SentinelPolaris/ECE115project/Mechanical/Motor/Readme.md

Servo CAD Files acquired and modified from https://grabcad.com/library/150-1-micromotor-gearbox-n20-1
Credit: Sergey Torshin (https://grabcad.com/benjamin.galindo-1)
