SentinelPolaris/ECE115project/Mechanical/Solenoid/Readme.md

Servo CAD Files acquired and modified from https://grabcad.com/library/xrn-0530-12v-solenoid-1
Credit: Greg Esau (https://grabcad.com/library/xrn-0530-12v-solenoid-1)
