SentinelPolaris/ECE115project/Mechanical/Servo/Readme.md

Servo CAD Files acquired and modified from https://grabcad.com/library/tower-pro-sg90-micro-servo-2
Credit: Sergey Torshin (https://grabcad.com/sergey.torshin-1)
