SentinelPolaris/ECE115project/Software/Pinball/CMakeListsPrivate.txt

# !!! WARNING !!! AUTO-GENERATED FILE, PLEASE DO NOT MODIFY IT AND USE
# https://docs.platformio.org/page/projectconf/section_env_build.html#build-flags
#
# If you need to override existing CMake configuration or add extra,
# please create `CMakeListsUser.txt` in the root of project.
# The `CMakeListsUser.txt` will not be overwritten by PlatformIO.

set(CMAKE_CONFIGURATION_TYPES "teensy40" CACHE STRING "" FORCE)

set(PLATFORMIO_CMD "/usr/local/bin/pio")

SET(CMAKE_C_COMPILER "$ENV{HOME}/.platformio/packages/toolchain-gccarmnoneeabi/bin/arm-none-eabi-gcc")
SET(CMAKE_CXX_COMPILER "$ENV{HOME}/.platformio/packages/toolchain-gccarmnoneeabi/bin/arm-none-eabi-g++")
SET(CMAKE_CXX_FLAGS "-fno-exceptions -felide-constructors -fno-rtti -std=gnu++14 -Wno-error=narrowing -fpermissive -Wall -ffunction-sections -fdata-sections -mthumb -mcpu=cortex-m7 -nostdlib -fsingle-precision-constant -mfloat-abi=hard -mfpu=fpv5-d16 -O2")
SET(CMAKE_C_FLAGS "-Wall -ffunction-sections -fdata-sections -mthumb -mcpu=cortex-m7 -nostdlib -fsingle-precision-constant -mfloat-abi=hard -mfpu=fpv5-d16 -O2")

set(CMAKE_CXX_STANDARD 14)

if (CMAKE_BUILD_TYPE MATCHES "teensy40")
    add_definitions(-D'PLATFORMIO=40201')
    add_definitions(-D'__IMXRT1062__')
    add_definitions(-D'TEENSY40')
    add_definitions(-D'USB_SERIAL')
    add_definitions(-D'ARDUINO=10805')
    add_definitions(-D'TEENSYDUINO=149')
    add_definitions(-D'CORE_TEENSY')
    add_definitions(-D'F_CPU=600000000')
    add_definitions(-D'LAYOUT_US_ENGLISH')

    include_directories("${CMAKE_CURRENT_LIST_DIR}/src")
    include_directories("$ENV{HOME}/.platformio/packages/framework-arduinoteensy/libraries/Audio")
    include_directories("$ENV{HOME}/.platformio/packages/framework-arduinoteensy/libraries/Audio/utility")
    include_directories("$ENV{HOME}/.platformio/packages/framework-arduinoteensy/libraries/SD")
    include_directories("$ENV{HOME}/.platformio/packages/framework-arduinoteensy/libraries/SD/utility")
    include_directories("$ENV{HOME}/.platformio/packages/framework-arduinoteensy/libraries/SerialFlash")
    include_directories("$ENV{HOME}/.platformio/packages/framework-arduinoteensy/libraries/SPI")
    include_directories("${CMAKE_CURRENT_LIST_DIR}/include")
    include_directories("${CMAKE_CURRENT_LIST_DIR}/lib/FreeRTOS-Teensy4-runtime_stats/src")
    include_directories("${CMAKE_CURRENT_LIST_DIR}/.pio/libdeps/teensy40/Adafruit MCP23017 Arduino Library_ID334")
    include_directories("${CMAKE_CURRENT_LIST_DIR}/.pio/libdeps/teensy40/Adafruit PWM Servo Driver Library_ID30")
    include_directories("$ENV{HOME}/.platformio/packages/framework-arduinoteensy/libraries/Wire")
    include_directories("$ENV{HOME}/.platformio/packages/framework-arduinoteensy/libraries/Wire/utility")
    include_directories("$ENV{HOME}/.platformio/packages/framework-arduinoteensy/cores/teensy4")
    include_directories("$ENV{HOME}/.platformio/lib/Adafruit Motor Shield V2 Library_ID783")
    include_directories("$ENV{HOME}/.platformio/lib/Adafruit Motor Shield V2 Library_ID783/utility")
    include_directories("$ENV{HOME}/.platformio/lib/TimerOne_ID131")
    include_directories("$ENV{HOME}/.platformio/packages/framework-arduinoteensy/libraries/ADC")
    include_directories("$ENV{HOME}/.platformio/packages/framework-arduinoteensy/libraries/AccelStepper/src")
    include_directories("$ENV{HOME}/.platformio/packages/framework-arduinoteensy/libraries/Adafruit_CC3000")
    include_directories("$ENV{HOME}/.platformio/packages/framework-arduinoteensy/libraries/Adafruit_CC3000/utility")
    include_directories("$ENV{HOME}/.platformio/packages/framework-arduinoteensy/libraries/Adafruit_GFX")
    include_directories("$ENV{HOME}/.platformio/packages/framework-arduinoteensy/libraries/Adafruit_NeoPixel")
    include_directories("$ENV{HOME}/.platformio/packages/framework-arduinoteensy/libraries/Adafruit_RA8875")
    include_directories("$ENV{HOME}/.platformio/packages/framework-arduinoteensy/libraries/Adafruit_STMPE610")
    include_directories("$ENV{HOME}/.platformio/packages/framework-arduinoteensy/libraries/Adafruit_VS1053")
    include_directories("$ENV{HOME}/.platformio/packages/framework-arduinoteensy/libraries/Adafruit_nRF8001")
    include_directories("$ENV{HOME}/.platformio/packages/framework-arduinoteensy/libraries/Adafruit_nRF8001/utility")
    include_directories("$ENV{HOME}/.platformio/packages/framework-arduinoteensy/libraries/AltSoftSerial")
    include_directories("$ENV{HOME}/.platformio/packages/framework-arduinoteensy/libraries/Artnet")
    include_directories("$ENV{HOME}/.platformio/packages/framework-arduinoteensy/libraries/Bounce")
    include_directories("$ENV{HOME}/.platformio/packages/framework-arduinoteensy/libraries/Bounce2")
    include_directories("$ENV{HOME}/.platformio/packages/framework-arduinoteensy/libraries/CapacitiveSensor")
    include_directories("$ENV{HOME}/.platformio/packages/framework-arduinoteensy/libraries/CryptoAccel/src")
    include_directories("$ENV{HOME}/.platformio/packages/framework-arduinoteensy/libraries/DS1307RTC")
    include_directories("$ENV{HOME}/.platformio/packages/framework-arduinoteensy/libraries/DmxSimple")
    include_directories("$ENV{HOME}/.platformio/packages/framework-arduinoteensy/libraries/DogLcd")
    include_directories("$ENV{HOME}/.platformio/packages/framework-arduinoteensy/libraries/EEPROM")
    include_directories("$ENV{HOME}/.platformio/packages/framework-arduinoteensy/libraries/EasyTransfer")
    include_directories("$ENV{HOME}/.platformio/packages/framework-arduinoteensy/libraries/EasyTransferI2C")
    include_directories("$ENV{HOME}/.platformio/packages/framework-arduinoteensy/libraries/Encoder")
    include_directories("$ENV{HOME}/.platformio/packages/framework-arduinoteensy/libraries/Encoder/utility")
    include_directories("$ENV{HOME}/.platformio/packages/framework-arduinoteensy/libraries/Entropy")
    include_directories("$ENV{HOME}/.platformio/packages/framework-arduinoteensy/libraries/Ethernet/src")
    include_directories("$ENV{HOME}/.platformio/packages/framework-arduinoteensy/libraries/FastCRC")
    include_directories("$ENV{HOME}/.platformio/packages/framework-arduinoteensy/libraries/FastLED")
    include_directories("$ENV{HOME}/.platformio/packages/framework-arduinoteensy/libraries/FlexCAN")
    include_directories("$ENV{HOME}/.platformio/packages/framework-arduinoteensy/libraries/FlexCAN_T4")
    include_directories("$ENV{HOME}/.platformio/packages/framework-arduinoteensy/libraries/FlexiTimer2")
    include_directories("$ENV{HOME}/.platformio/packages/framework-arduinoteensy/libraries/FreqCount")
    include_directories("$ENV{HOME}/.platformio/packages/framework-arduinoteensy/libraries/FreqMeasure")
    include_directories("$ENV{HOME}/.platformio/packages/framework-arduinoteensy/libraries/FreqMeasureMulti")
    include_directories("$ENV{HOME}/.platformio/packages/framework-arduinoteensy/libraries/FrequencyTimer2")
    include_directories("$ENV{HOME}/.platformio/packages/framework-arduinoteensy/libraries/ILI9341_t3")
    include_directories("$ENV{HOME}/.platformio/packages/framework-arduinoteensy/libraries/ILI9488_t3")
    include_directories("$ENV{HOME}/.platformio/packages/framework-arduinoteensy/libraries/IRremote")
    include_directories("$ENV{HOME}/.platformio/packages/framework-arduinoteensy/libraries/Keypad/src")
    include_directories("$ENV{HOME}/.platformio/packages/framework-arduinoteensy/libraries/LedControl/src")
    include_directories("$ENV{HOME}/.platformio/packages/framework-arduinoteensy/libraries/LedDisplay")
    include_directories("$ENV{HOME}/.platformio/packages/framework-arduinoteensy/libraries/LiquidCrystal/src")
    include_directories("$ENV{HOME}/.platformio/packages/framework-arduinoteensy/libraries/LiquidCrystalFast")
    include_directories("$ENV{HOME}/.platformio/packages/framework-arduinoteensy/libraries/LowPower")
    include_directories("$ENV{HOME}/.platformio/packages/framework-arduinoteensy/libraries/MFRC522/src")
    include_directories("$ENV{HOME}/.platformio/packages/framework-arduinoteensy/libraries/MIDI/src")
    include_directories("$ENV{HOME}/.platformio/packages/framework-arduinoteensy/libraries/Metro")
    include_directories("$ENV{HOME}/.platformio/packages/framework-arduinoteensy/libraries/MsTimer2")
    include_directories("$ENV{HOME}/.platformio/packages/framework-arduinoteensy/libraries/NXPMotionSense")
    include_directories("$ENV{HOME}/.platformio/packages/framework-arduinoteensy/libraries/NXPMotionSense/utility")
    include_directories("$ENV{HOME}/.platformio/packages/framework-arduinoteensy/libraries/OSC")
    include_directories("$ENV{HOME}/.platformio/packages/framework-arduinoteensy/libraries/OctoWS2811")
    include_directories("$ENV{HOME}/.platformio/packages/framework-arduinoteensy/libraries/OneWire")
    include_directories("$ENV{HOME}/.platformio/packages/framework-arduinoteensy/libraries/PS2Keyboard")
    include_directories("$ENV{HOME}/.platformio/packages/framework-arduinoteensy/libraries/PS2Keyboard/utility")
    include_directories("$ENV{HOME}/.platformio/packages/framework-arduinoteensy/libraries/PWMServo")
    include_directories("$ENV{HOME}/.platformio/packages/framework-arduinoteensy/libraries/Ping")
    include_directories("$ENV{HOME}/.platformio/packages/framework-arduinoteensy/libraries/PulsePosition")
    include_directories("$ENV{HOME}/.platformio/packages/framework-arduinoteensy/libraries/QuadEncoder")
    include_directories("$ENV{HOME}/.platformio/packages/framework-arduinoteensy/libraries/RA8875")
    include_directories("$ENV{HOME}/.platformio/packages/framework-arduinoteensy/libraries/RadioHead")
    include_directories("$ENV{HOME}/.platformio/packages/framework-arduinoteensy/libraries/ResponsiveAnalogRead/src")
    include_directories("$ENV{HOME}/.platformio/packages/framework-arduinoteensy/libraries/SPIFlash")
    include_directories("$ENV{HOME}/.platformio/packages/framework-arduinoteensy/libraries/ST7565")
    include_directories("$ENV{HOME}/.platformio/packages/framework-arduinoteensy/libraries/ST7735_t3")
    include_directories("$ENV{HOME}/.platformio/packages/framework-arduinoteensy/libraries/Servo")
    include_directories("$ENV{HOME}/.platformio/packages/framework-arduinoteensy/libraries/ShiftPWM")
    include_directories("$ENV{HOME}/.platformio/packages/framework-arduinoteensy/libraries/Snooze/src")
    include_directories("$ENV{HOME}/.platformio/packages/framework-arduinoteensy/libraries/SoftPWM")
    include_directories("$ENV{HOME}/.platformio/packages/framework-arduinoteensy/libraries/SoftwareSerial")
    include_directories("$ENV{HOME}/.platformio/packages/framework-arduinoteensy/libraries/TFT_ILI9163C")
    include_directories("$ENV{HOME}/.platformio/packages/framework-arduinoteensy/libraries/Talkie")
    include_directories("$ENV{HOME}/.platformio/packages/framework-arduinoteensy/libraries/TeensyThreads")
    include_directories("$ENV{HOME}/.platformio/packages/framework-arduinoteensy/libraries/Time")
    include_directories("$ENV{HOME}/.platformio/packages/framework-arduinoteensy/libraries/TimeAlarms")
    include_directories("$ENV{HOME}/.platformio/packages/framework-arduinoteensy/libraries/TimerOne")
    include_directories("$ENV{HOME}/.platformio/packages/framework-arduinoteensy/libraries/TimerThree")
    include_directories("$ENV{HOME}/.platformio/packages/framework-arduinoteensy/libraries/TinyGPS")
    include_directories("$ENV{HOME}/.platformio/packages/framework-arduinoteensy/libraries/Tlc5940")
    include_directories("$ENV{HOME}/.platformio/packages/framework-arduinoteensy/libraries/TouchScreen")
    include_directories("$ENV{HOME}/.platformio/packages/framework-arduinoteensy/libraries/USBHost_t36")
    include_directories("$ENV{HOME}/.platformio/packages/framework-arduinoteensy/libraries/USBHost_t36/utility")
    include_directories("$ENV{HOME}/.platformio/packages/framework-arduinoteensy/libraries/UTFT")
    include_directories("$ENV{HOME}/.platformio/packages/framework-arduinoteensy/libraries/VirtualWire")
    include_directories("$ENV{HOME}/.platformio/packages/framework-arduinoteensy/libraries/WS2812Serial")
    include_directories("$ENV{HOME}/.platformio/packages/framework-arduinoteensy/libraries/XBee")
    include_directories("$ENV{HOME}/.platformio/packages/framework-arduinoteensy/libraries/XPT2046_Touchscreen")
    include_directories("$ENV{HOME}/.platformio/packages/framework-arduinoteensy/libraries/i2c_t3")
    include_directories("$ENV{HOME}/.platformio/packages/framework-arduinoteensy/libraries/ks0108")
    include_directories("$ENV{HOME}/.platformio/packages/framework-arduinoteensy/libraries/openGLCD")
    include_directories("$ENV{HOME}/.platformio/packages/framework-arduinoteensy/libraries/ssd1351")
    include_directories("$ENV{HOME}/.platformio/packages/framework-arduinoteensy/libraries/x10")
    include_directories("$ENV{HOME}/.platformio/packages/toolchain-gccarmnoneeabi/arm-none-eabi/include")
    include_directories("$ENV{HOME}/.platformio/packages/toolchain-gccarmnoneeabi/arm-none-eabi/include/c++/5.4.1")
    include_directories("$ENV{HOME}/.platformio/packages/toolchain-gccarmnoneeabi/arm-none-eabi/include/c++/5.4.1/arm-none-eabi")
    include_directories("$ENV{HOME}/.platformio/packages/toolchain-gccarmnoneeabi/lib/gcc/arm-none-eabi/5.4.1/include")
    include_directories("$ENV{HOME}/.platformio/packages/toolchain-gccarmnoneeabi/lib/gcc/arm-none-eabi/5.4.1/include-fixed")
    include_directories("$ENV{HOME}/.platformio/packages/tool-unity")
endif()

FILE(GLOB_RECURSE SRC_LIST "${CMAKE_CURRENT_LIST_DIR}/src/*.*" "${CMAKE_CURRENT_LIST_DIR}/lib/*.*" "${CMAKE_CURRENT_LIST_DIR}/.pio/libdeps/teensy40/*.*")
