SentinelPolaris/ECE115project/Software/Pinball/CMakeListsUser.txt

message("CMakeListsUser!")
include_directories(${CMAKE_CURRENT_LIST_DIR}/lib/FreeRTOS-Teensy4-runtime_stats/src)
