SentinelPolaris/ECE115project/Mechanical/ServoRamp.SLDASM

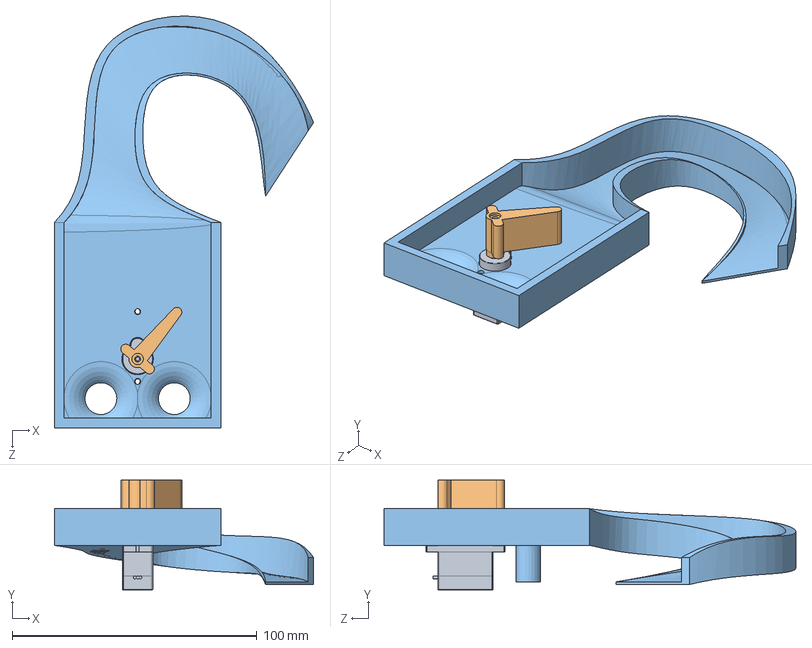
[picture p1: CAD file, 2020-03-10]
Mechanical/ServoRamp.SLDASM
105.9 x 44.9 x 168.4 mm
microservoSG90
microservoArm
RampTop
