SentinelPolaris/ECE115project/Mechanical/Final.SLDASM

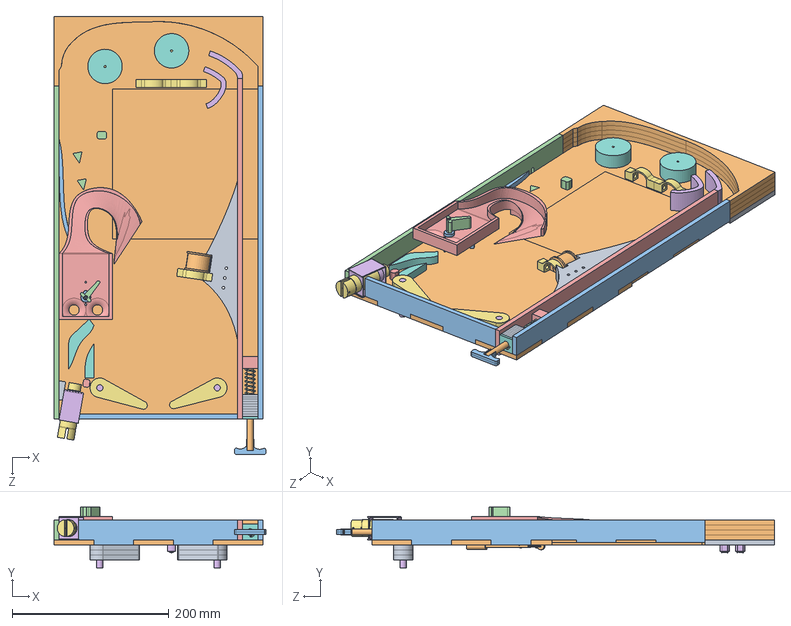
[picture p2: CAD file, 2020-03-10]
Mechanical/Final.SLDASM
270.4 x 77.3 x 559.5 mm
FrameTopWallBottom
FrameTopWallTop x 4
FrameSideWallRight
FrameSideWallLeft
FrameTunnelWall
EMGuide
IRGate x 3
base plate
hole plate x 9
PlungerRod
pullhandle x 2
spring
tip_v2
flipper_rod x 2
flipper_arm x 4
bearing x 2
flipper_back x 6
FrameBottomPlate
microservoSG90
microservoArm
RampTop
TAU-1040T
TAU-1040T Plunger
RampGuide
SolenoidGuide
MagneticLauncher
SliderGuide
IRGateHalf
IRGateHalfSolenoid
Motor x 2
Brazo x 2
N20Wheel x 2
EMlauncherGuide
PanelAcrylic
FrameBottomWall
SliderAcrylic x 2
