SentinelPolaris/ECE115project/Mechanical/N20.SLDASM

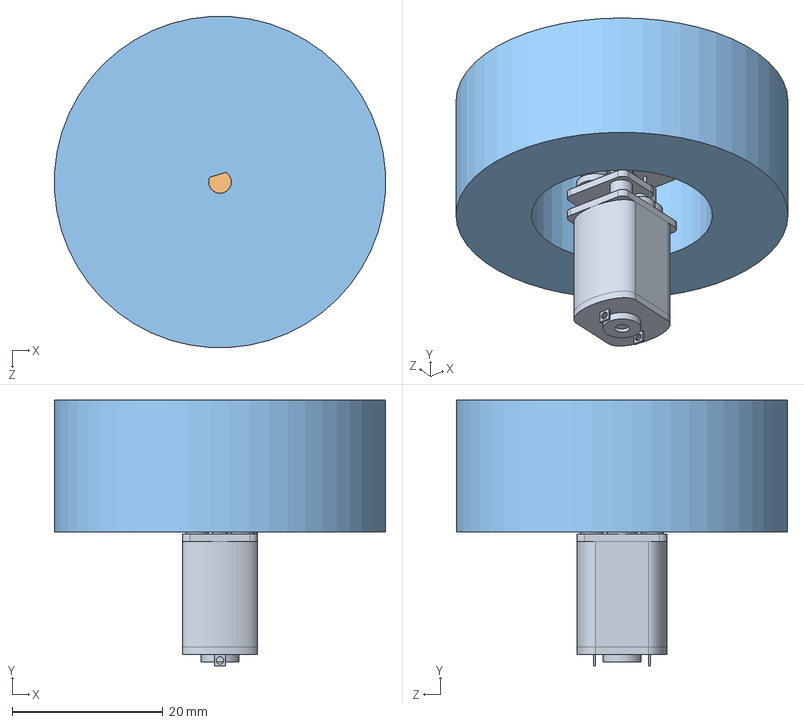
[picture p3: CAD file, 2020-02-17]
Mechanical/N20.SLDASM
43.9 x 35.3 x 43.9 mm
Motor
Brazo
N20Wheel
