SentinelPolaris/ECE115project/Mechanical/FlipperRight.SLDASM

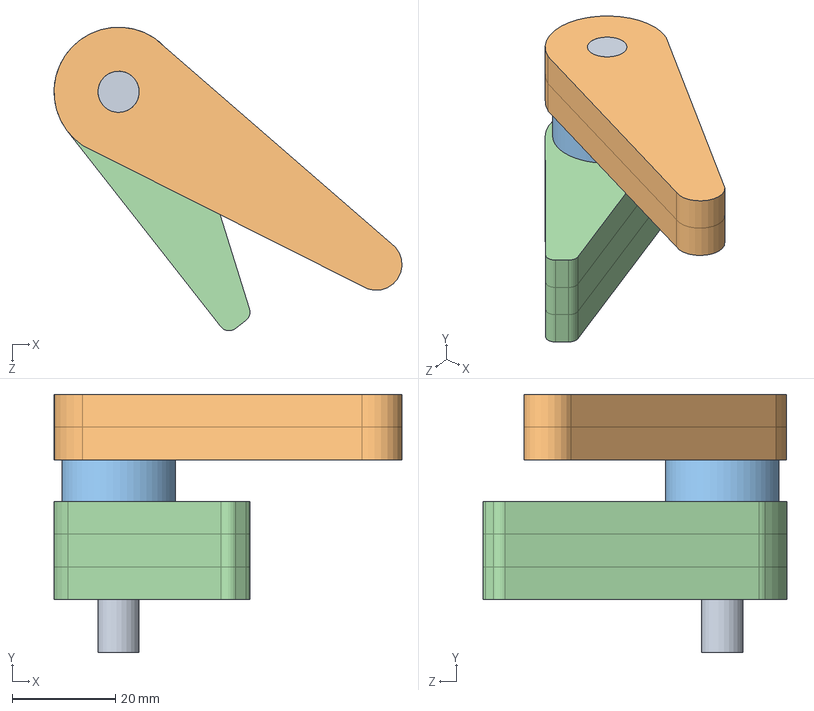
[picture p4: CAD file, 2020-02-14]
Mechanical/FlipperRight.SLDASM
67.3 x 50.0 x 58.7 mm
flipper_rod
flipper_arm x 2
bearing
flipper_back x 3
