SentinelPolaris/ECE115project/Mechanical/Servo.SLDASM

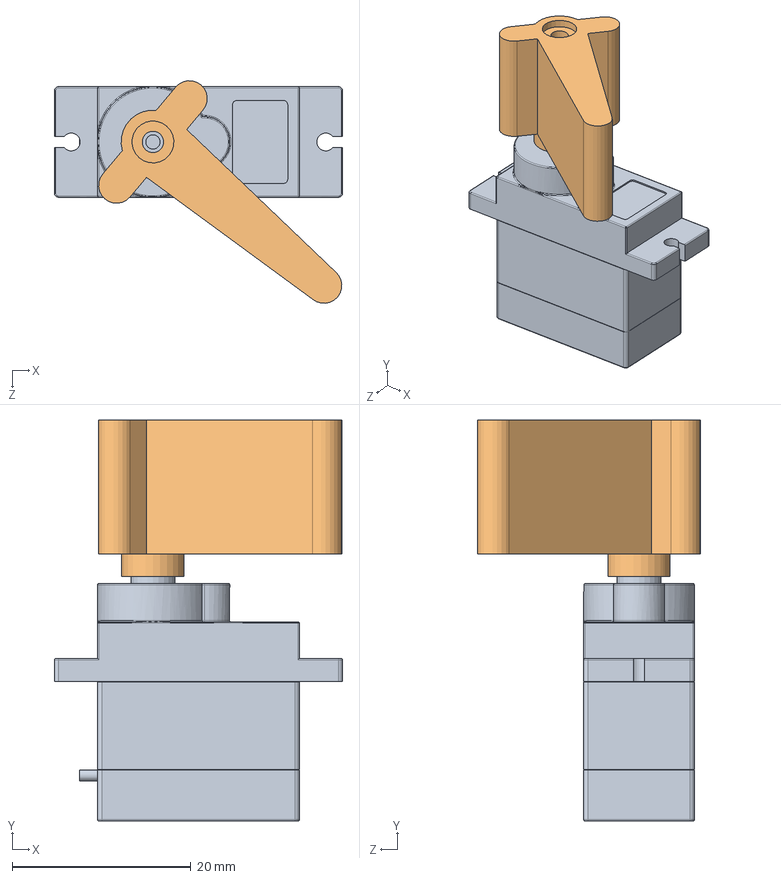
[picture p5: CAD file, 2020-02-14]
Mechanical/Servo.SLDASM
32.3 x 44.9 x 24.9 mm
microservoSG90
microservoArm
