SentinelPolaris/ECE115project/Mechanical/Filpper/FlipperTester.SLDASM

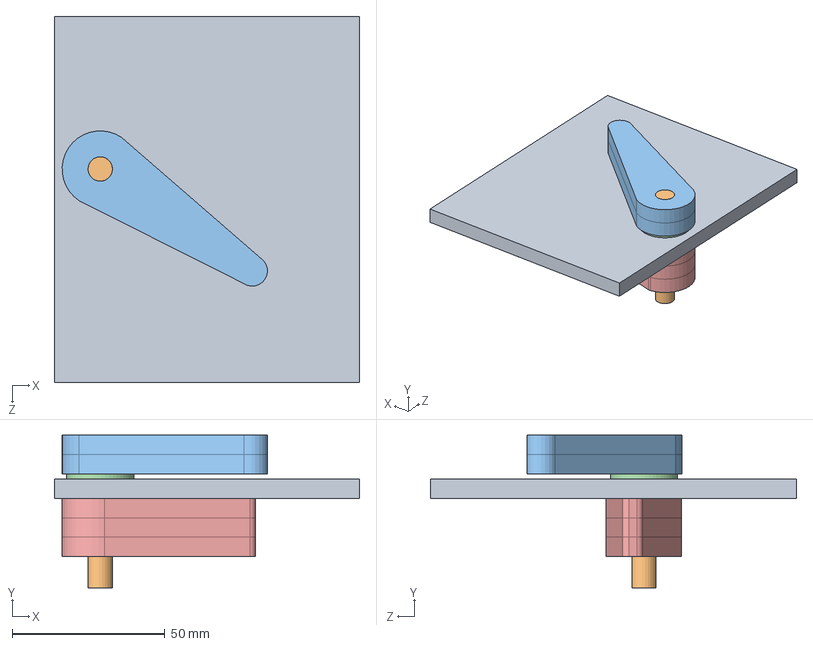
[picture p6: CAD file, 2020-01-29]
Mechanical/Filpper/FlipperTester.SLDASM
100.0 x 50.0 x 120.0 mm
flipper_test_base
flipper_rod
flipper_arm x 2
bearing
flipper_back x 3
