SentinelPolaris/ECE115project/Mechanical/Solenoid.SLDASM

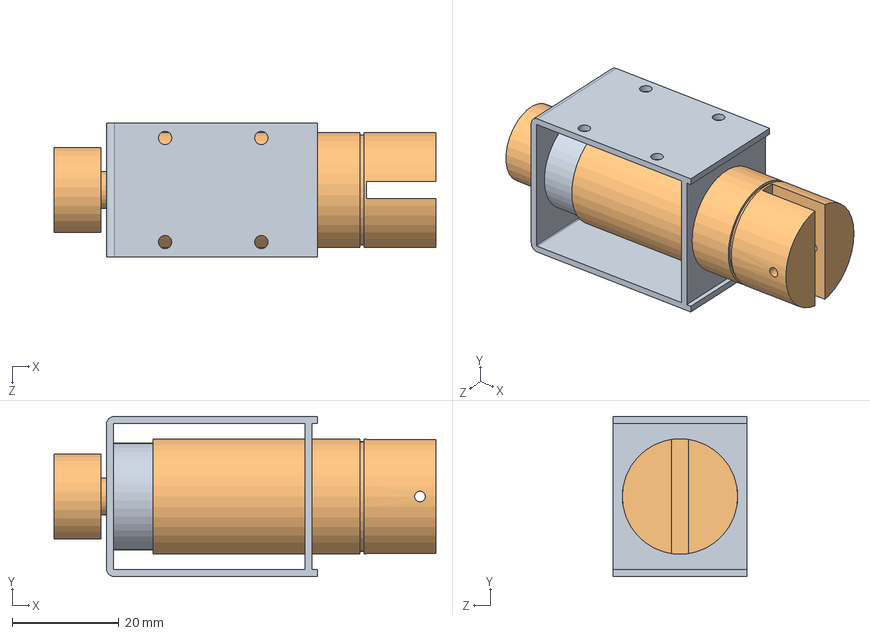
[picture p7: CAD file, 2020-02-14]
Mechanical/Solenoid.SLDASM
71.5 x 30.0 x 25.0 mm
TAU-1040T
TAU-1040T Plunger
