SentinelPolaris/ECE115project/Mechanical/FlipperLeft.SLDASM

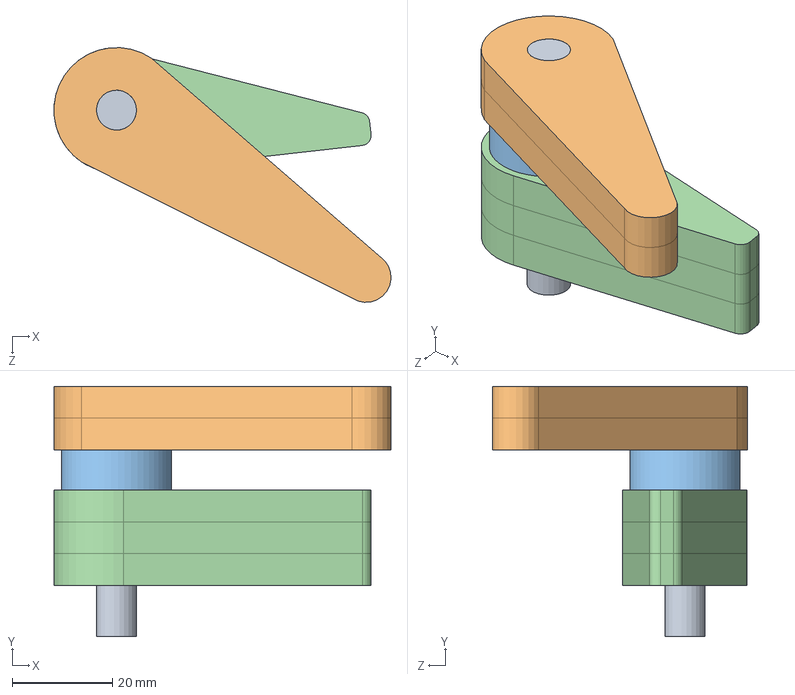
[picture p8: CAD file, 2020-02-14]
Mechanical/FlipperLeft.SLDASM
67.3 x 50.0 x 50.9 mm
flipper_rod
flipper_arm x 2
bearing
flipper_back x 3
