SentinelPolaris/ECE115project/Mechanical/Plunger.SLDASM

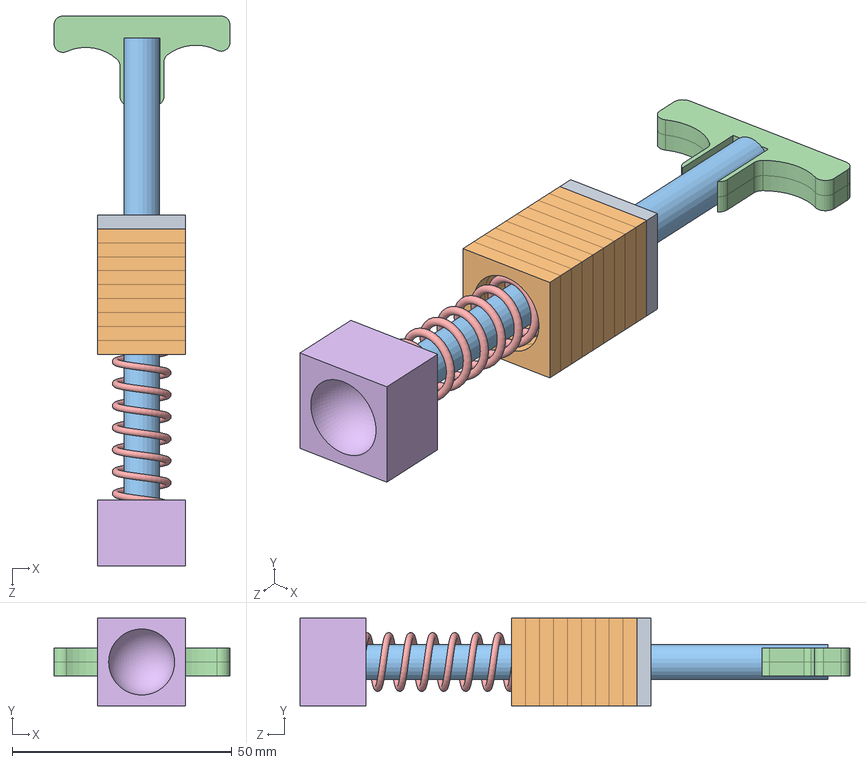
[picture p9: CAD file, 2020-02-14]
Mechanical/Plunger.SLDASM
40.0 x 20.0 x 125.0 mm
base plate
hole plate x 9
PlungerRod
pullhandle x 2
spring
tip_v2
