SentinelPolaris/ECE115project/Mechanical/Filpper/flipper laser/flipper_back.DXF

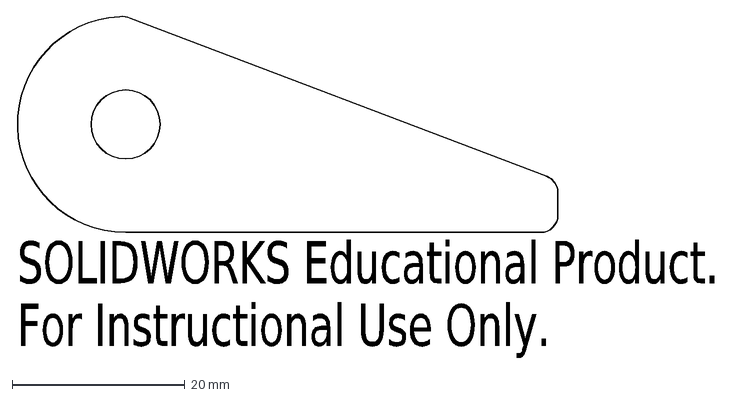
[picture p10: CAD file, 2020-01-29]
Mechanical/Filpper/flipper laser/flipper_back.DXF
SOLIDWORKS Educational Product.
For Instructional Use Only.
