SentinelPolaris/ECE115project/Mechanical/Filpper/FlipperHolder.SLDPRT

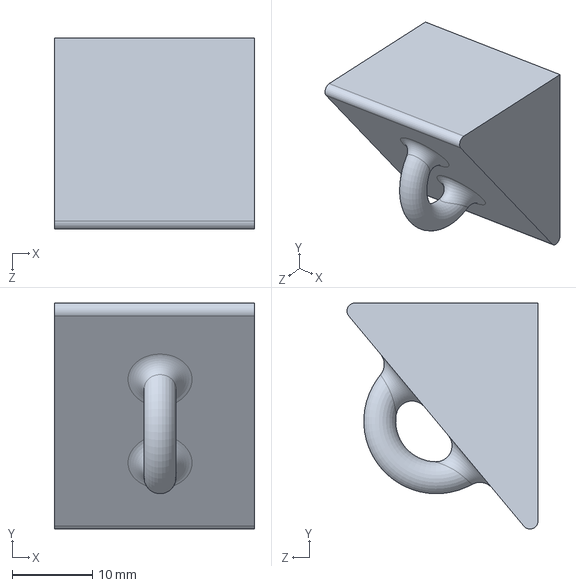
[picture p11: CAD file, 2020-03-10]
Mechanical/Filpper/FlipperHolder.SLDPRT
25.0 x 28.2 x 23.9 mm
