SentinelPolaris/ECE115project/Mechanical/Frame/circuitmount.SLDPRT

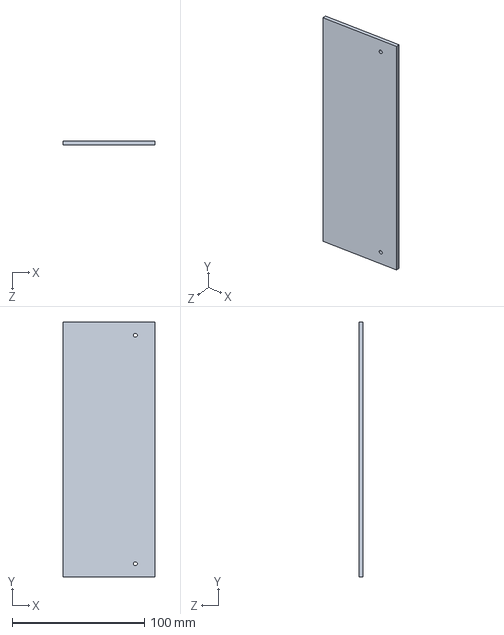
[picture p12: CAD file, 2020-03-10]
Mechanical/Frame/circuitmount.SLDPRT
70.0 x 193.0 x 3.17 mm
