SentinelPolaris/ECE115project/Mechanical/LaserCutting/FrameBottomWall.DXF

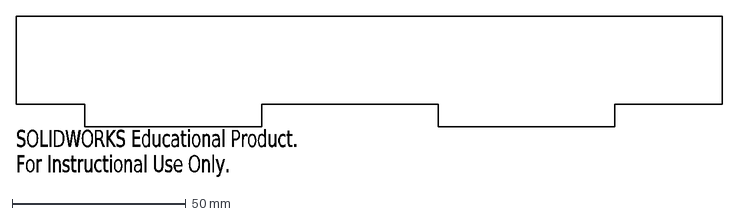
[picture p13: CAD file, 2020-03-10]
Mechanical/LaserCutting/FrameBottomWall.DXF
SOLIDWORKS Educational Product.
For Instructional Use Only.
