SentinelPolaris/ECE115project/Mechanical/MagneticLauncher/MagneticLauncher.SLDPRT

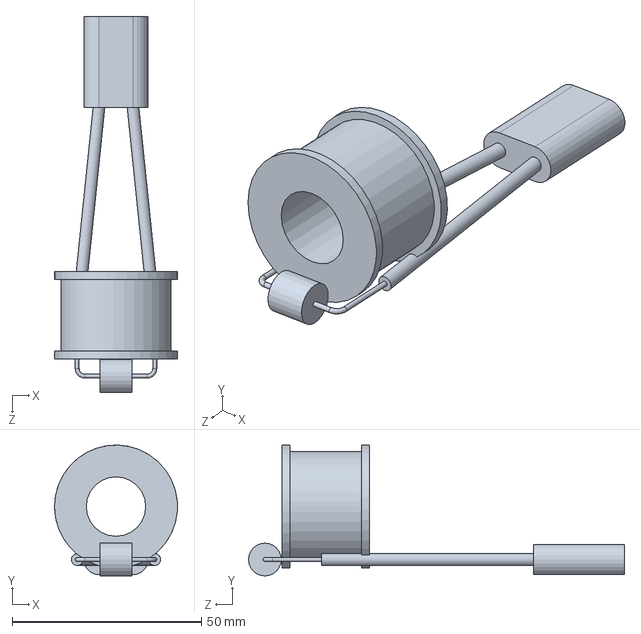
[picture p14: CAD file, 2020-02-14]
Mechanical/MagneticLauncher/MagneticLauncher.SLDPRT
32.5 x 34.6 x 99.3 mm
