SentinelPolaris/ECE115project/Mechanical/Motor/Motor.SLDPRT

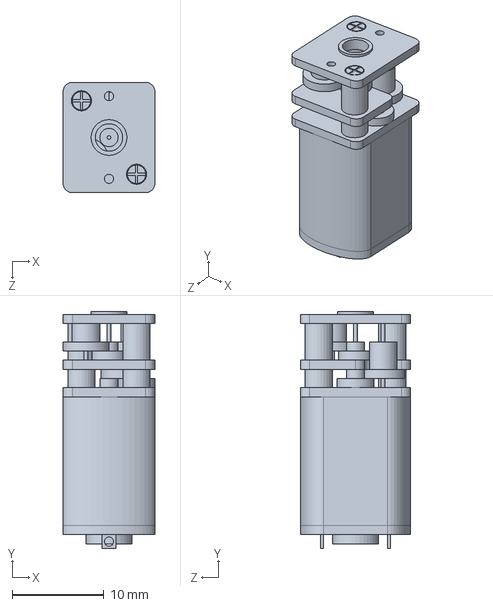
[picture p15: CAD file, 2020-02-16]
Mechanical/Motor/Motor.SLDPRT
10.0 x 25.8 x 12.0 mm
