SentinelPolaris/ECE115project/Mechanical/Plunger/laser/2xbaseplate.DXF

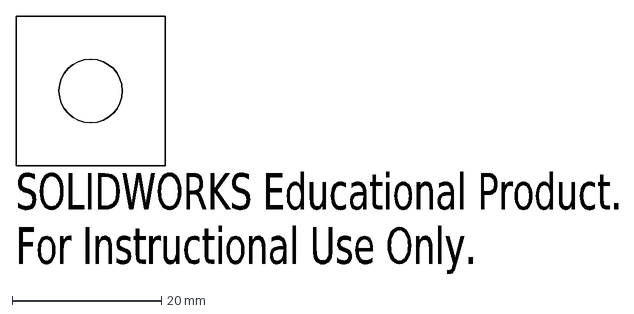
[picture p16: CAD file, 2020-01-15]
Mechanical/Plunger/laser/2xbaseplate.DXF
SOLIDWORKS Educational Product.
For Instructional Use Only.
