SentinelPolaris/ECE115project/Mechanical/Plunger/pullhandle.SLDPRT

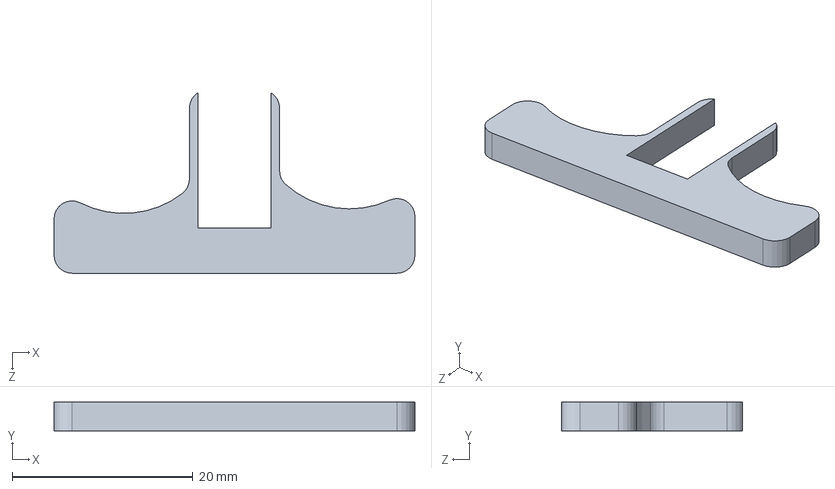
[picture p17: CAD file, 2020-02-14]
Mechanical/Plunger/pullhandle.SLDPRT
40.0 x 3.17 x 20.0 mm
