SentinelPolaris/ECE115project/Mechanical/Ramp/RampTop.SLDPRT

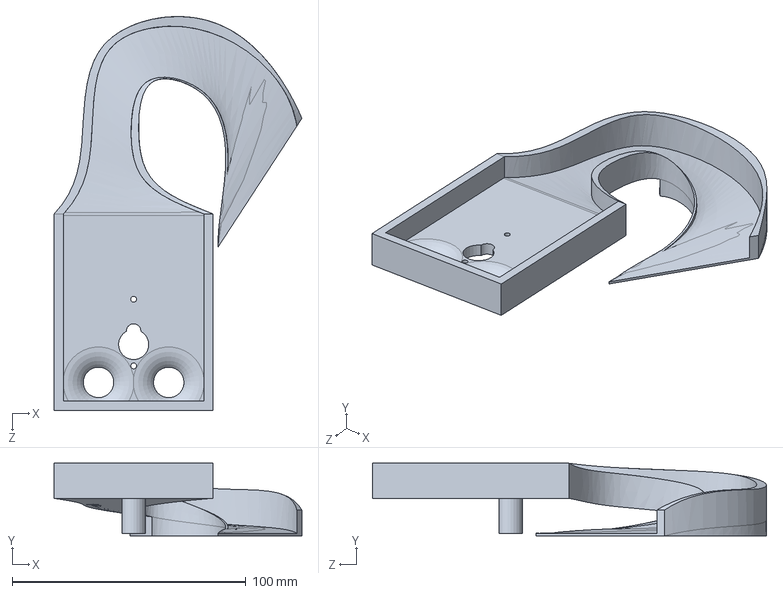
[picture p18: CAD file, 2020-03-10]
Mechanical/Ramp/RampTop.SLDPRT
105.9 x 31.0 x 168.4 mm
