SentinelPolaris/ECE115project/Mechanical/Servo/microservoSG90.SLDPRT

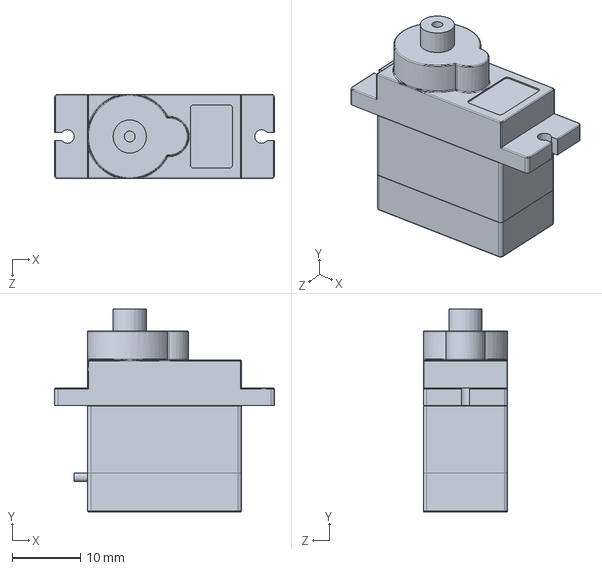
[picture p19: CAD file, 2020-02-14]
Mechanical/Servo/microservoSG90.SLDPRT
32.3 x 29.8 x 12.4 mm
