SentinelPolaris/ECE115project/Mechanical/Solenoid/SolenoidGuide.SLDPRT

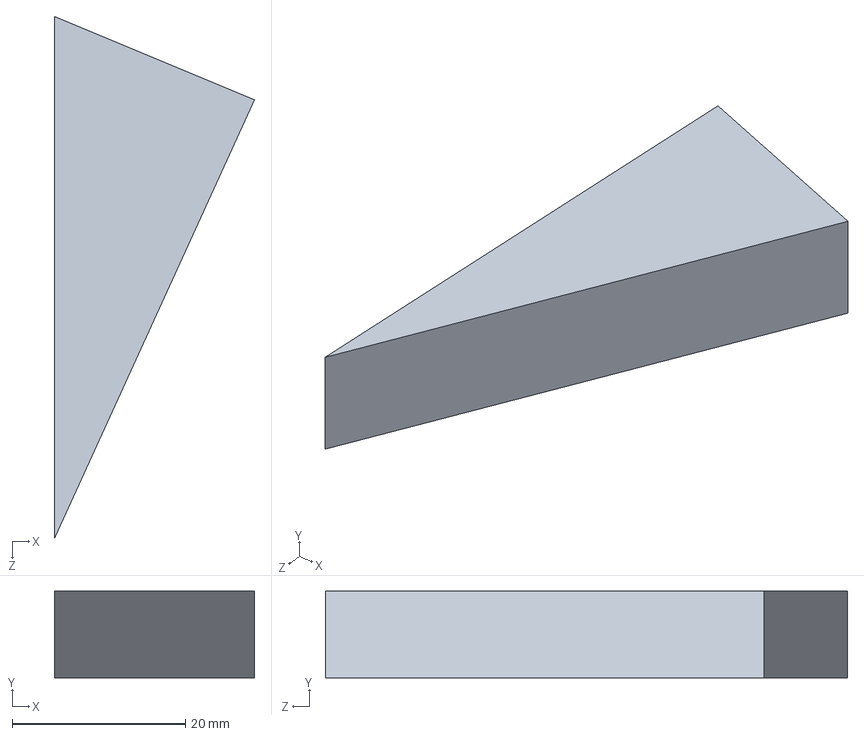
[picture p20: CAD file, 2020-02-14]
Mechanical/Solenoid/SolenoidGuide.SLDPRT
23.1 x 10.0 x 60.2 mm
