SentinelPolaris/ECE115project/Mechanical/Util/AngleSupport.SLDPRT

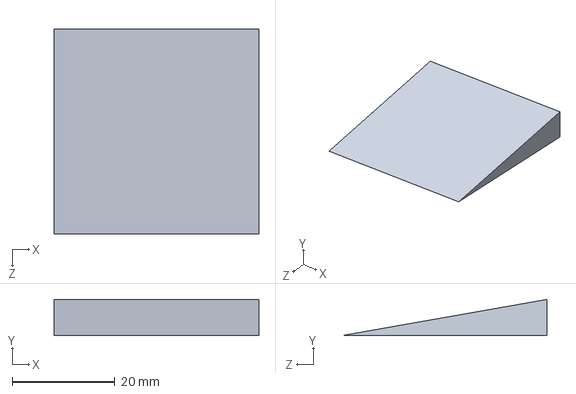
[picture p21: CAD file, 2020-03-10]
Mechanical/Util/AngleSupport.SLDPRT
40.0 x 7.05 x 40.0 mm
