SentinelPolaris/ECE115project/Mechanical/Filpper/bearing.SLDPRT

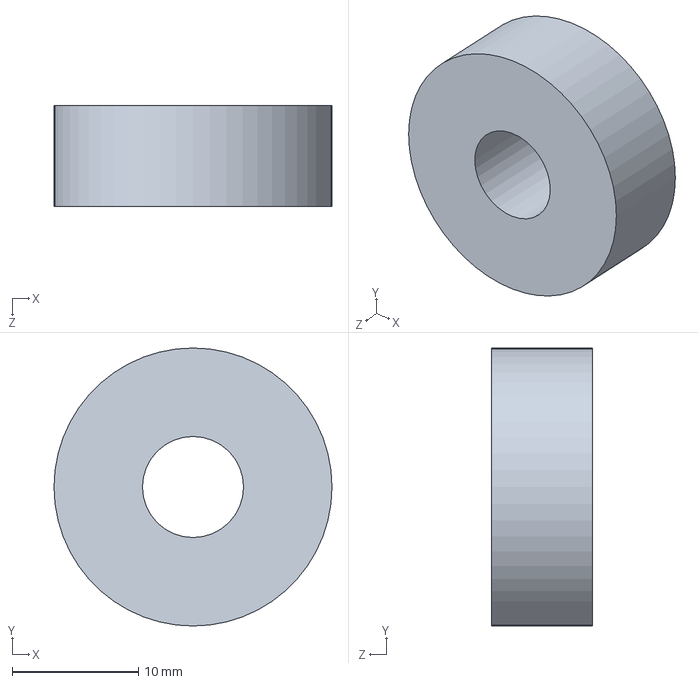
[picture p22: CAD file, 2020-02-14]
Mechanical/Filpper/bearing.SLDPRT
22.0 x 22.0 x 8.00 mm
