SentinelPolaris/ECE115project/Mechanical/Filpper/flipper laser/flipper_arm.DXF

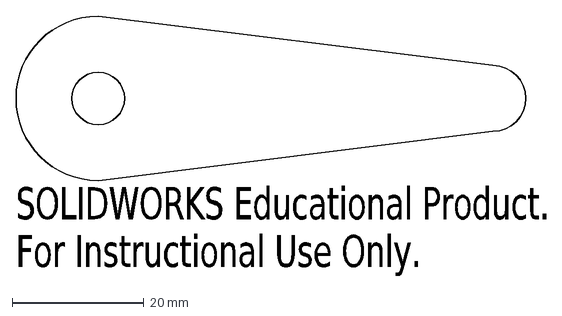
[picture p23: CAD file, 2020-01-29]
Mechanical/Filpper/flipper laser/flipper_arm.DXF
SOLIDWORKS Educational Product.
For Instructional Use Only.
