SentinelPolaris/ECE115project/Mechanical/Frame/FrameTopWallTop.SLDPRT

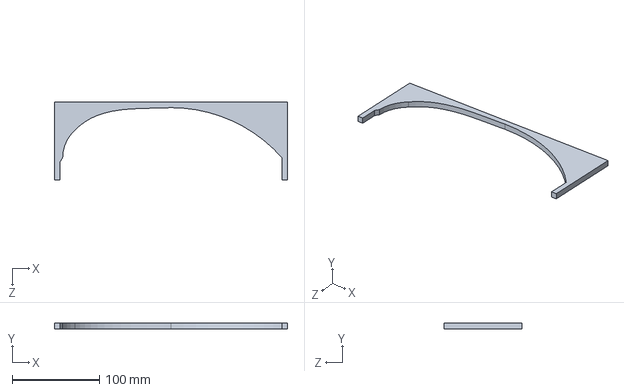
[picture p24: CAD file, 2020-03-10]
Mechanical/Frame/FrameTopWallTop.SLDPRT
266.7 x 6.35 x 89.1 mm
