SentinelPolaris/ECE115project/Mechanical/LaserCutting/FrameSideWallRight.DXF

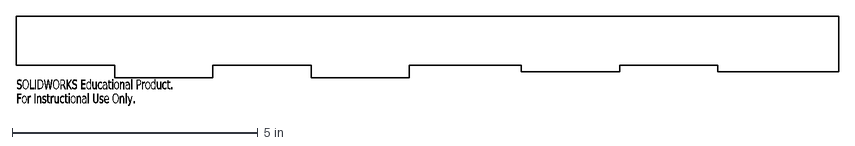
[picture p25: CAD file, 2020-03-10]
Mechanical/LaserCutting/FrameSideWallRight.DXF
SOLIDWORKS Educational Product.
For Instructional Use Only.
