SentinelPolaris/ECE115project/Mechanical/Motor/Brazo.SLDPRT

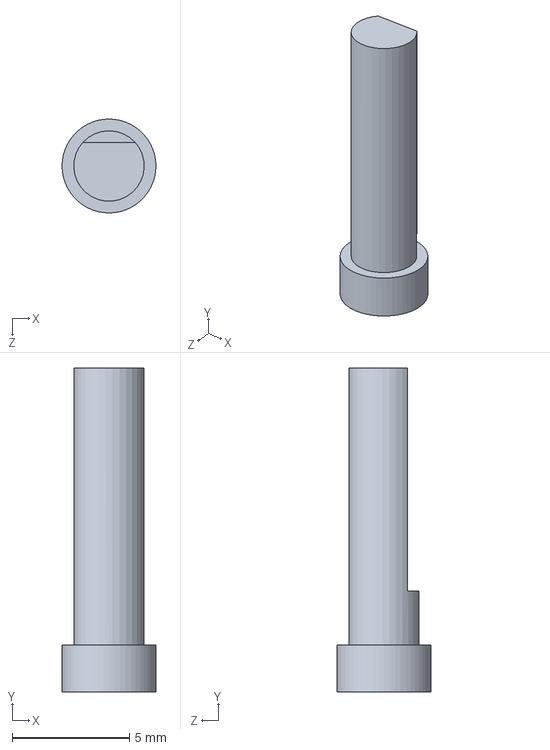
[picture p26: CAD file, 2020-02-16]
Mechanical/Motor/Brazo.SLDPRT
4.00 x 13.8 x 4.00 mm
