SentinelPolaris/ECE115project/Mechanical/Plunger/base plate.SLDPRT

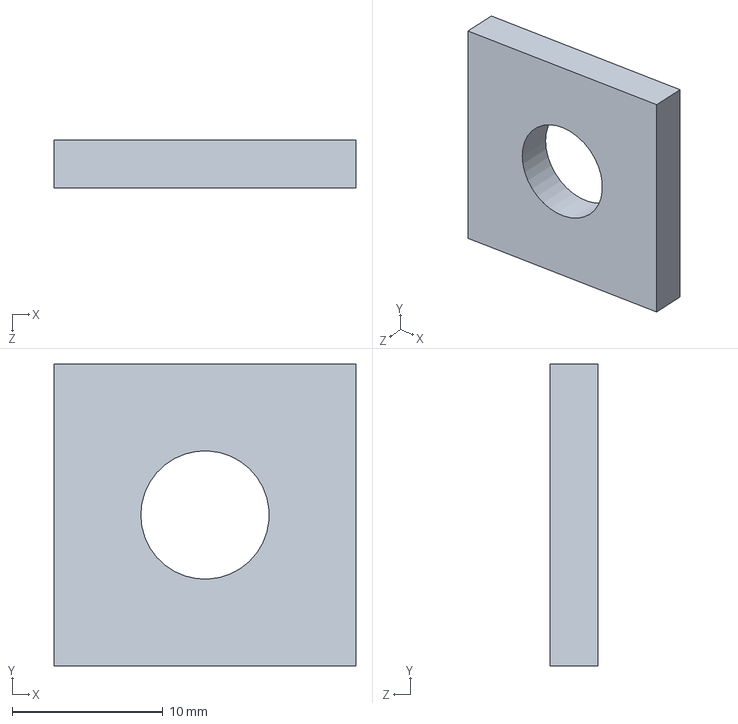
[picture p27: CAD file, 2020-02-14]
Mechanical/Plunger/base plate.SLDPRT
20.0 x 20.0 x 3.17 mm
