SentinelPolaris/ECE115project/Mechanical/Plunger/laser/1xtip.DXF

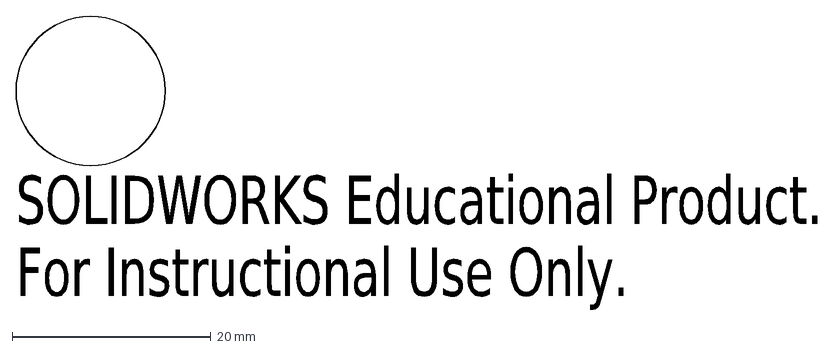
[picture p28: CAD file, 2020-01-15]
Mechanical/Plunger/laser/1xtip.DXF
SOLIDWORKS Educational Product.
For Instructional Use Only.
