SentinelPolaris/ECE115project/Mechanical/Ramp/RampGuide.SLDPRT

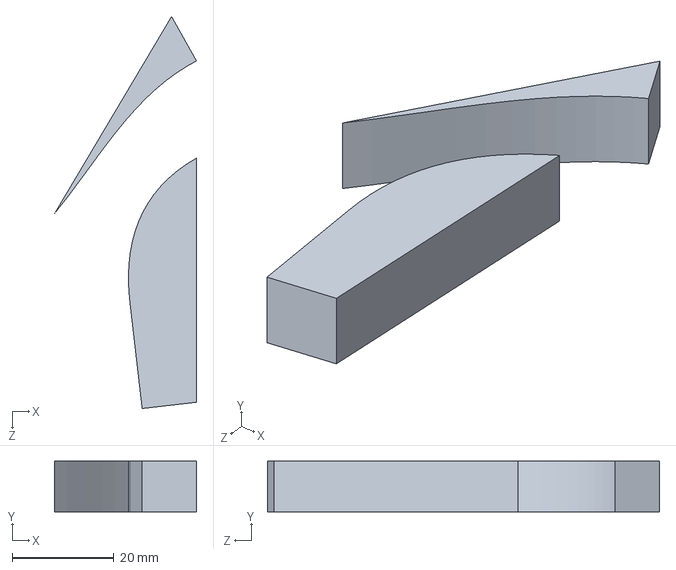
[picture p29: CAD file, 2020-02-14]
Mechanical/Ramp/RampGuide.SLDPRT
27.9 x 10.0 x 76.9 mm
