SentinelPolaris/ECE115project/Mechanical/Servo/microservoArm.SLDPRT

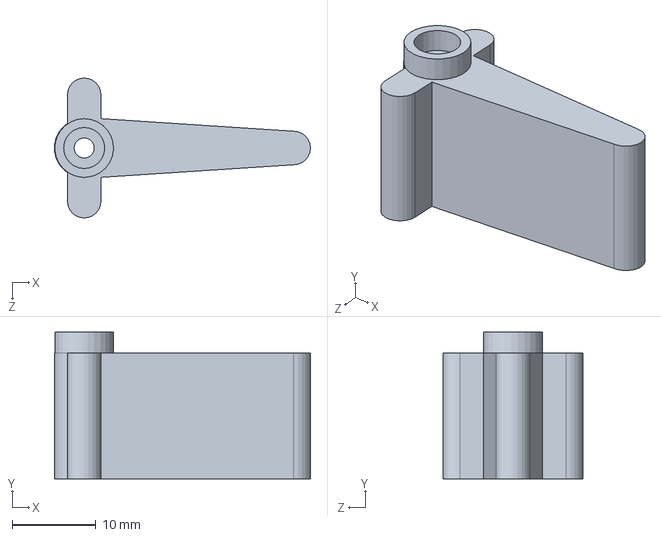
[picture p30: CAD file, 2020-02-14]
Mechanical/Servo/microservoArm.SLDPRT
30.5 x 17.5 x 16.7 mm
