SentinelPolaris/ECE115project/Mechanical/Solenoid/TAU-1040T.SLDPRT

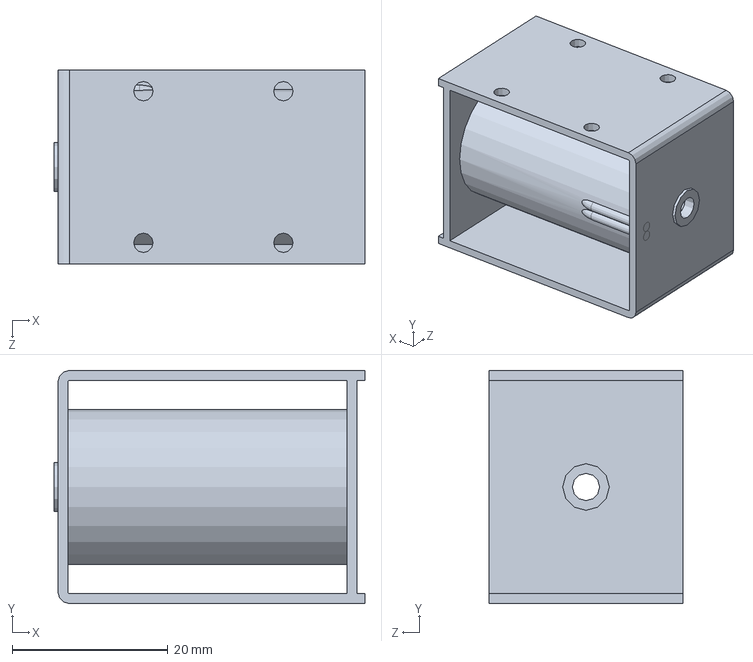
[picture p31: CAD file, 2020-02-14]
Mechanical/Solenoid/TAU-1040T.SLDPRT
40.0 x 30.0 x 25.0 mm
