SentinelPolaris/ECE115project/Mechanical/Util/IRGate.SLDPRT

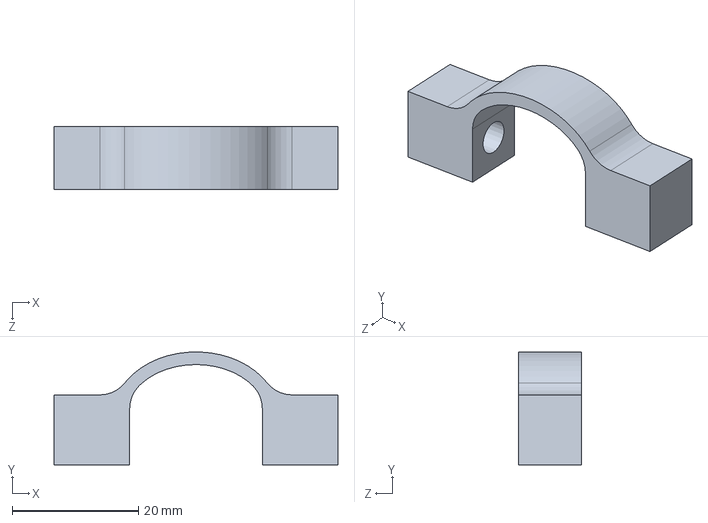
[picture p32: CAD file, 2020-02-14]
Mechanical/Util/IRGate.SLDPRT
45.0 x 17.9 x 10.0 mm
