SentinelPolaris/ECE115project/Mechanical/Filpper/flipper laser/base.DXF

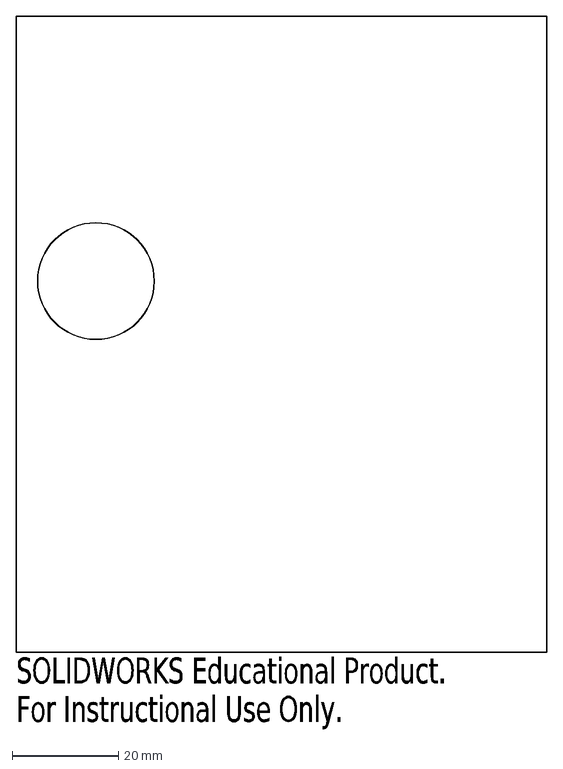
[picture p33: CAD file, 2020-01-29]
Mechanical/Filpper/flipper laser/base.DXF
SOLIDWORKS Educational Product.
For Instructional Use Only.
