SentinelPolaris/ECE115project/Mechanical/Filpper/flipper_arm.SLDPRT

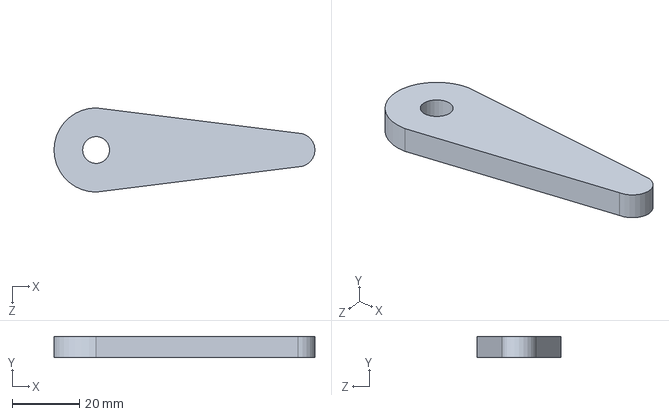
[picture p34: CAD file, 2020-02-14]
Mechanical/Filpper/flipper_arm.SLDPRT
77.5 x 6.35 x 25.0 mm
