SentinelPolaris/ECE115project/Mechanical/Frame/SliderGuide.SLDPRT

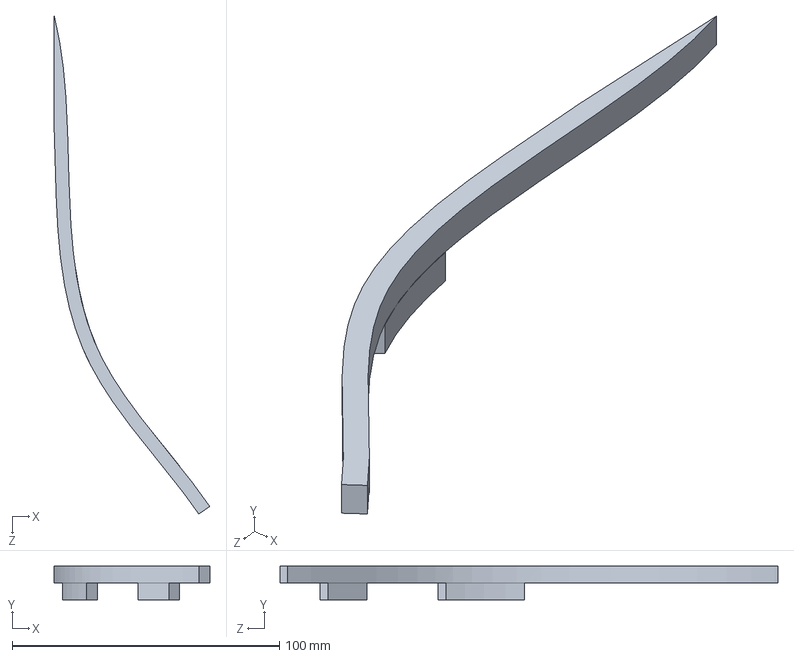
[picture p35: CAD file, 2020-03-10]
Mechanical/Frame/SliderGuide.SLDPRT
58.2 x 12.7 x 186.4 mm
