SentinelPolaris/ECE115project/Mechanical/LaserCutting/FrameSideWallLeft.DXF

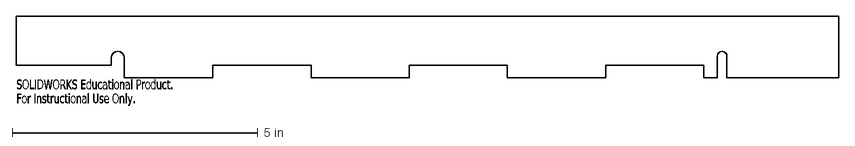
[picture p36: CAD file, 2020-03-10]
Mechanical/LaserCutting/FrameSideWallLeft.DXF
SOLIDWORKS Educational Product.
For Instructional Use Only.
