SentinelPolaris/ECE115project/Mechanical/Plunger/hole plate.SLDPRT

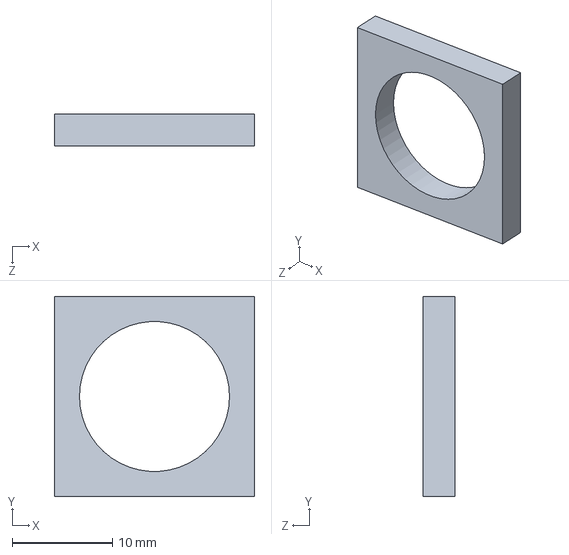
[picture p37: CAD file, 2020-02-14]
Mechanical/Plunger/hole plate.SLDPRT
20.0 x 20.0 x 3.17 mm
