SentinelPolaris/ECE115project/Mechanical/Plunger/laser/8xholePlate.DXF

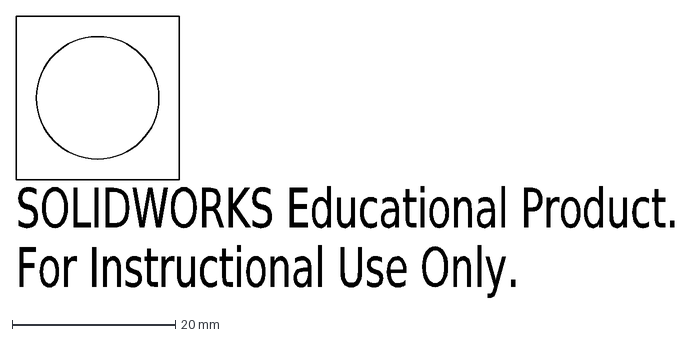
[picture p38: CAD file, 2020-01-15]
Mechanical/Plunger/laser/8xholePlate.DXF
SOLIDWORKS Educational Product.
For Instructional Use Only.
