SentinelPolaris/ECE115project/Mechanical/Solenoid/TAU-1040T Plunger.SLDPRT

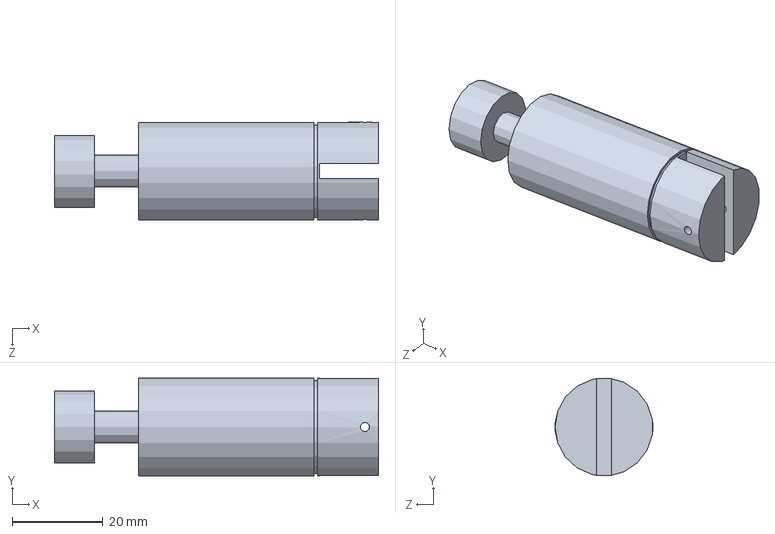
[picture p39: CAD file, 2020-02-14]
Mechanical/Solenoid/TAU-1040T Plunger.SLDPRT
71.5 x 21.5 x 21.6 mm
