SentinelPolaris/ECE115project/Mechanical/Util/EMGuide.SLDPRT

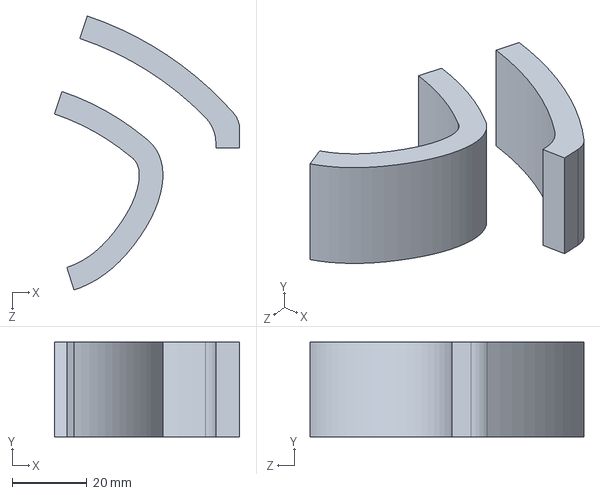
[picture p40: CAD file, 2020-02-14]
Mechanical/Util/EMGuide.SLDPRT
49.7 x 25.4 x 73.5 mm
