SentinelPolaris/ECE115project/Mechanical/Filpper/flipper_back.SLDPRT

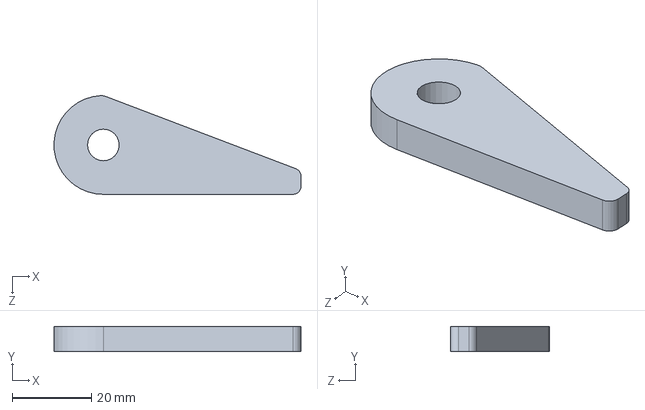
[picture p41: CAD file, 2020-02-14]
Mechanical/Filpper/flipper_back.SLDPRT
62.5 x 6.35 x 25.0 mm
