SentinelPolaris/ECE115project/Mechanical/Frame/circuitHolder.DXF

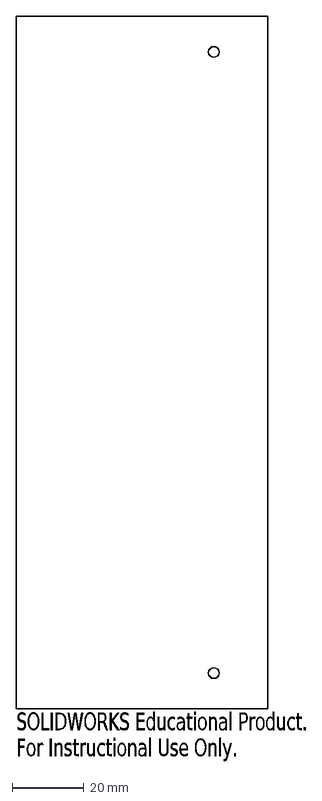
[picture p42: CAD file, 2020-03-10]
Mechanical/Frame/circuitHolder.DXF
SOLIDWORKS Educational Product.
For Instructional Use Only.
