SentinelPolaris/ECE115project/Mechanical/LaserCutting/PanelAcrylic.DXF

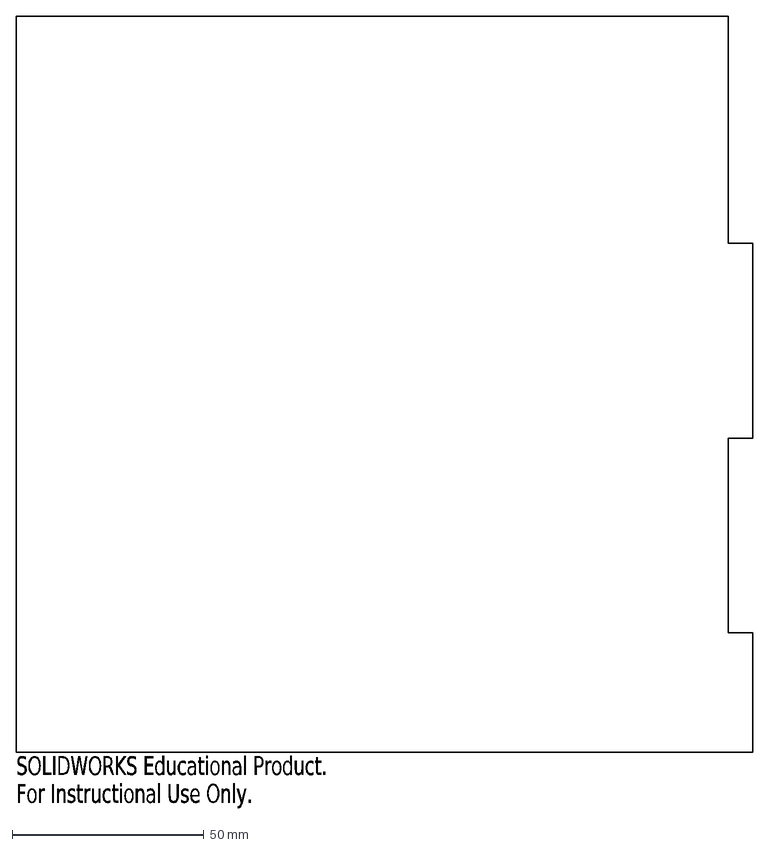
[picture p43: CAD file, 2020-03-10]
Mechanical/LaserCutting/PanelAcrylic.DXF
SOLIDWORKS Educational Product.
For Instructional Use Only.
