SentinelPolaris/ECE115project/Mechanical/Motor/N20Wheel.SLDPRT

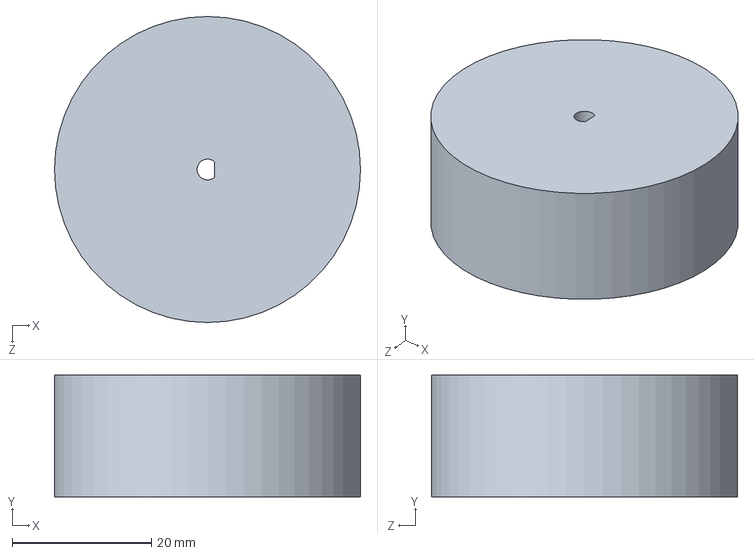
[picture p44: CAD file, 2020-02-16]
Mechanical/Motor/N20Wheel.SLDPRT
44.0 x 17.5 x 44.0 mm
