SentinelPolaris/ECE115project/Mechanical/Plunger/laser/2xpullhandle.DXF

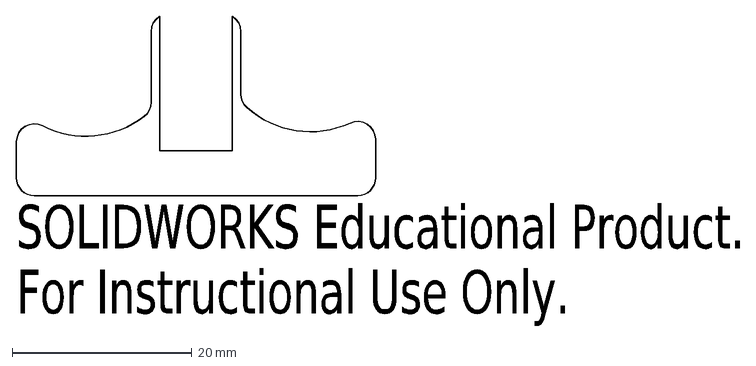
[picture p45: CAD file, 2020-01-15]
Mechanical/Plunger/laser/2xpullhandle.DXF
SOLIDWORKS Educational Product.
For Instructional Use Only.
