SentinelPolaris/ECE115project/Mechanical/Plunger/tip_v2.SLDPRT

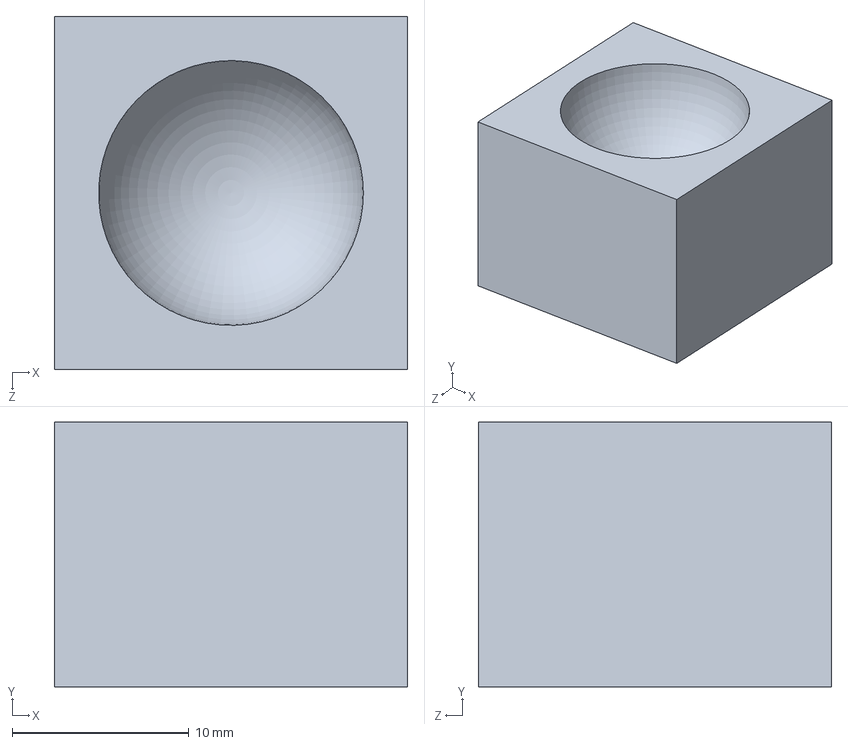
[picture p46: CAD file, 2020-02-14]
Mechanical/Plunger/tip_v2.SLDPRT
20.0 x 15.0 x 20.0 mm
