SentinelPolaris/ECE115project/Mechanical/Util/IRGateHalf.SLDPRT

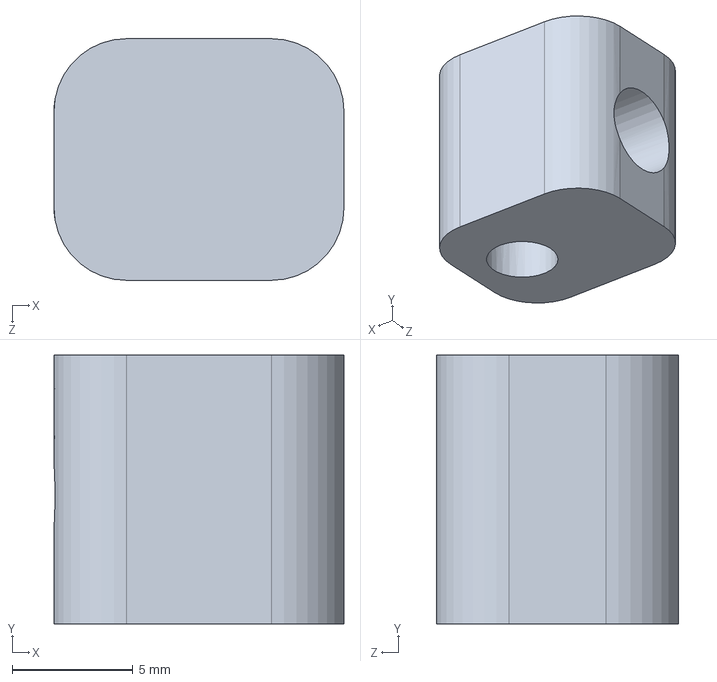
[picture p47: CAD file, 2020-02-14]
Mechanical/Util/IRGateHalf.SLDPRT
12.0 x 11.1 x 10.0 mm
