SentinelPolaris/ECE115project/Mechanical/Filpper/flipper_rod.SLDPRT

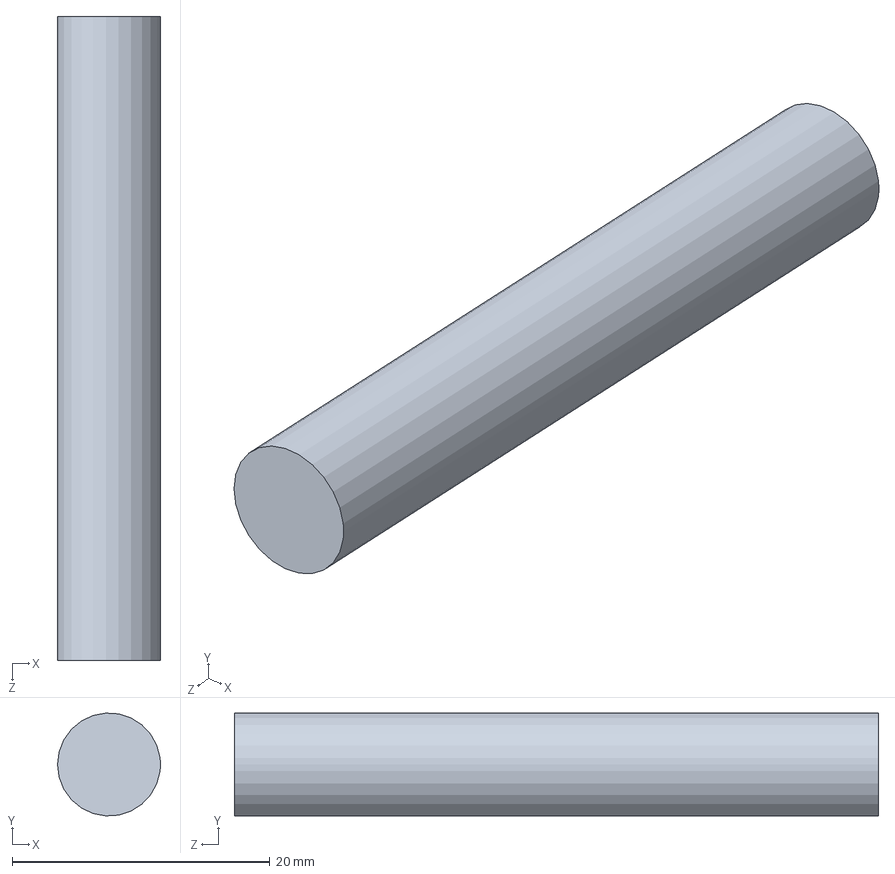
[picture p48: CAD file, 2020-02-14]
Mechanical/Filpper/flipper_rod.SLDPRT
8.00 x 7.98 x 50.0 mm
