SentinelPolaris/ECE115project/Mechanical/Frame/FrameSurroundding.SLDPRT

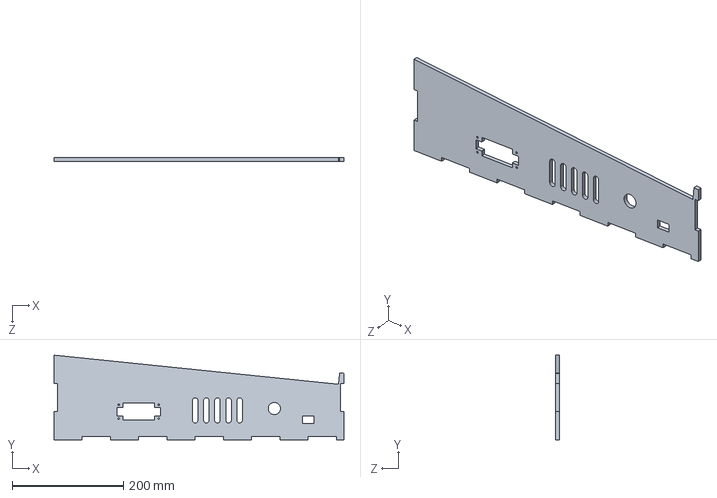
[picture p49: CAD file, 2020-03-10]
Mechanical/Frame/FrameSurroundding.SLDPRT
521.7 x 152.4 x 6.35 mm
