SentinelPolaris/ECE115project/Mechanical/LaserCutting/FrameTopWallTop.DXF

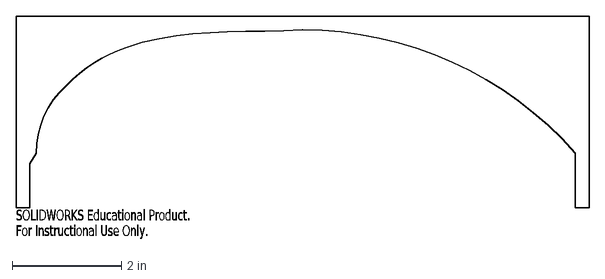
[picture p50: CAD file, 2020-03-10]
Mechanical/LaserCutting/FrameTopWallTop.DXF
SOLIDWORKS Educational Product.
For Instructional Use Only.
