SentinelPolaris/ECE115project/Mechanical/Motor/Brazo M.STEP

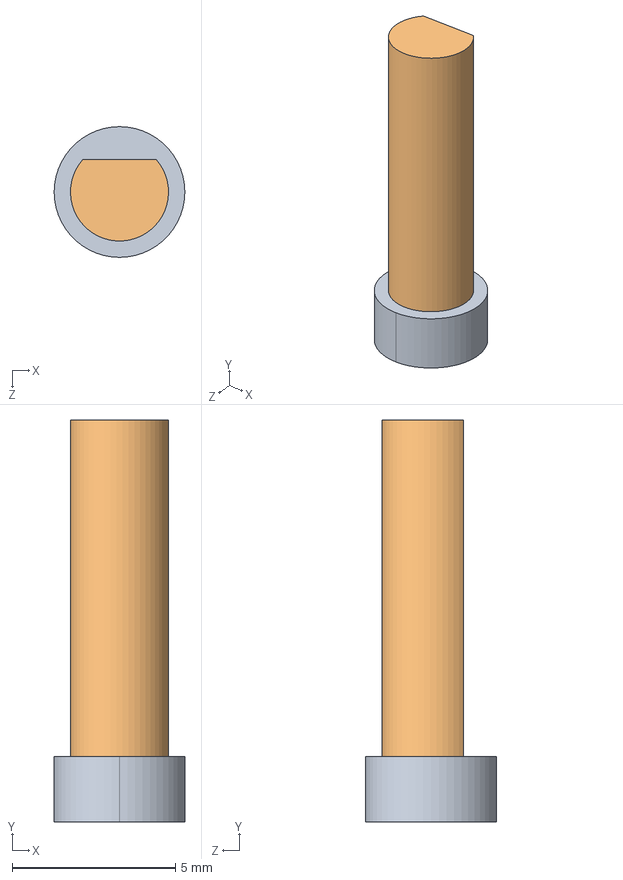
[picture p51: CAD file, 2020-02-16]
Mechanical/Motor/Brazo M.STEP
4.00 x 12.3 x 4.00 mm
