SentinelPolaris/ECE115project/Mechanical/Plunger/spring.SLDPRT

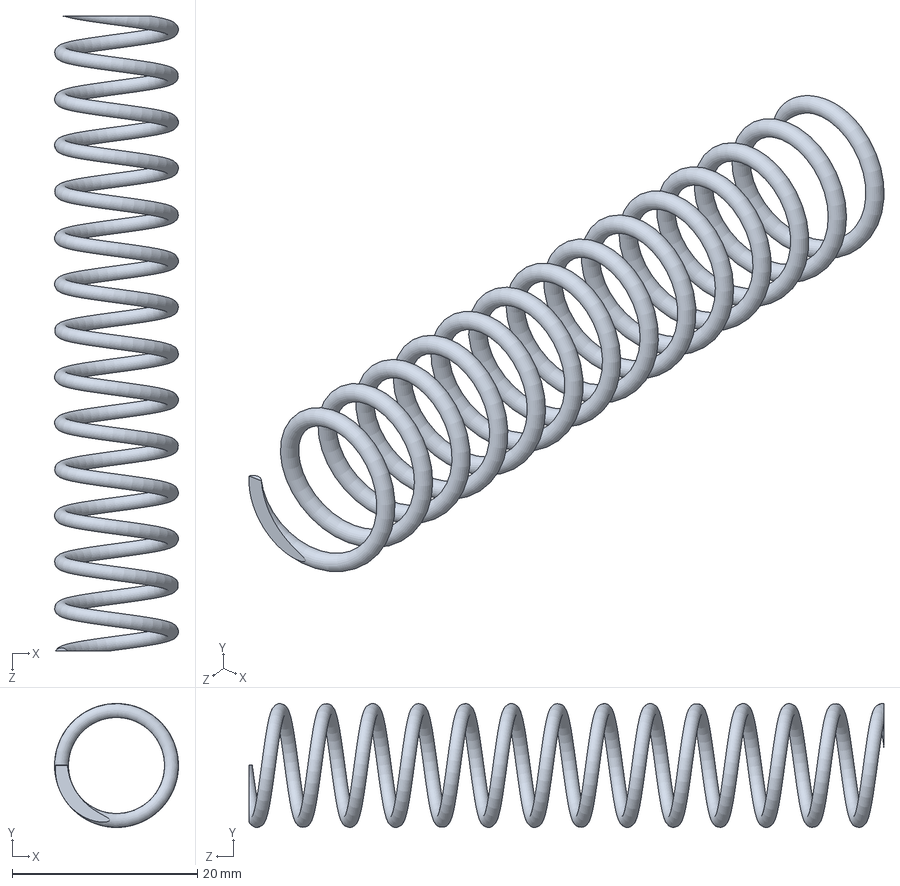
[picture p52: CAD file, 2020-02-14]
Mechanical/Plunger/spring.SLDPRT
13.4 x 13.4 x 68.6 mm
