SentinelPolaris/ECE115project/Mechanical/Util/IRGateHalfSolenoid.SLDPRT

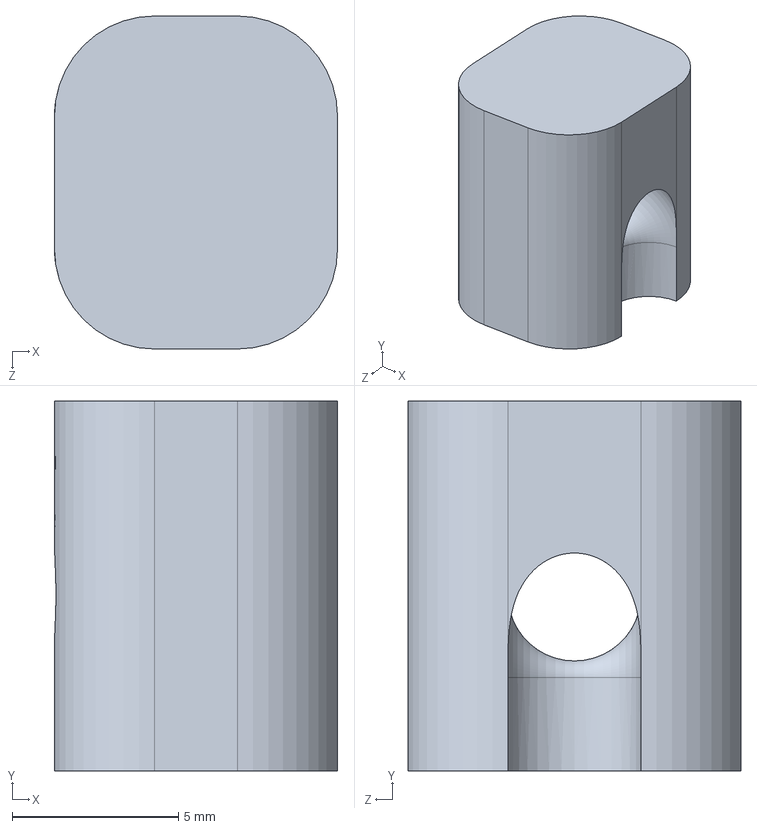
[picture p53: CAD file, 2020-02-14]
Mechanical/Util/IRGateHalfSolenoid.SLDPRT
8.50 x 11.1 x 10.0 mm
