SentinelPolaris/ECE115project/Mechanical/Frame/FrameSurrounddingback.SLDPRT

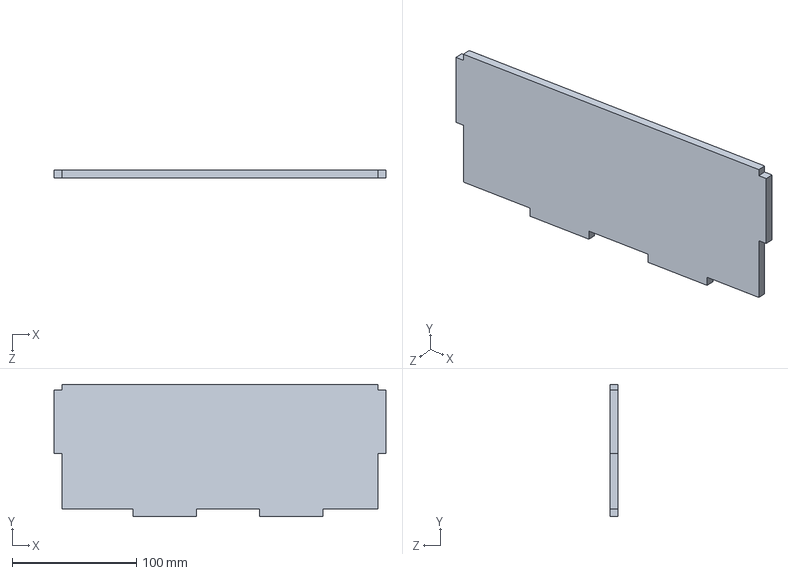
[picture p54: CAD file, 2020-03-10]
Mechanical/Frame/FrameSurrounddingback.SLDPRT
266.7 x 106.3 x 6.35 mm
