SentinelPolaris/ECE115project/Mechanical/LaserCutting/FrameBottomPlate.DXF

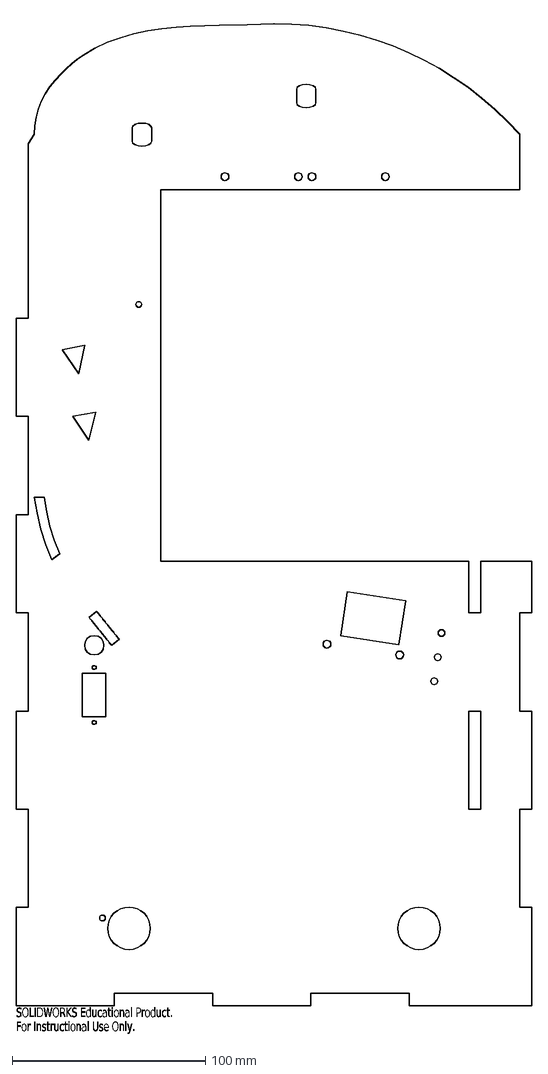
[picture p55: CAD file, 2020-03-10]
Mechanical/LaserCutting/FrameBottomPlate.DXF
SOLIDWORKS Educational Product.
For Instructional Use Only.
