SentinelPolaris/ECE115project/Mechanical/Plunger/PlungerRod.SLDPRT

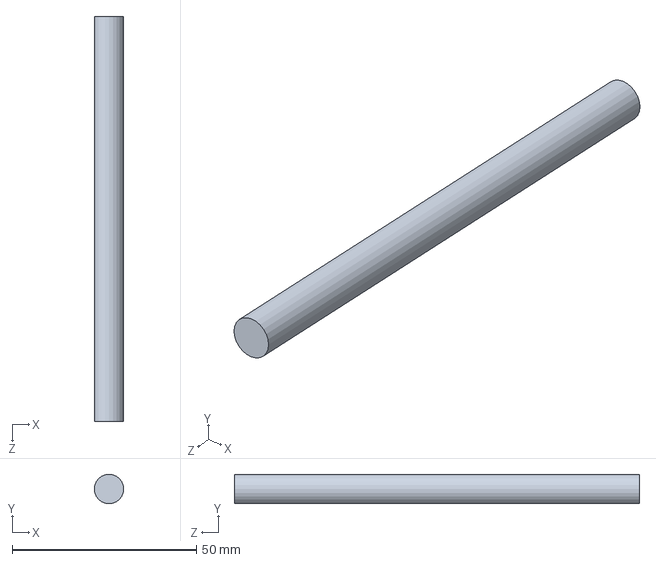
[picture p56: CAD file, 2020-02-14]
Mechanical/Plunger/PlungerRod.SLDPRT
8.00 x 8.00 x 110.0 mm
