SentinelPolaris/ECE115project/Mechanical/Filpper/flipper_test_base.SLDPRT

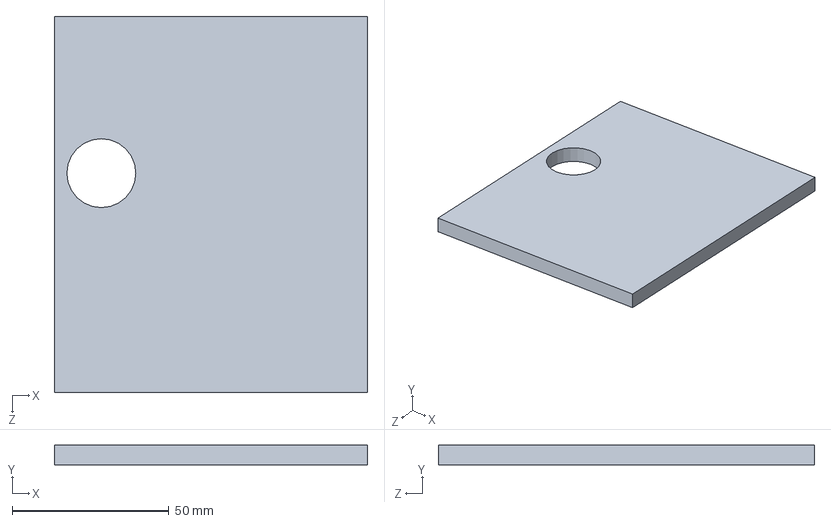
[picture p57: CAD file, 2020-01-22]
Mechanical/Filpper/flipper_test_base.SLDPRT
100.0 x 6.35 x 120.0 mm
