SentinelPolaris/ECE115project/Mechanical/Frame/FrameSurrounddindBottom.SLDPRT

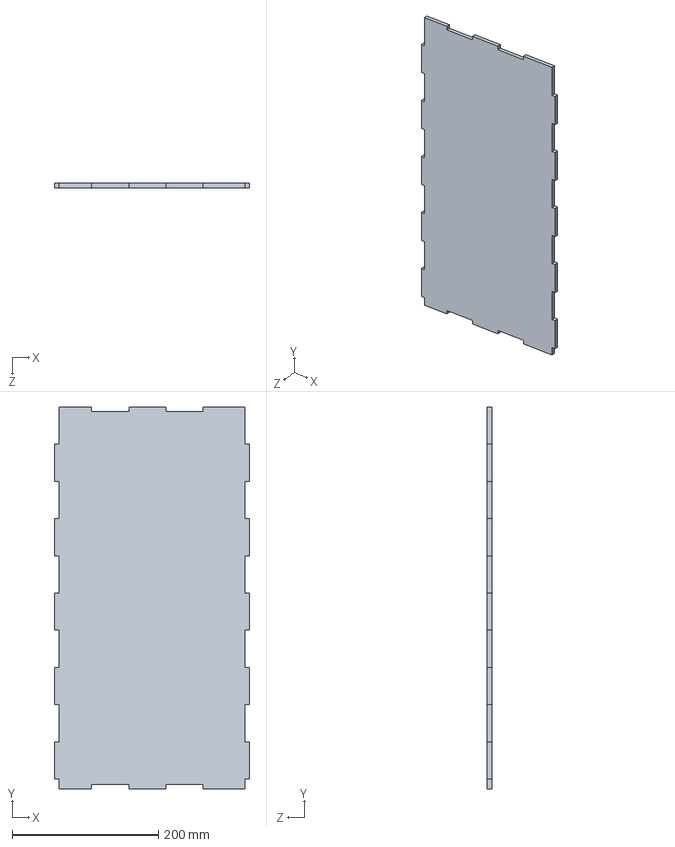
[picture p58: CAD file, 2020-03-10]
Mechanical/Frame/FrameSurrounddindBottom.SLDPRT
266.7 x 521.7 x 6.35 mm
