SentinelPolaris/ECE115project/Mechanical/LaserCutting/FrameTopWallBottom.DXF

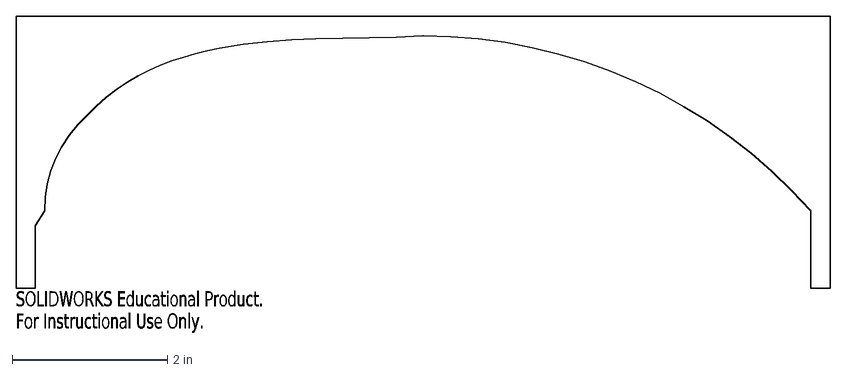
[picture p59: CAD file, 2020-03-10]
Mechanical/LaserCutting/FrameTopWallBottom.DXF
SOLIDWORKS Educational Product.
For Instructional Use Only.
