SentinelPolaris/ECE115project/Mechanical/LaserCutting/FrameTunnelWall.DXF

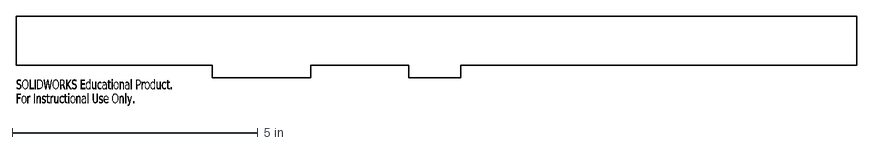
[picture p60: CAD file, 2020-03-10]
Mechanical/LaserCutting/FrameTunnelWall.DXF
SOLIDWORKS Educational Product.
For Instructional Use Only.
