SentinelPolaris/ECE115project/Mechanical/Frame/FrameSideWallRight.SLDPRT

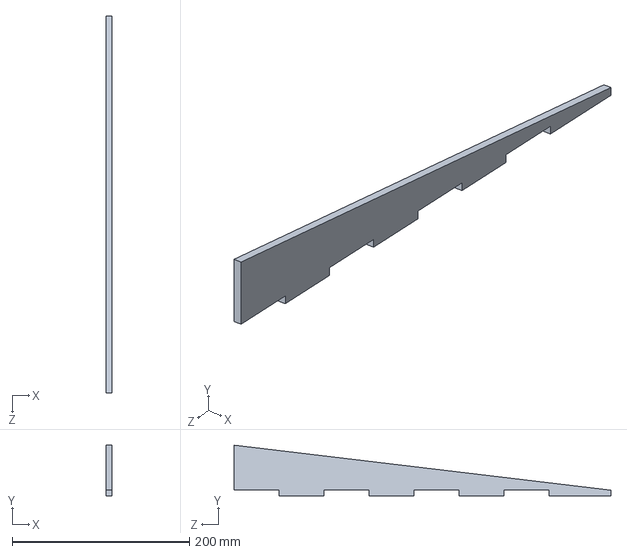
[picture p61: CAD file, 2020-03-10]
Mechanical/Frame/FrameSideWallRight.SLDPRT
6.35 x 57.1 x 425.3 mm
