SentinelPolaris/ECE115project/Mechanical/Frame/FrameSurrounddindfront.SLDPRT

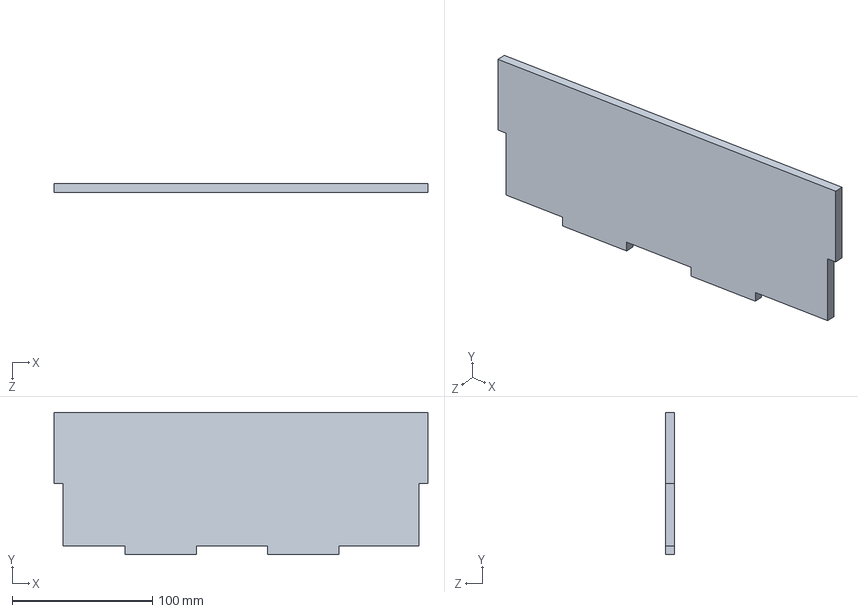
[picture p62: CAD file, 2020-03-10]
Mechanical/Frame/FrameSurrounddindfront.SLDPRT
266.7 x 101.6 x 6.35 mm
