SentinelPolaris/ECE115project/Mechanical/Frame/FrameTunnelWall.SLDPRT

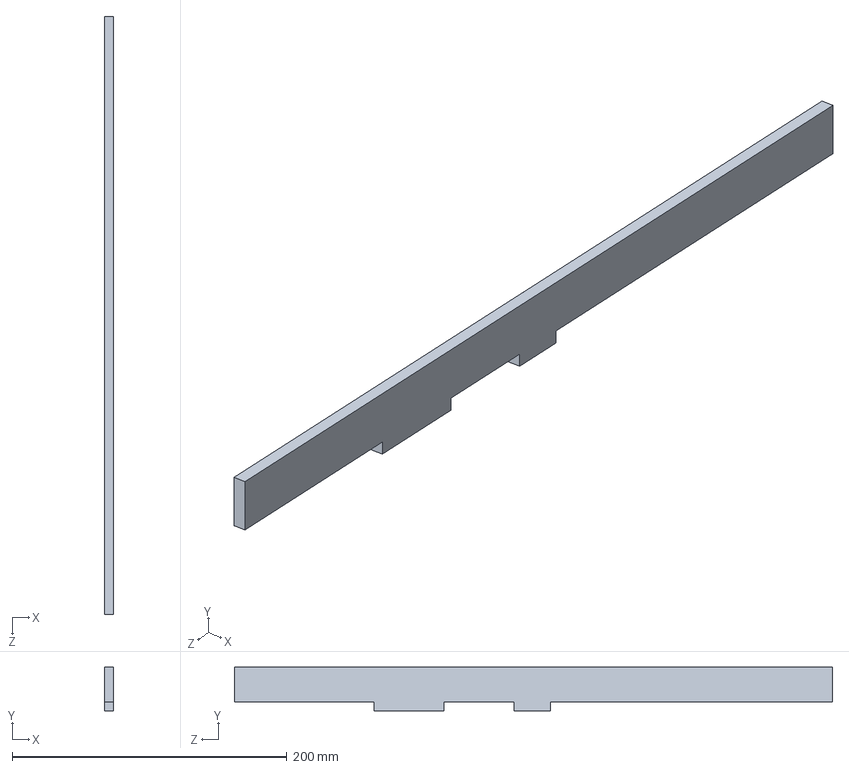
[picture p63: CAD file, 2020-03-10]
Mechanical/Frame/FrameTunnelWall.SLDPRT
6.35 x 31.8 x 435.0 mm
