SentinelPolaris/ECE115project/Mechanical/Frame/FrameBottomWall.SLDPRT

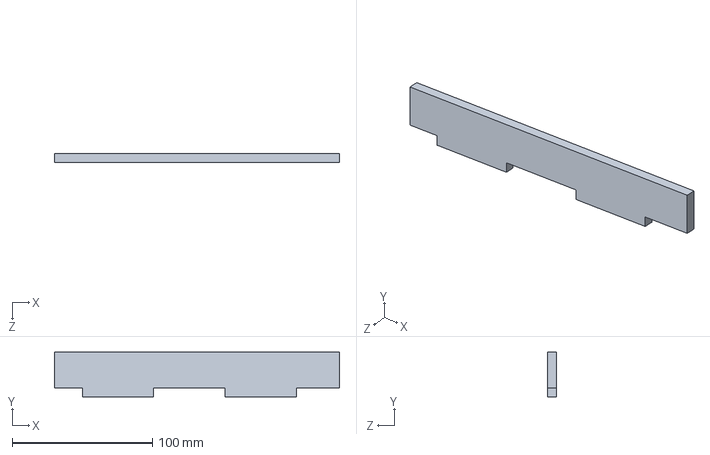
[picture p64: CAD file, 2020-02-18]
Mechanical/Frame/FrameBottomWall.SLDPRT
203.0 x 31.8 x 6.35 mm
