SentinelPolaris/ECE115project/Mechanical/Frame/EMlauncherGuide.SLDPRT

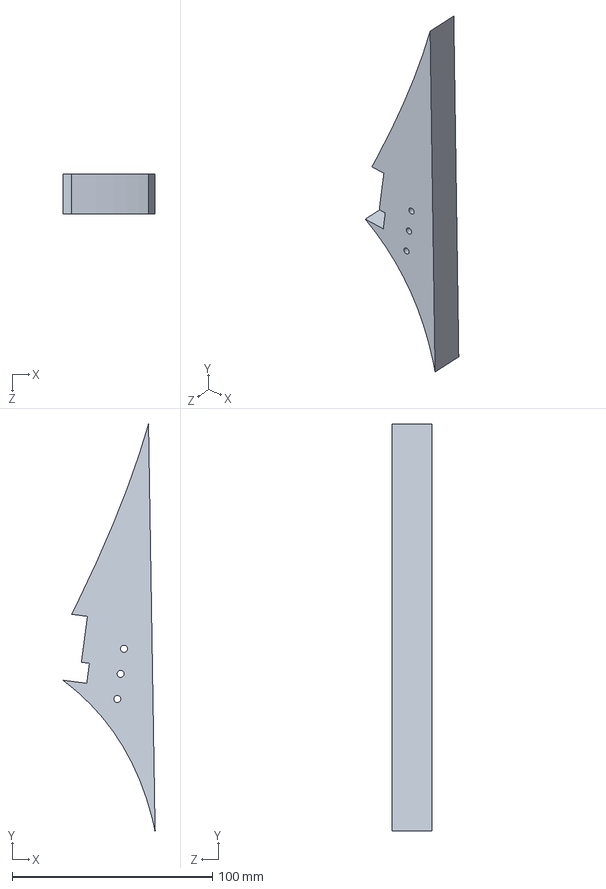
[picture p65: CAD file, 2020-02-18]
Mechanical/Frame/EMlauncherGuide.SLDPRT
46.0 x 203.2 x 20.0 mm
