SentinelPolaris/ECE115project/Mechanical/Frame/PanelAcrylic.SLDPRT

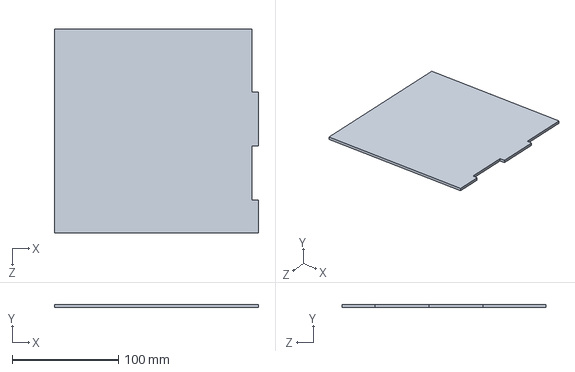
[picture p66: CAD file, 2020-02-18]
Mechanical/Frame/PanelAcrylic.SLDPRT
192.0 x 3.17 x 192.0 mm
