SentinelPolaris/ECE115project/Mechanical/Frame/SliderAcrylic.SLDPRT

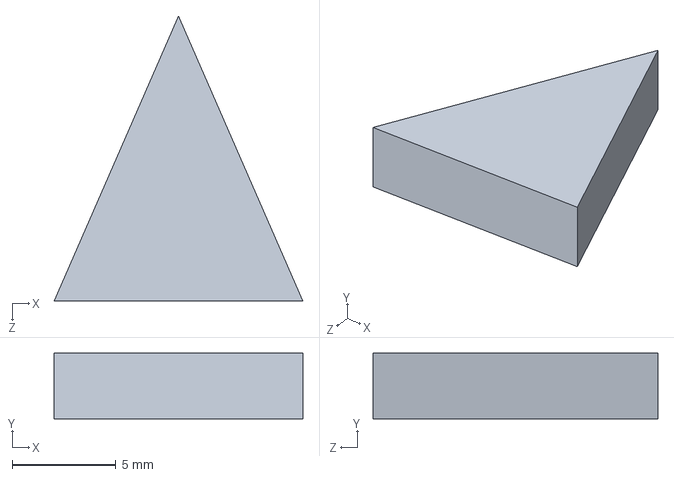
[picture p67: CAD file, 2020-02-18]
Mechanical/Frame/SliderAcrylic.SLDPRT
12.0 x 3.17 x 13.7 mm
