SentinelPolaris/ECE115project/Mechanical/Frame/FrameSideWallLeft.SLDPRT

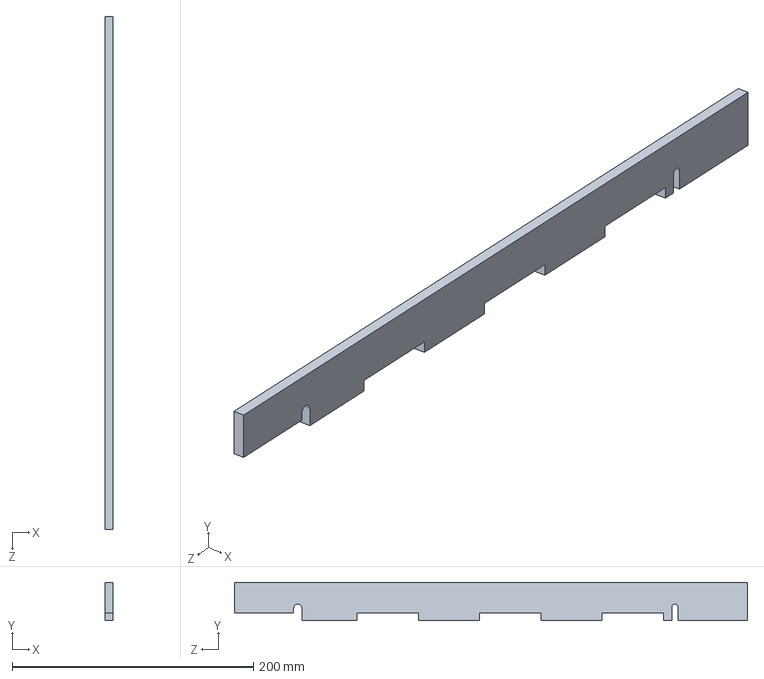
[picture p68: CAD file, 2020-02-18]
Mechanical/Frame/FrameSideWallLeft.SLDPRT
6.35 x 31.8 x 425.3 mm
