SentinelPolaris/ECE115project/Mechanical/Frame/FrameBottomPlate.SLDPRT

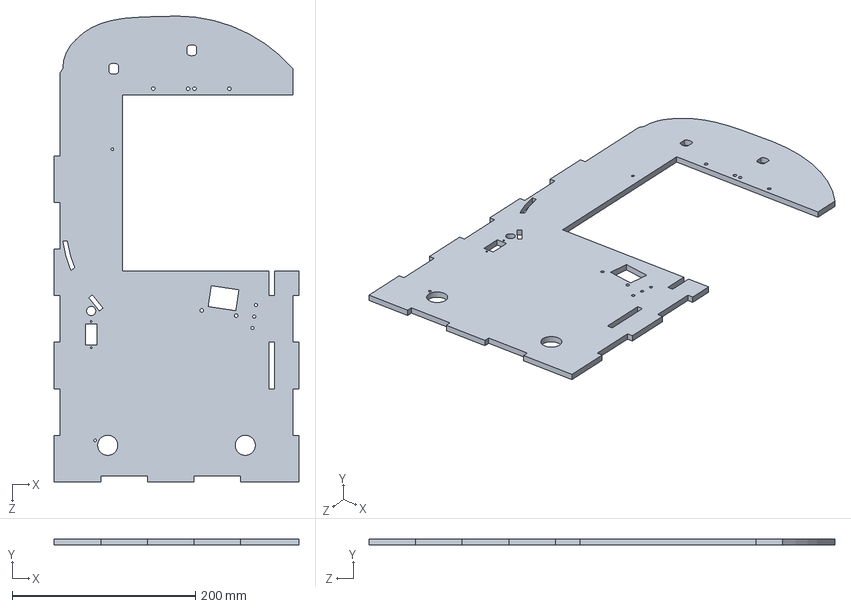
[picture p69: CAD file, 2020-02-18]
Mechanical/Frame/FrameBottomPlate.SLDPRT
266.7 x 6.35 x 508.0 mm
