SentinelPolaris/ECE115project/(list of files, cad)

Other CAD files:
Mechanical/Flipper.SLDASM
Mechanical/Motor/Motor M.STEP
Mechanical/Servo/microservoArmV2.STL
Mechanical/Frame/FrameTopWallBottom.SLDPRT
Mechanical/Frame/FrameSurrounddindBottom.DXF
Mechanical/Frame/FrameSurrounddindfront.DXF
Mechanical/Frame/FrameSurroundding.DXF
Mechanical/Plunger/tip.SLDPRT
Mechanical/Servo/microservoArm.STL
