SentinelPolaris/ECE115project/Mechanical/LaserCutting/bottom plate and ball catcher.pdf

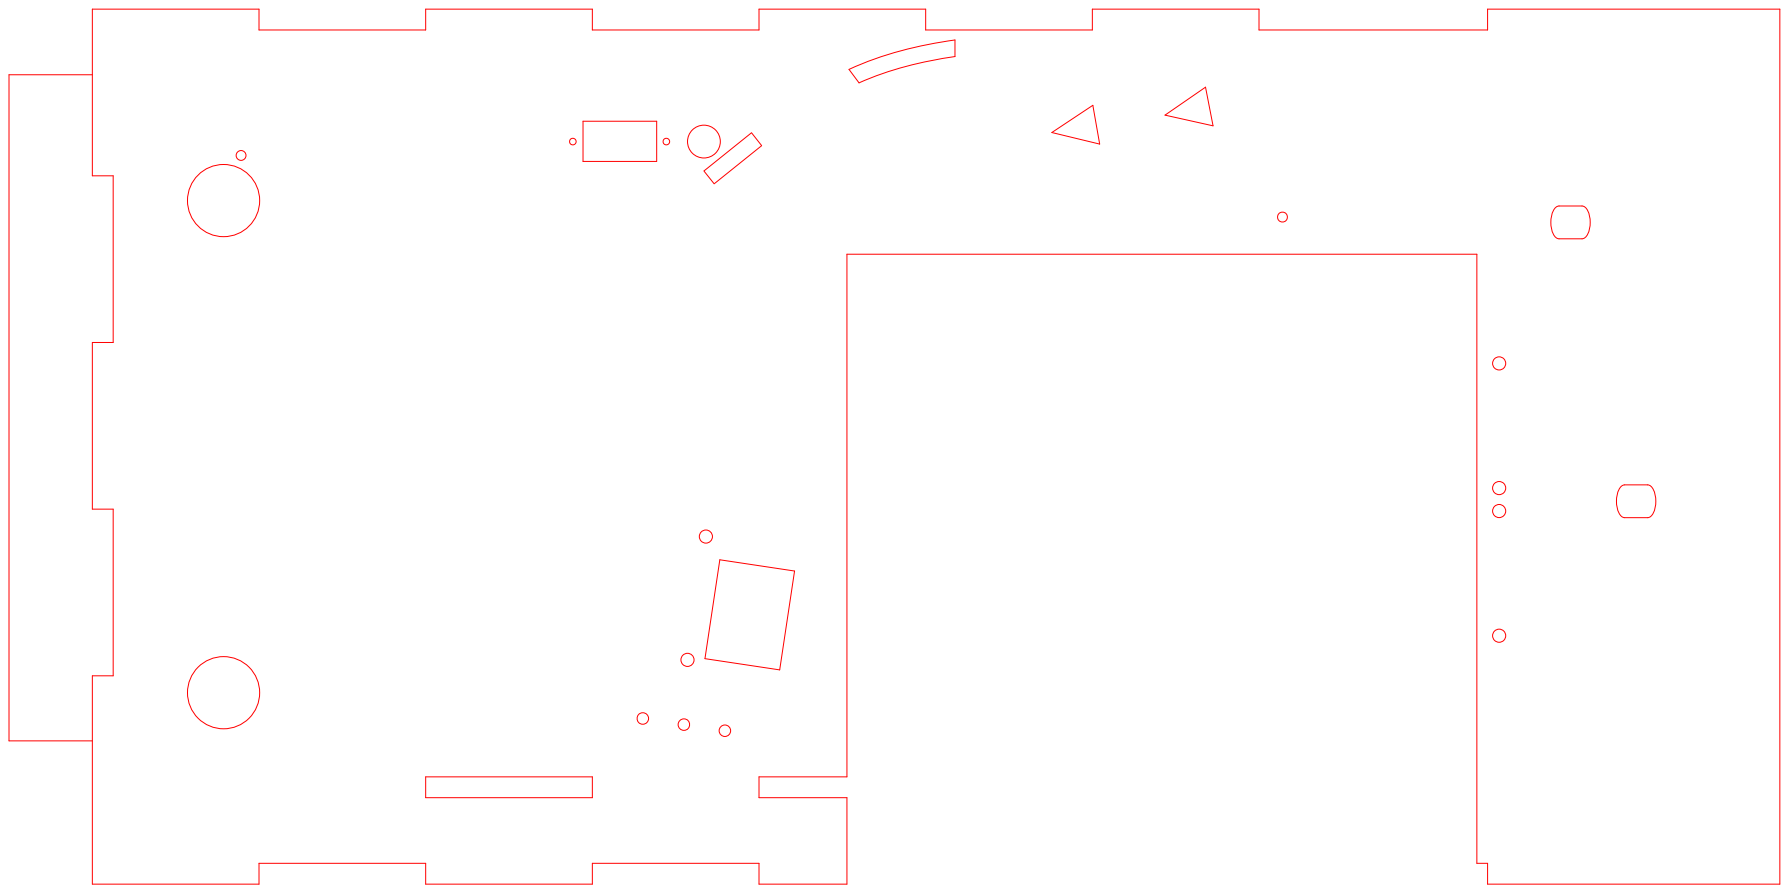
[picture p70: page 1]
