SentinelPolaris/ECE115project/Mechanical/Plunger/laser/cut1.pdf

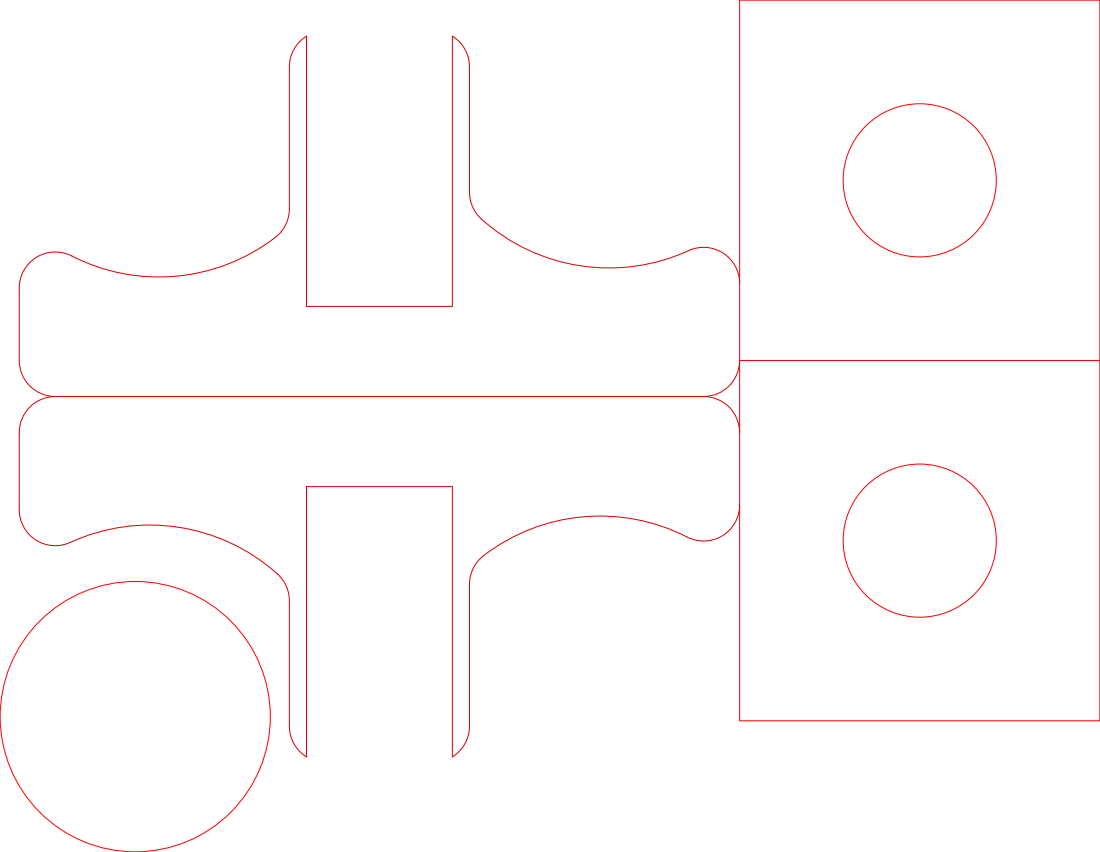
[picture p71: page 1]
