SentinelPolaris/ECE115project/Mechanical/Plunger/laser/cut2.pdf

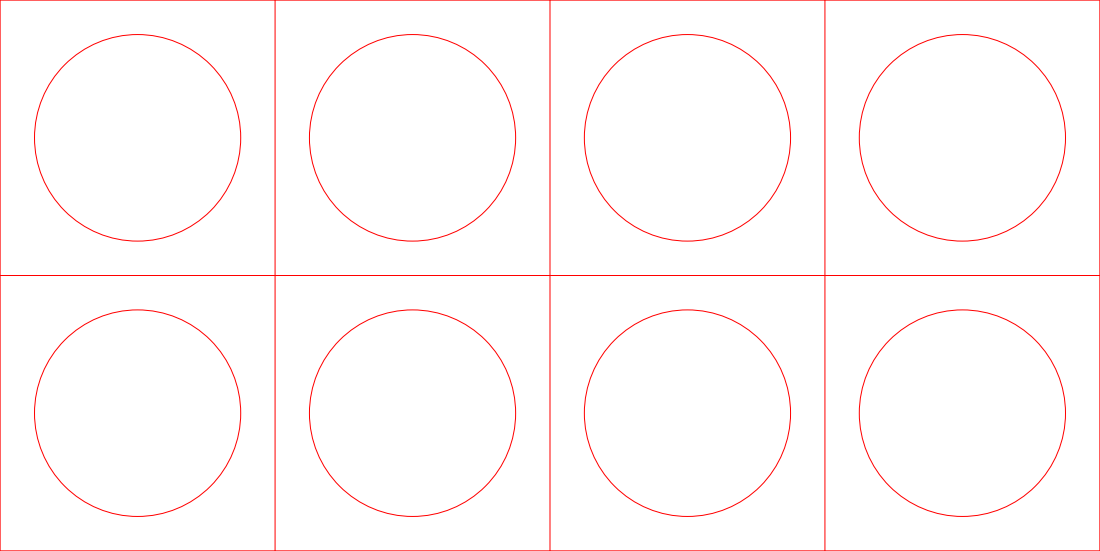
[picture p72: page 1]
