SentinelPolaris/ECE115project/Electrical/PCB/Debouncer/Debouncer.brd

## EAGLE design Electrical/PCB/Debouncer/Debouncer.brd (2020-03-10)

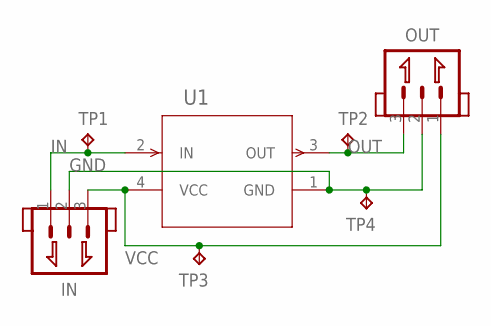
[picture p73: schematic Debouncer.sch]

Parts:
IN: JST_1.25_3P; JST1.25_3P
OUT: JST_1.25_3P; JST1.25_3P
TP1, TP2, TP3, TP4: TPPAD1-13; P1-13
U1: DEBOUNCE_MAX6816EUS+T; 21-0052F

Connections:
GND: IN.2, OUT.2, TP4.TP, U1.1 (GND)
IN: IN.1, TP1.TP, U1.2 (IN)
OUT: OUT.3, TP2.TP, U1.3 (OUT)
VCC: IN.3, OUT.1, TP3.TP, U1.4 (VCC)

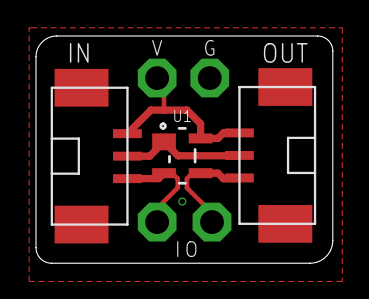
[picture p74: board Debouncer.brd from above]

Board: 2 copper layers, 16.5 x 12.6 mm, 7 parts (0 on the bottom side), 4 nets.
