SentinelPolaris/ECE115project/Electrical/PCB/IOExpander/IOExpander.brd

## EAGLE design Electrical/PCB/IOExpander/IOExpander.brd (2020-03-10)

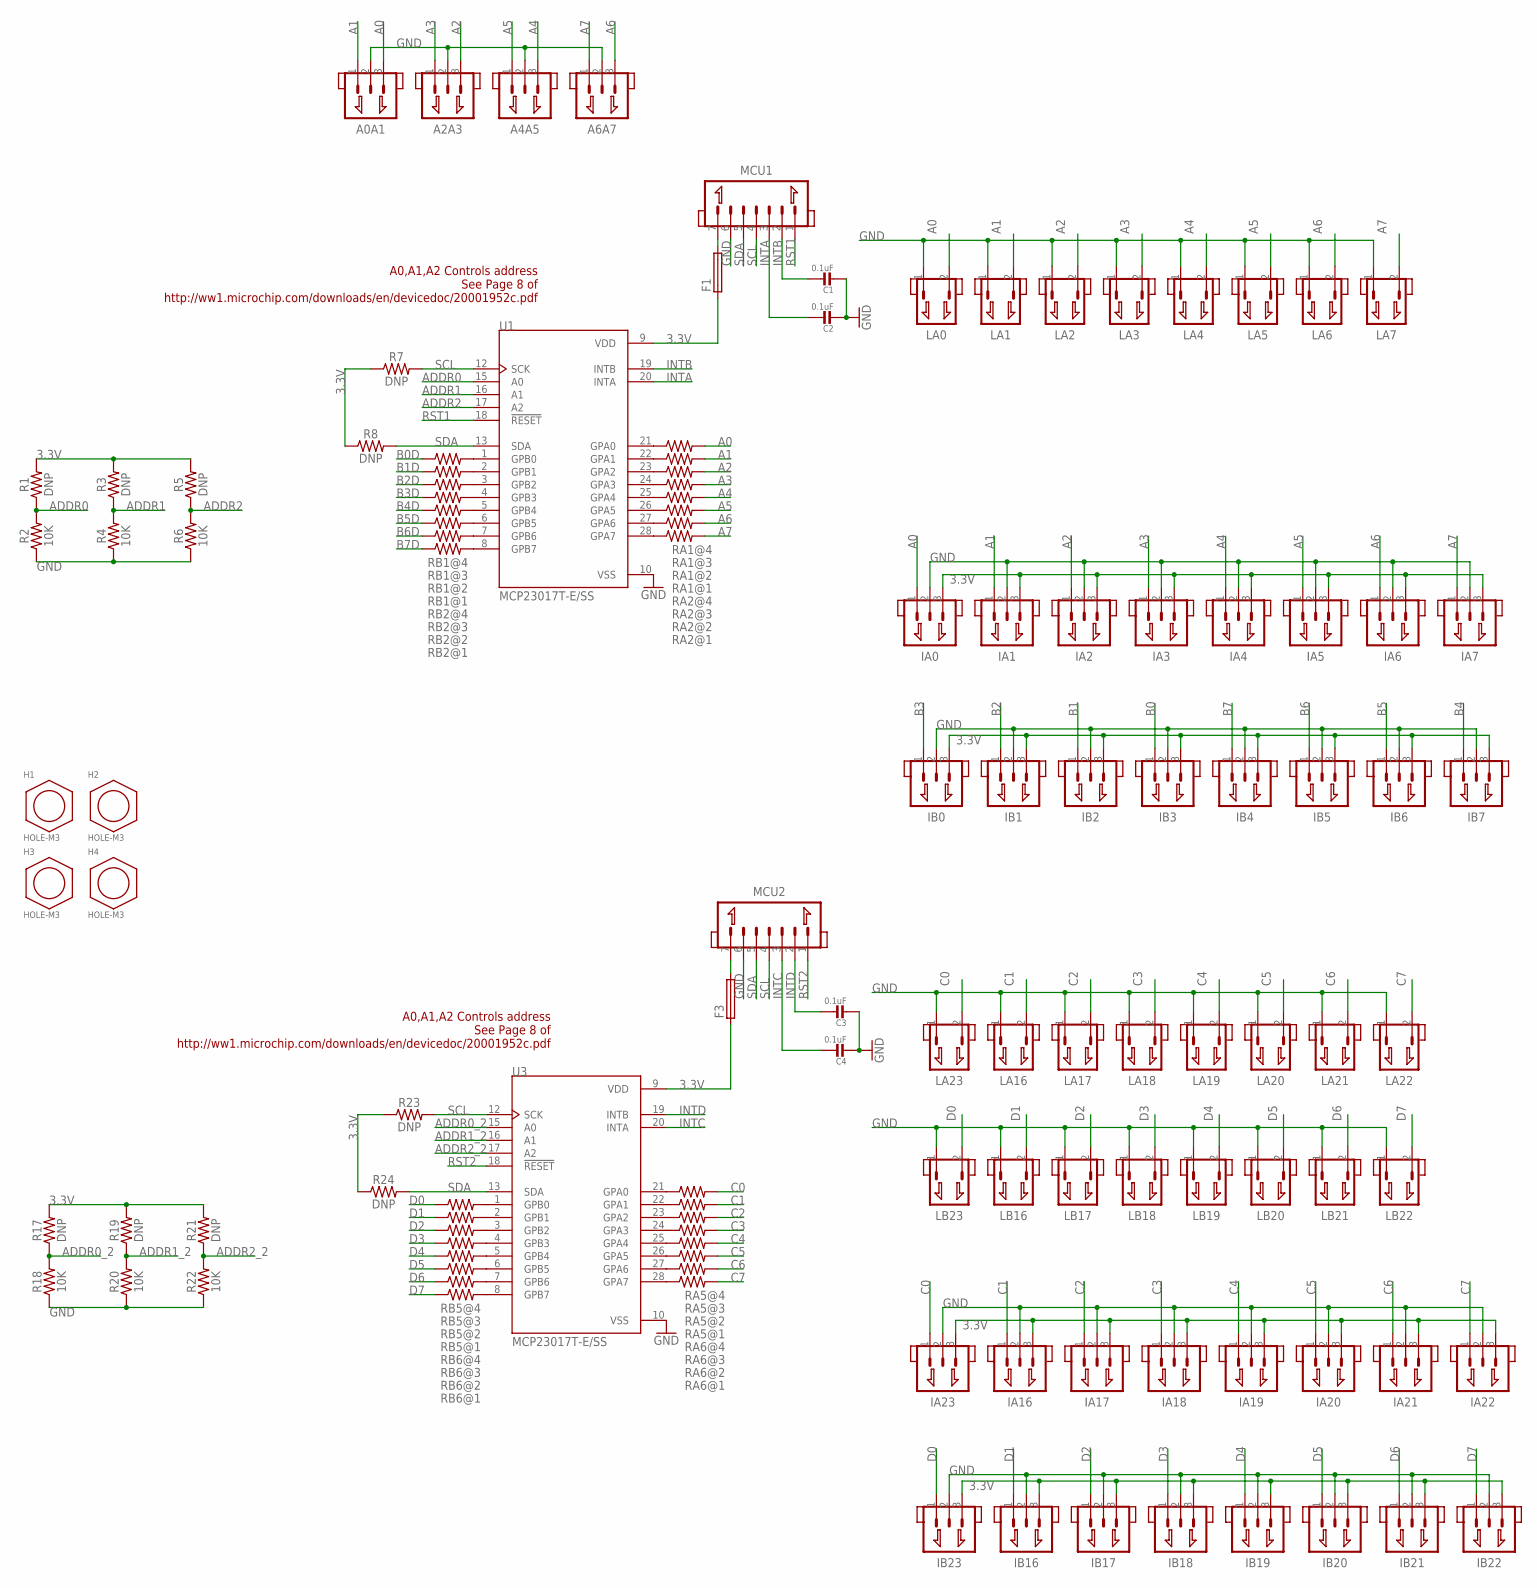
[picture p75: schematic IOExpander.sch, sheet 1]

Parts:
A0A1, A2A3, A4A5, A6A7: JST_1.25_3P; JST1.25_3P
C1, C2, C3, C4: 0.1uF; 0603
F1, F3: FUSE-0603; 0603
H1, H2, H3, H4: HOLE-M3; M3
IA0, IA1, IA2, IA3, IA4, IA5, IA6, IA7, IA16, IA17, IA18, IA19, IA20, IA21, IA22, IA23: JST_1.25_3P; JST1.25_3P
IB0, IB1, IB2, IB3, IB4, IB5, IB6, IB7, IB16, IB17, IB18, IB19, IB20, IB21, IB22, IB23: JST_1.25_3P; JST1.25_3P
LA0, LA1, LA2, LA3, LA4, LA5, LA6, LA7, LA16, LA17, LA18, LA19, LA20, LA21, LA22, LA23: JST_1.25_2P; JST1.25_2P
LB16, LB17, LB18, LB19, LB20, LB21, LB22, LB23: JST_1.25_2P; JST1.25_2P
MCU1, MCU2: JST_1.25_7P; JST1.25_7P
R1, R3, R5, R7, R8, R17, R19, R21, R23, R24: DNP; 0603
R2, R4, R6, R18, R20, R22: 10K; 0603
RA1, RA2, RA5, RA6: RESISTOR_ARRAY_1206_SEPARATE; RESCAF80P320X160X60-8N
RB1, RB2, RB5, RB6: RESISTOR_ARRAY_1206_SEPARATE_REVERSE; RESCAF80P320X160X60-8N
U1, U3: MCP23017T-E/SS; SOP65P780X200-28N

Connections:
3.3V: F1.1, F3.1, IA0.3, IA1.3, IA2.3, IA3.3, IA4.3, IA5.3, IA6.3, IA7.3, IA16.3, IA17.3, IA18.3, IA19.3, IA20.3, IA21.3, IA22.3, IA23.3, IB0.3, IB1.3, IB2.3, IB3.3, IB4.3, IB5.3, IB6.3, IB7.3, IB16.3, IB17.3, IB18.3, IB19.3, IB20.3, IB21.3, IB22.3, IB23.3, R1.2, R3.2, R5.2, R7.1, R8.1, R17.2, R19.2, R21.2, R23.1, R24.1, U1.9 (VDD), U3.9 (VDD); also elsewhere on the board
A0: A0A1.3, IA0.1, LA0.2, RA1.5 (2)
A1: A0A1.1, IA1.1, LA1.2, RA1.6 (2)
A2: A2A3.3, IA2.1, LA2.2, RA1.7 (2)
A3: A2A3.1, IA3.1, LA3.2, RA1.8 (2)
A4: A4A5.3, IA4.1, LA4.2, RA2.5 (2)
A5: A4A5.1, IA5.1, LA5.2, RA2.6 (2)
A6: A6A7.3, IA6.1, LA6.2, RA2.7 (2)
A7: A6A7.1, IA7.1, LA7.2, RA2.8 (2)
ADDR0: R1.1, R2.2, U1.15 (A0)
ADDR0_2: R17.1, R18.2, U3.15 (A0)
ADDR1: R3.1, R4.2, U1.16 (A1)
ADDR1_2: R19.1, R20.2, U3.16 (A1)
ADDR2: R5.1, R6.2, U1.17 (A2)
ADDR2_2: R21.1, R22.2, U3.17 (A2)
B0: IB3.1; also elsewhere on the board
B0D: RB1.5 (1); also elsewhere on the board
B1: IB2.1; also elsewhere on the board
B1D: RB1.6 (1); also elsewhere on the board
B2: IB1.1; also elsewhere on the board
B2D: RB1.7 (1); also elsewhere on the board
B3: IB0.1; also elsewhere on the board
B3D: RB1.8 (1); also elsewhere on the board
B4: IB7.1; also elsewhere on the board
B4D: RB2.5 (1); also elsewhere on the board
B5: IB6.1; also elsewhere on the board
B5D: RB2.6 (1); also elsewhere on the board
B6: IB5.1; also elsewhere on the board
B6D: RB2.7 (1); also elsewhere on the board
B7: IB4.1; also elsewhere on the board
B7D: RB2.8 (1); also elsewhere on the board
C0: IA23.1, LA23.2, RA5.5 (2)
C1: IA16.1, LA16.2, RA5.6 (2)
C2: IA17.1, LA17.2, RA5.7 (2)
C3: IA18.1, LA18.2, RA5.8 (2)
C4: IA19.1, LA19.2, RA6.5 (2)
C5: IA20.1, LA20.2, RA6.6 (2)
C6: IA21.1, LA21.2, RA6.7 (2)
C7: IA22.1, LA22.2, RA6.8 (2)
D0: IB23.1, LB23.2, RB5.5 (1)
D1: IB16.1, LB16.2, RB5.6 (1)
D2: IB17.1, LB17.2, RB5.7 (1)
D3: IB18.1, LB18.2, RB5.8 (1)
D4: IB19.1, LB19.2, RB6.5 (1)
D5: IB20.1, LB20.2, RB6.6 (1)
D6: IB21.1, LB21.2, RB6.7 (1)
D7: IB22.1, LB22.2, RB6.8 (1)
GND: A0A1.2, A2A3.2, A4A5.2, A6A7.2, C1.2, C2.2, C3.2, C4.2, IA0.2, IA1.2, IA2.2, IA3.2, IA4.2, IA5.2, IA6.2, IA7.2, IA16.2, IA17.2, IA18.2, IA19.2, IA20.2, IA21.2, IA22.2, IA23.2, IB0.2, IB1.2, IB2.2, IB3.2, IB4.2, IB5.2, IB6.2, IB7.2, IB16.2, IB17.2, IB18.2, IB19.2, IB20.2, IB21.2, IB22.2, IB23.2, LA0.1, LA1.1, LA2.1, LA3.1, LA4.1, LA5.1, LA6.1, LA7.1, LA16.1, LA17.1, LA18.1, LA19.1, LA20.1, LA21.1, LA22.1, LA23.1, LB16.1, LB17.1, LB18.1, LB19.1, LB20.1, LB21.1, LB22.1, LB23.1, MCU1.6, MCU2.6, R2.1, R4.1, R6.1, R18.1, R20.1, R22.1, U1.10 (VSS), U3.10 (VSS); also elsewhere on the board
INTA: C2.1, MCU1.3, U1.20 (INTA)
INTB: C1.1, MCU1.2, U1.19 (INTB)
INTC: C4.1, MCU2.3, U3.20 (INTA)
INTD: C3.1, MCU2.2, U3.19 (INTB)
unnamed: RA1.1, U1.24 (GPA3)
unnamed: RA1.2 (1), U1.23 (GPA2)
unnamed: RA1.3 (1), U1.22 (GPA1)
unnamed: RA1.4 (1), U1.21 (GPA0)
unnamed: RA2.1, U1.28 (GPA7)
unnamed: RA2.2 (1), U1.27 (GPA6)
unnamed: RA2.3 (1), U1.26 (GPA5)
unnamed: RA2.4 (1), U1.25 (GPA4)
unnamed: F1.2, MCU1.7
unnamed: RB1.1 (2), U1.4 (GPB3)
unnamed: RB1.2, U1.3 (GPB2)
unnamed: RB1.3 (2), U1.2 (GPB1)
unnamed: RB1.4 (2), U1.1 (GPB0)
unnamed: RB2.1 (2), U1.8 (GPB7)
unnamed: RB2.2, U1.7 (GPB6)
unnamed: RB2.3 (2), U1.6 (GPB5)
unnamed: RB2.4 (2), U1.5 (GPB4)
unnamed: F3.2, MCU2.7
unnamed: RB5.1 (2), U3.4 (GPB3)
unnamed: RB5.2, U3.3 (GPB2)
unnamed: RB5.3 (2), U3.2 (GPB1)
unnamed: RB5.4 (2), U3.1 (GPB0)
unnamed: RB6.1 (2), U3.8 (GPB7)
unnamed: RB6.2, U3.7 (GPB6)
unnamed: RB6.3 (2), U3.6 (GPB5)
unnamed: RB6.4 (2), U3.5 (GPB4)
unnamed: RA5.1, U3.24 (GPA3)
unnamed: RA5.2 (1), U3.23 (GPA2)
unnamed: RA5.3 (1), U3.22 (GPA1)
unnamed: RA5.4 (1), U3.21 (GPA0)
unnamed: RA6.1, U3.28 (GPA7)
unnamed: RA6.2 (1), U3.27 (GPA6)
unnamed: RA6.3 (1), U3.26 (GPA5)
unnamed: RA6.4 (1), U3.25 (GPA4)
RST1: MCU1.1, U1.18 (!RESET)
RST2: MCU2.1, U3.18 (!RESET)
SCL: MCU1.4, MCU2.4, R7.2, R23.2, U1.12 (SCK), U3.12 (SCK)
SDA: MCU1.5, MCU2.5, R8.2, R24.2, U1.13 (SDA), U3.13 (SDA)

Notes on the sheet:
A0,A1,A2 Controls address See Page 8 of http://ww1.microchip.com/downloads/en/devicedoc/20001952c.pdf

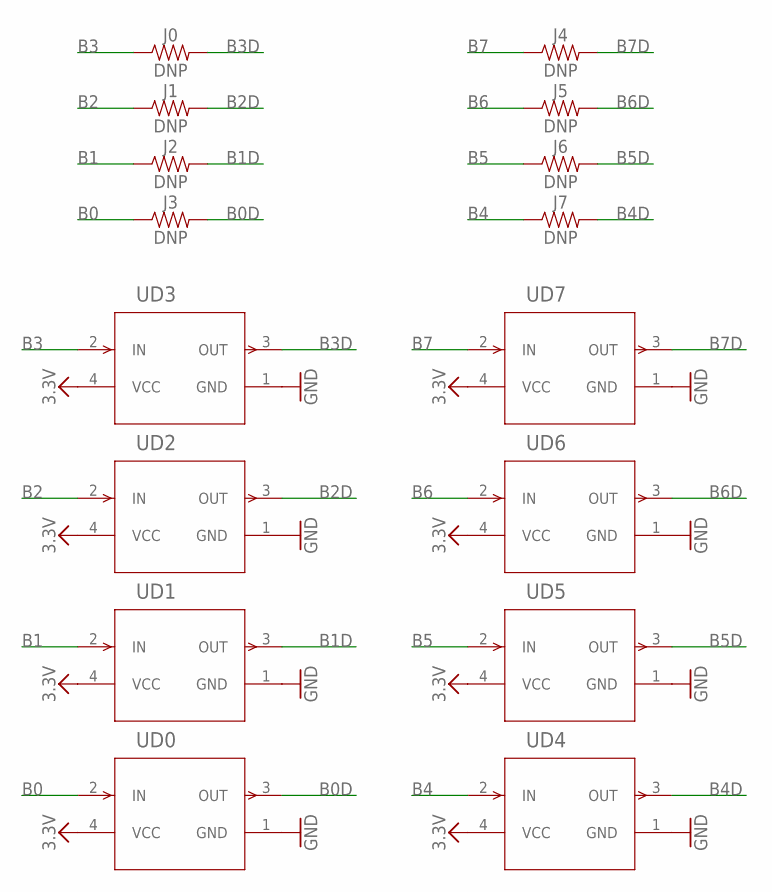
[picture p76: schematic IOExpander.sch, sheet 2]

Parts:
J0, J1, J2, J3, J4, J5, J6, J7: DNP; 0603
UD0, UD1, UD2, UD3, UD4, UD5, UD6, UD7: DEBOUNCE_MAX6816EUS+T; 21-0052F

Connections:
3.3V: UD0.4 (VCC), UD1.4 (VCC), UD2.4 (VCC), UD3.4 (VCC), UD4.4 (VCC), UD5.4 (VCC), UD6.4 (VCC), UD7.4 (VCC); also elsewhere on the board
B0: J3.1, UD0.2 (IN); also elsewhere on the board
B0D: J3.2, UD0.3 (OUT); also elsewhere on the board
B1: J2.1, UD1.2 (IN); also elsewhere on the board
B1D: J2.2, UD1.3 (OUT); also elsewhere on the board
B2: J1.1, UD2.2 (IN); also elsewhere on the board
B2D: J1.2, UD2.3 (OUT); also elsewhere on the board
B3: J0.1, UD3.2 (IN); also elsewhere on the board
B3D: J0.2, UD3.3 (OUT); also elsewhere on the board
B4: J7.1, UD4.2 (IN); also elsewhere on the board
B4D: J7.2, UD4.3 (OUT); also elsewhere on the board
B5: J6.1, UD5.2 (IN); also elsewhere on the board
B5D: J6.2, UD5.3 (OUT); also elsewhere on the board
B6: J5.1, UD6.2 (IN); also elsewhere on the board
B6D: J5.2, UD6.3 (OUT); also elsewhere on the board
B7: J4.1, UD7.2 (IN); also elsewhere on the board
B7D: J4.2, UD7.3 (OUT); also elsewhere on the board
GND: UD0.1 (GND), UD1.1 (GND), UD2.1 (GND), UD3.1 (GND), UD4.1 (GND), UD5.1 (GND), UD6.1 (GND), UD7.1 (GND); also elsewhere on the board

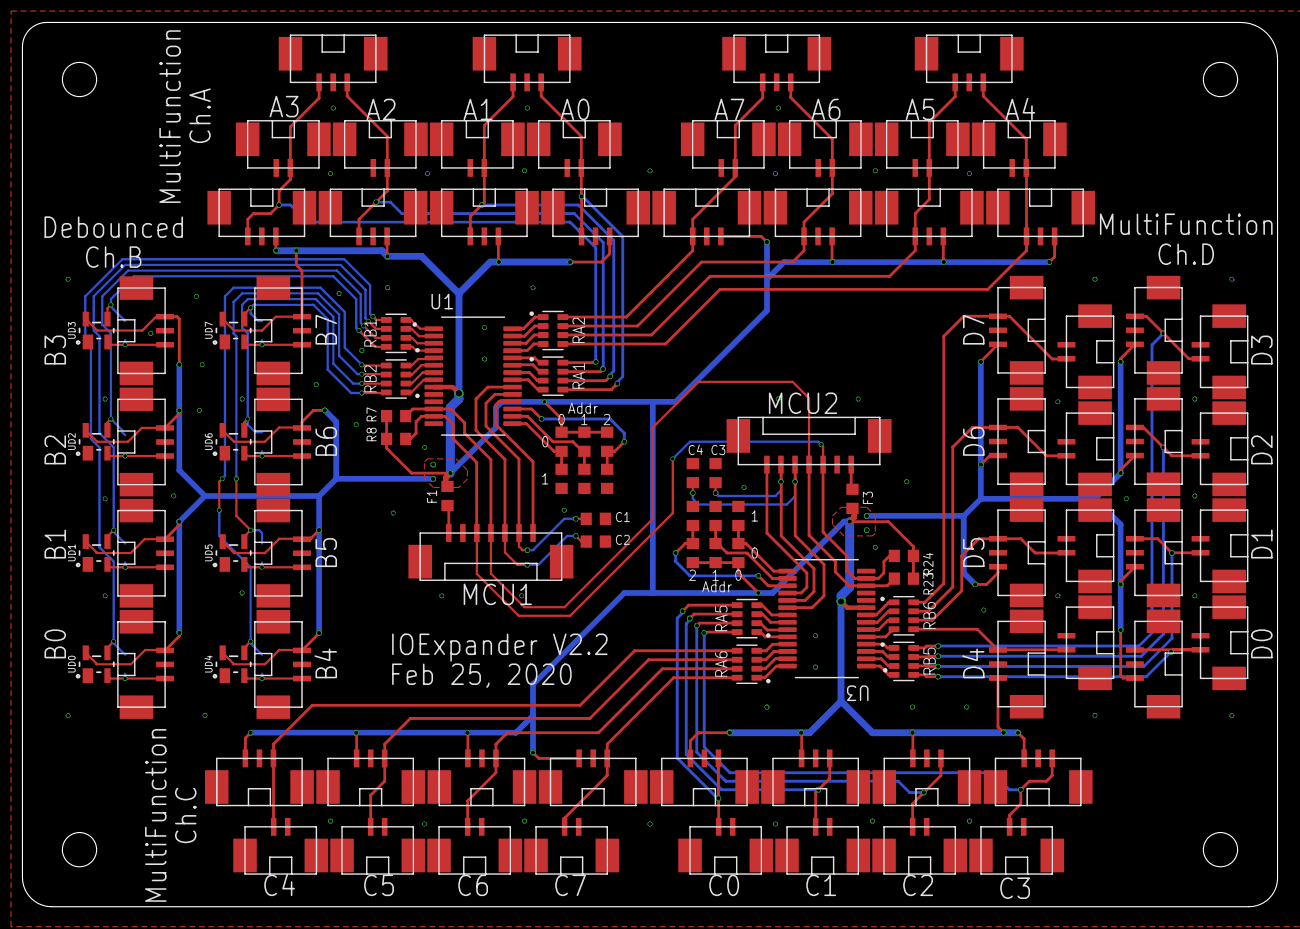
[picture p77: board IOExpander.brd from above]

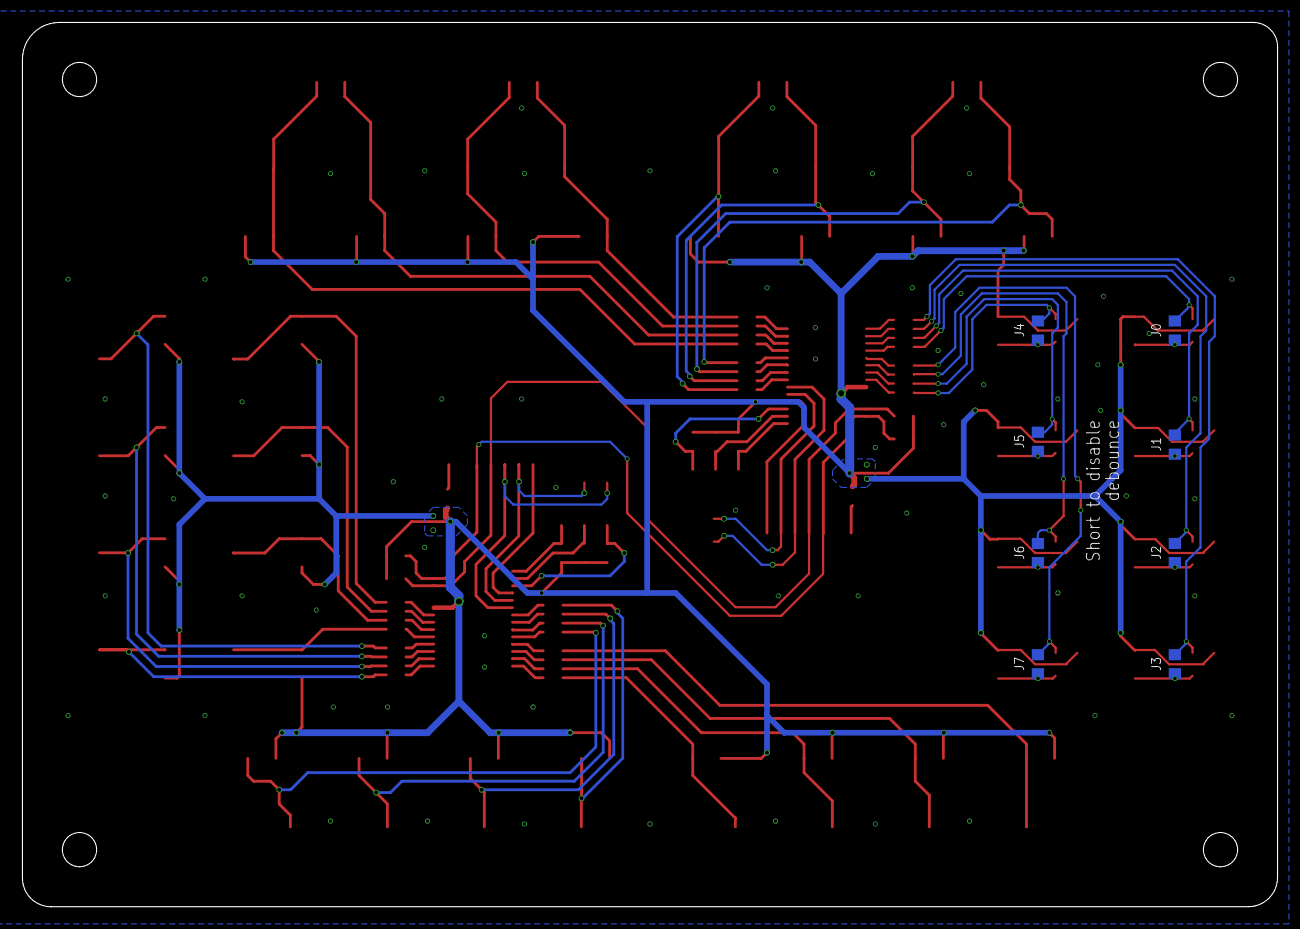
[picture p78: board IOExpander.brd from below]

Board: 2 copper layers, 111.8 x 78.7 mm, 114 parts (8 on the bottom side), 90 nets.
