SentinelPolaris/ECE115project/Electrical/PCB/TeensyBreakout/TeensyBreakout.brd

## EAGLE design Electrical/PCB/TeensyBreakout/TeensyBreakout.brd (2020-03-10)

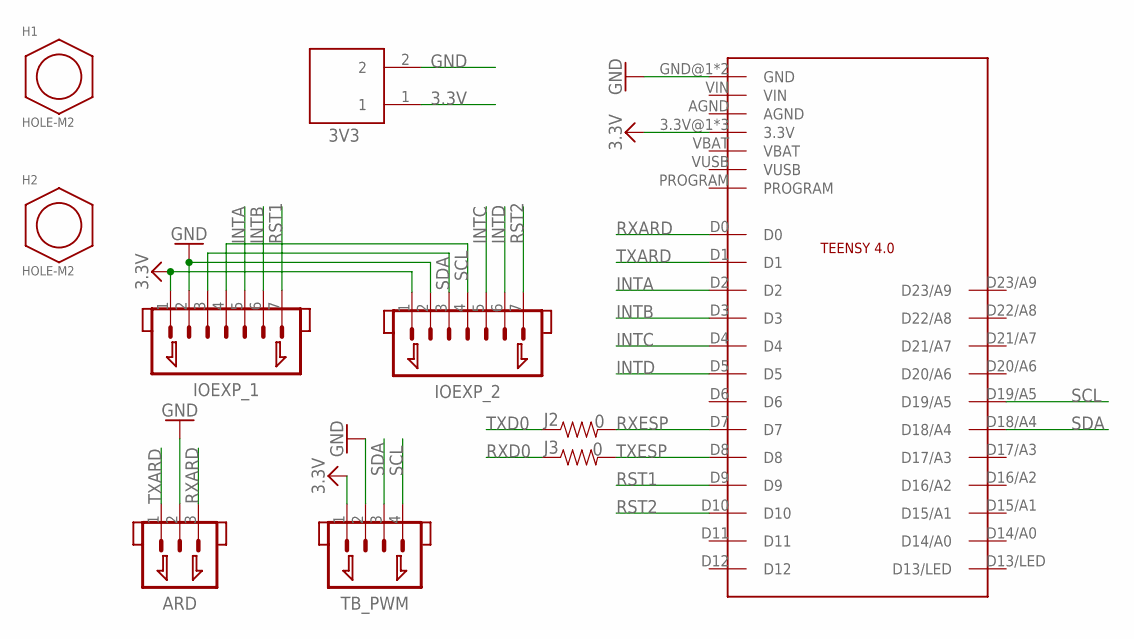
[picture p79: schematic TeensyBreakout.sch, sheet 1]

Parts:
3V3: TERMINAL; ED555/2DS
ARD: JST_1.25_3P; JST1.25_3P
H1, H2: HOLE-M2; M2
IOEXP_1, IOEXP_2: JST_1.25_7P; JST1.25_7P
J2, J3: 0; 0603
TB_PWM: JST_1.25_4P; JST1.25_4P
U$1: TEENSY4.0

Connections:
3.3V: 3V3.1, IOEXP_1.1, IOEXP_2.1, TB_PWM.1, U$1.3.3V@1 (3.3V), U$1.3.3V@2 (3.3V), U$1.ON/OFF (3.3V); also elsewhere on the board
GND: 3V3.2, ARD.2, IOEXP_1.2, IOEXP_2.2, TB_PWM.2, U$1.GND@1 (GND), U$1.GND@2 (GND); also elsewhere on the board
INTA: IOEXP_1.5, U$1.D2
INTB: IOEXP_1.6, U$1.D3
INTC: IOEXP_2.5, U$1.D4
INTD: IOEXP_2.6, U$1.D5
RST1: IOEXP_1.7, U$1.D9
RST2: IOEXP_2.7, U$1.D10
RXARD: ARD.3, U$1.D0
RXD0: J3.1; also elsewhere on the board
RXESP: J2.2, U$1.D7
SCL: IOEXP_1.4, IOEXP_2.4, TB_PWM.4, U$1.D19/A5
SDA: IOEXP_1.3, IOEXP_2.3, TB_PWM.3, U$1.D18/A4
TXARD: ARD.1, U$1.D1
TXD0: J2.1; also elsewhere on the board
TXESP: J3.2, U$1.D8

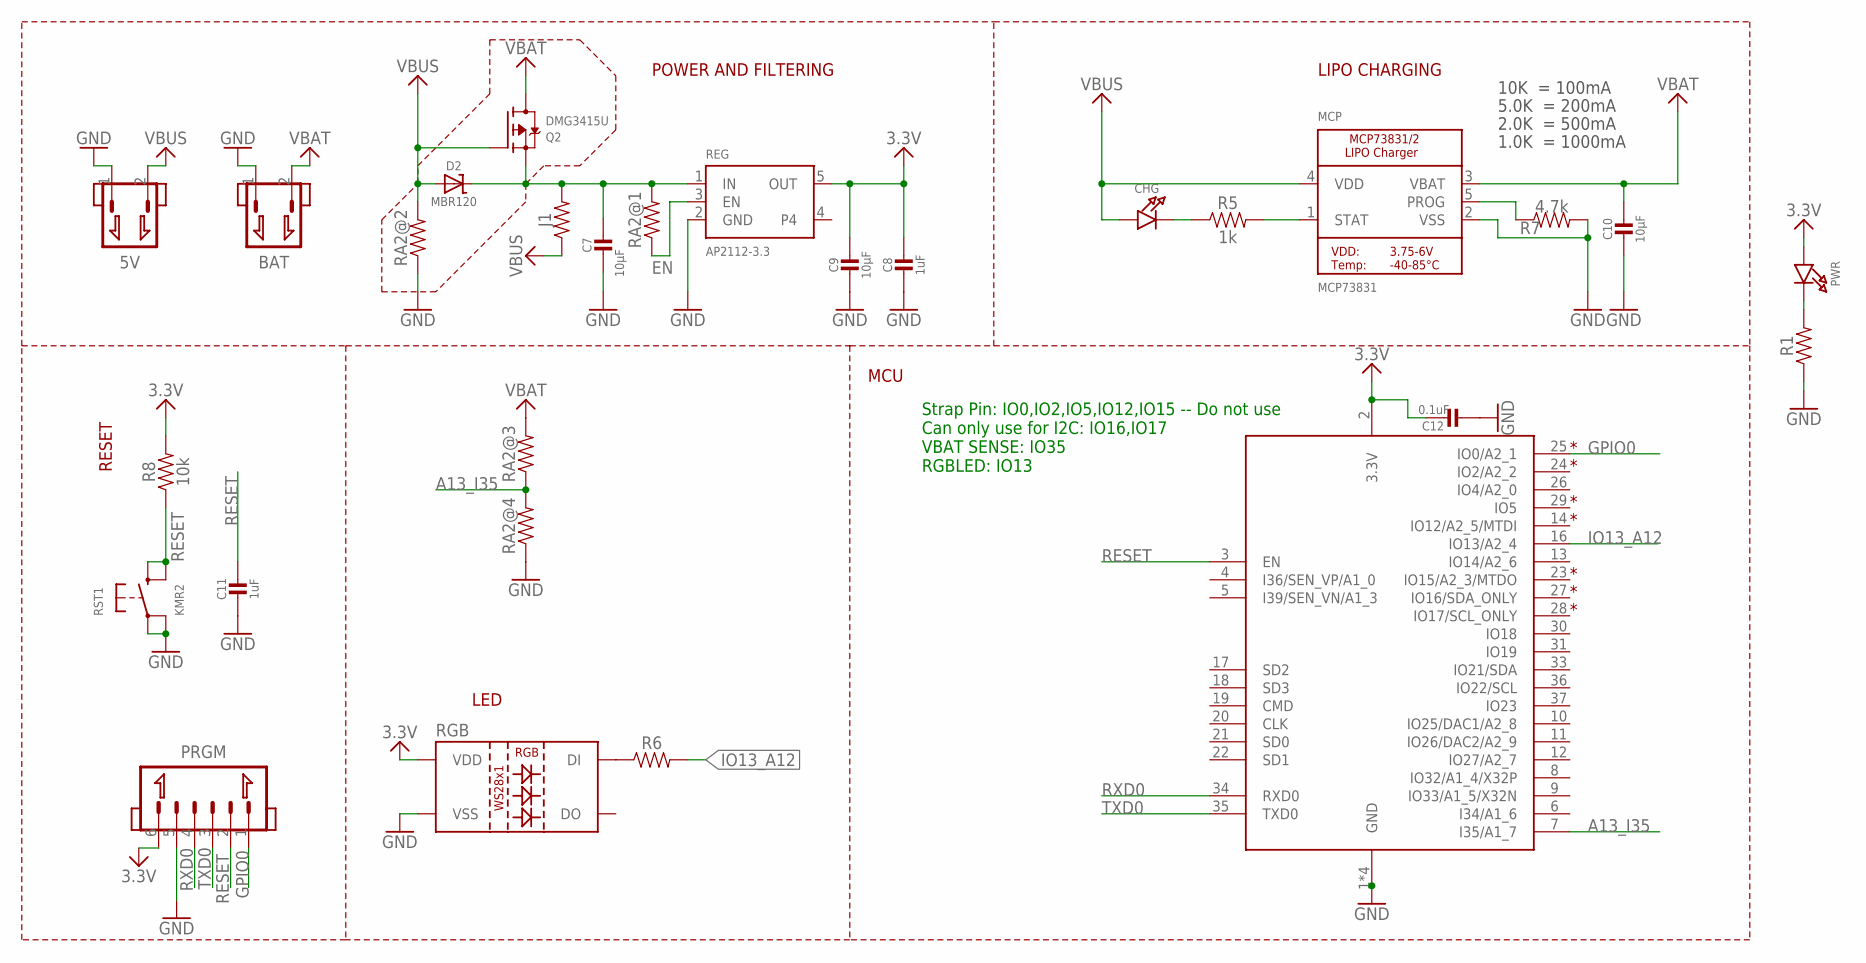
[picture p80: schematic TeensyBreakout.sch, sheet 2]

Parts:
5V: JST_PH_2.0_2P
BAT: JSTPH; JST_PH_2.0_2P
C7, C10: 10µF; 0805
C8, C11: 1uF; 0603
C9: 10µF; 0603
C12: 0.1uF; 0603
CHG: LED0603; CHIPLED_0603
D2: MBR120; SOD-123
J1: 0603
MCP: MCP73831; MICROBUILDER_SOT23-5
PRGM: JST_1.25_6P; JST1.25_6P
PWR: LED0603; CHIPLED_0603
Q2: DMG3415U; SOT23-WIDE
R1, R6: 0603
R5: 1k; 0603
R7: 4.7k; 0603
R8: 10k; 0603
RA2: RESISTOR_ARRAY_1206_SEPARATE_REVERSE; RESCAF80P320X160X60-8N
REG: AP2112-3.3; MICROBUILDER_SOT23-5
RGB: LED_WS2812; LED-TRICOLOR-5050-IC
RST1: KMR2; BTN_KMR2_4.6X2.8
X1: ESP32_WROOM32; WROOM32

Connections:
3.3V: C8.1, C9.1, C12.1, PRGM.6, PWR.A, R8.2, REG.5 (OUT), RGB.VDD, X1.2 (3.3V); also elsewhere on the board
A13_I35: RA2.4 (2), RA2.6 (1), X1.7 (I35/A1_7)
EN: RA2.8 (1), REG.3 (EN)
GND: 5V.1, BAT.1, C7.2, C8.2, C9.2, C10.2, C11.2, C12.2, MCP.2 (VSS), PRGM.5, R1.1, R7.2, RA2.5 (1), RA2.7 (1), REG.2 (GND), RGB.VSS, RST1.A, RST1.A' (P1), X1.1 (GND), X1.15 (GND), X1.38 (GND), X1.P$1 (GND); also elsewhere on the board
GPIO0: PRGM.1, X1.25 (IO0/A2_1)
IO13_A12: R6.2, X1.16 (IO13/A2_4)
unnamed: PWR.C, R1.2
unnamed: CHG.C, R5.1
unnamed: MCP.1 (STAT), R5.2
unnamed: MCP.5 (PROG), R7.1
unnamed: C7.1, D2.C, J1.2, Q2.2 (S), RA2.1 (2), REG.1 (IN)
unnamed: R6.1, RGB.DIN (DI)
RESET: C11.1, PRGM.2, R8.1, RST1.B (S), RST1.B' (S1), X1.3 (EN)
RXD0: PRGM.4, X1.34 (RXD0); also elsewhere on the board
TXD0: PRGM.3, X1.35 (TXD0); also elsewhere on the board
VBAT: BAT.2, C10.1, MCP.3 (VBAT), Q2.3 (D), RA2.3 (2)
VBUS: 5V.2, CHG.A, D2.A, J1.1, MCP.4 (VDD), Q2.1 (G), RA2.2

Notes on the sheet:
POWER AND FILTERING
RESET
10K = 100mA
5.0K = 200mA
2.0K = 500mA
1.0K = 1000mA
LIPO CHARGING
LED
Strap Pin: IO0,IO2,IO5,IO12,IO15 -- Do not use Can only use for I2C: IO16,IO17 VBAT SENSE: IO35 RGBLED: IO13
MCU

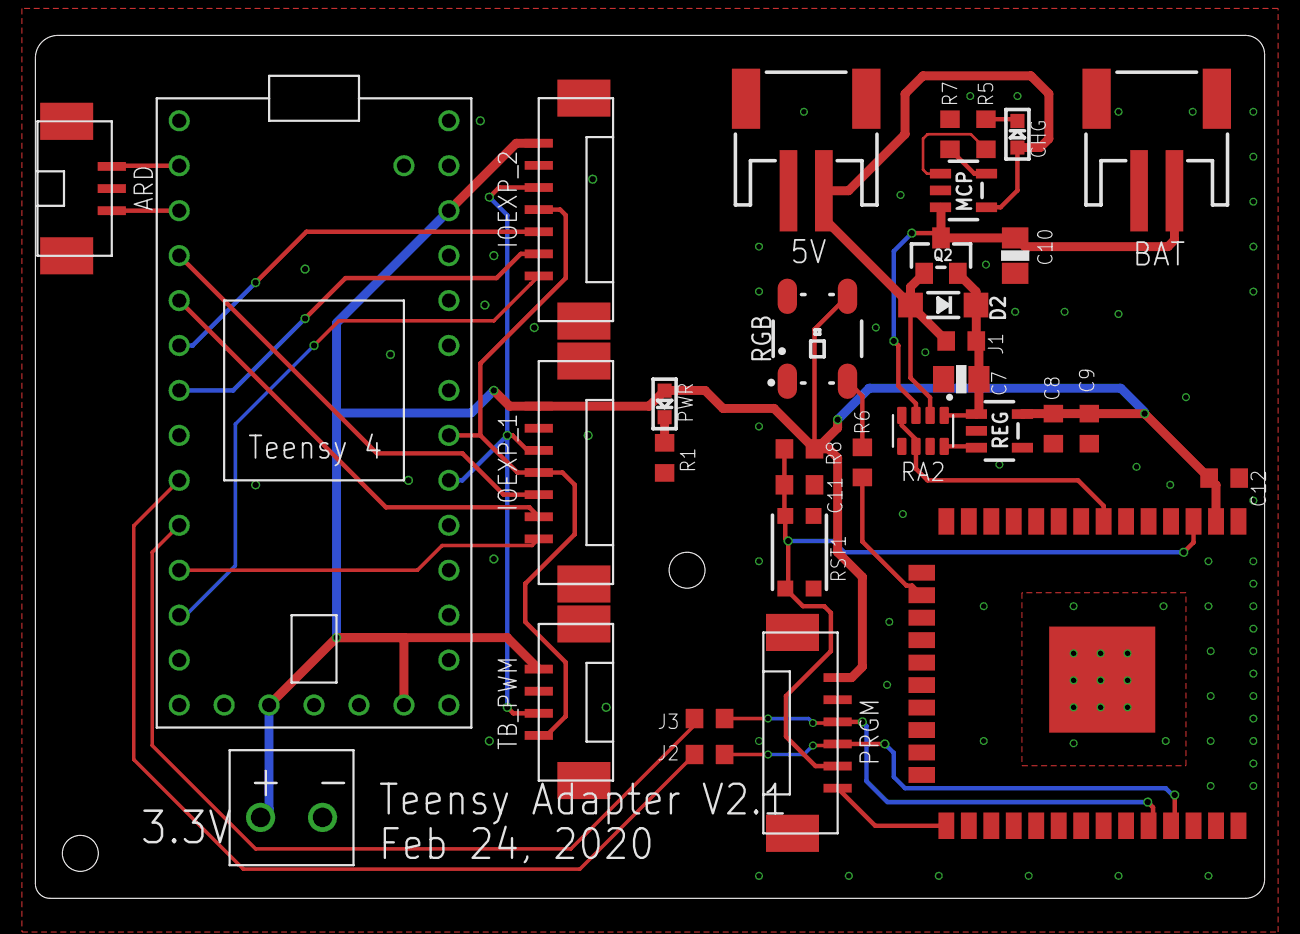
[picture p81: board TeensyBreakout.brd from above]

Board: 2 copper layers, 69.5 x 48.8 mm, 35 parts (0 on the bottom side), 29 nets.
