SentinelPolaris/ECE115project/Electrical/PCB/IRGate/IRGate.brd

## EAGLE design Electrical/PCB/IRGate/IRGate.brd (2020-01-17)

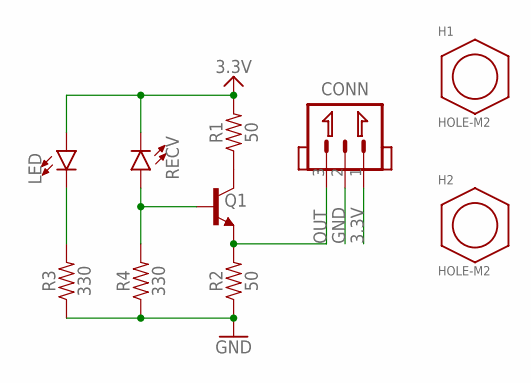
[picture p82: schematic IRGate.sch]

Parts:
CONN: JST_1.25_3P; JST1.25_3P
H1, H2: HOLE-M2; M2
LED: LED-IRTSAL6100; LED_5MM
Q1: NPNSOT23-3; SOT23-3
R1, R2: 50; 0603
R3, R4: 330; 0603
RECV: LED-IRSIDE_EMITTER; LTE-302

Connections:
3.3V: CONN.1, LED.A, R1.2, RECV.C
GND: CONN.2, R2.1, R3.1, R4.1
unnamed: Q1.3 (C), R1.1
unnamed: Q1.1 (B), R4.2, RECV.A
unnamed: LED.K (C), R3.2
OUT: CONN.3, Q1.2 (E), R2.2

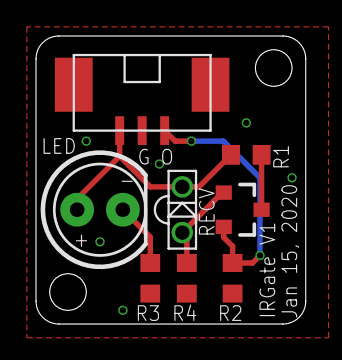
[picture p83: board IRGate.brd from above]

Board: 2 copper layers, 15.0 x 16.0 mm, 10 parts (0 on the bottom side), 6 nets.
