SentinelPolaris/ECE115project/Electrical/PCB/MultiTB/MultiTB.brd

## EAGLE design Electrical/PCB/MultiTB/MultiTB.brd (2020-01-17)

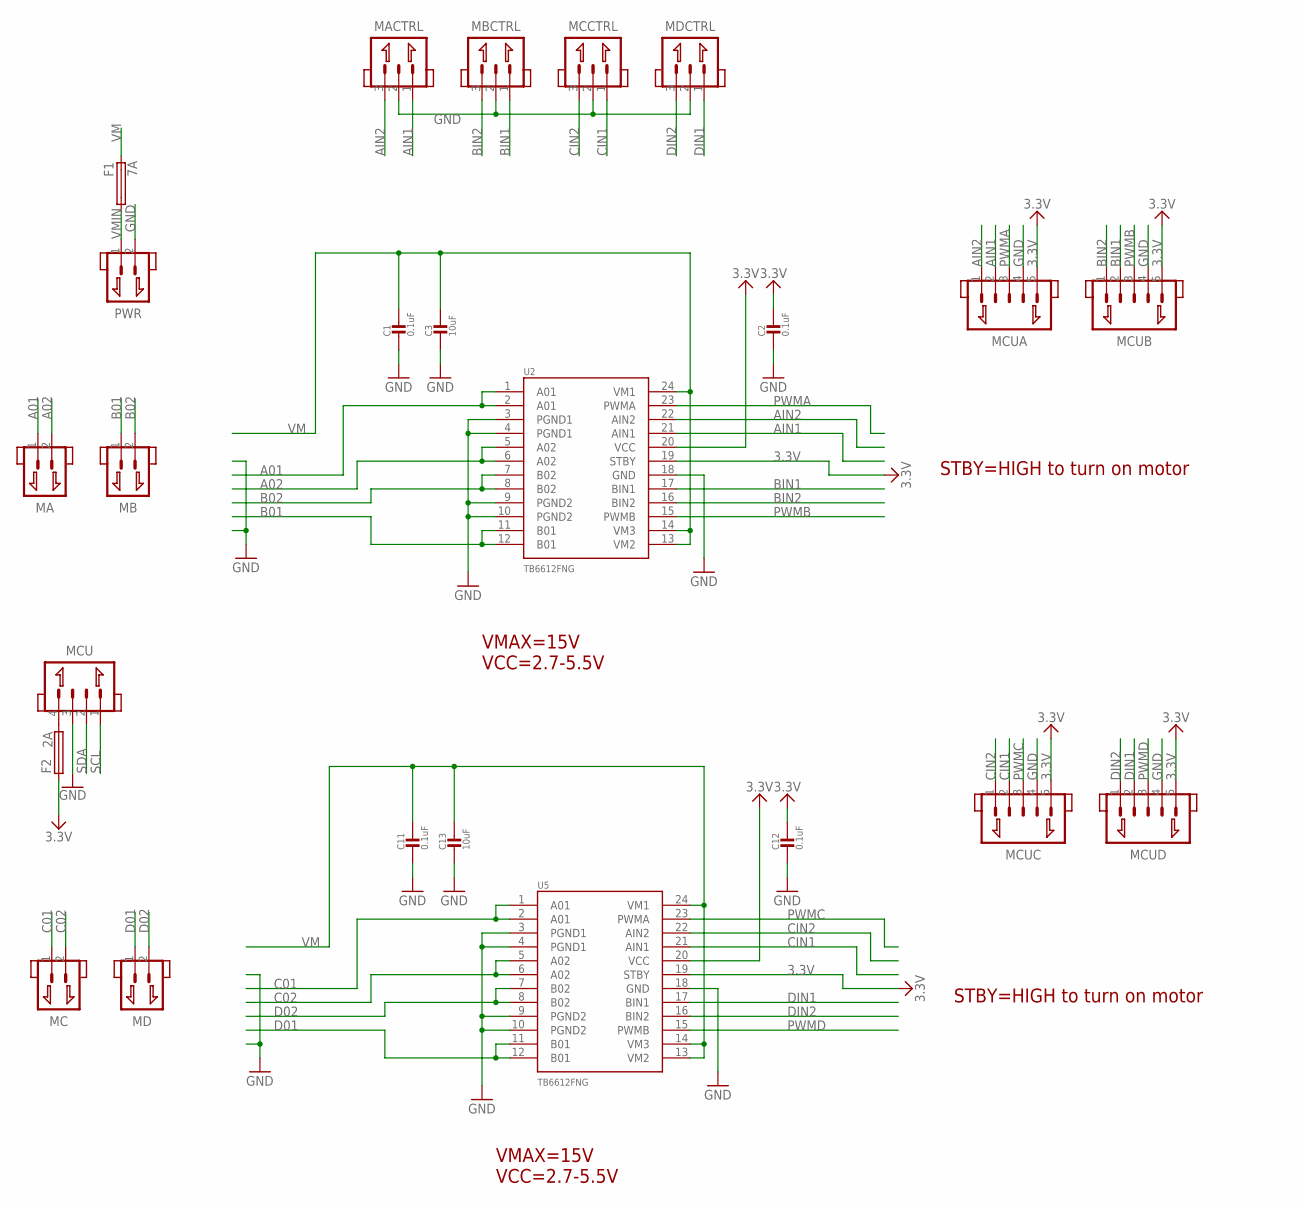
[picture p84: schematic MultiTB.sch, sheet 1]

Parts:
C1, C2, C11, C12: 0.1uF; 0603
C3, C13: 10uF; 0805
F1: 7A; 1206
F2: 2A; 0603
MA: JST_XH_2.54_2P
MACTRL: JST_1.25_3P; JST1.25_3P
MB: JST_XH_2.54_2P
MBCTRL: JST_1.25_3P; JST1.25_3P
MC: JST_XH_2.54_2P
MCCTRL: JST_1.25_3P; JST1.25_3P
MCU: JST_1.25_4P; JST1.25_4P
MCUA: JST_1.25_5P; JST1.25_5P
MCUB: JST_1.25_5P; JST1.25_5P
MCUC: JST_1.25_5P; JST1.25_5P
MCUD: JST_1.25_5P; JST1.25_5P
MD: JST_XH_2.54_2P
MDCTRL: JST_1.25_3P; JST1.25_3P
PWR: JST_XH_2.54_2P
U2, U5: TB6612FNG; SSOP24

Connections:
3.3V: C2.1, C12.1, F2.1, MCUA.5, MCUB.5, MCUC.5, MCUD.5, U2.19 (STBY), U2.20 (VCC), U5.19 (STBY), U5.20 (VCC); also elsewhere on the board
A01: MA.1, U2.1 (A01), U2.2 (A01)
A02: MA.2, U2.5 (A02), U2.6 (A02)
AIN1: MACTRL.1, MCUA.2, U2.21 (AIN1)
AIN2: MACTRL.3, MCUA.1, U2.22 (AIN2)
B01: MB.1, U2.11 (B01), U2.12 (B01)
B02: MB.2, U2.7 (B02), U2.8 (B02)
BIN1: MBCTRL.1, MCUB.2, U2.17 (BIN1)
BIN2: MBCTRL.3, MCUB.1, U2.16 (BIN2)
C01: MC.1, U5.1 (A01), U5.2 (A01)
C02: MC.2, U5.5 (A02), U5.6 (A02)
CIN1: MCCTRL.1, MCUC.2, U5.21 (AIN1)
CIN2: MCCTRL.3, MCUC.1, U5.22 (AIN2)
D01: MD.1, U5.11 (B01), U5.12 (B01)
D02: MD.2, U5.7 (B02), U5.8 (B02)
DIN1: MCUD.2, MDCTRL.1, U5.17 (BIN1)
DIN2: MCUD.1, MDCTRL.3, U5.16 (BIN2)
GND: C1.2, C2.2, C3.2, C11.2, C12.2, C13.2, MACTRL.2, MBCTRL.2, MCCTRL.2, MCU.3, MCUA.4, MCUB.4, MCUC.4, MCUD.4, MDCTRL.2, PWR.2, U2.3 (PGND1), U2.4 (PGND1), U2.9 (PGND2), U2.10 (PGND2), U2.18 (GND), U5.3 (PGND1), U5.4 (PGND1), U5.9 (PGND2), U5.10 (PGND2), U5.18 (GND); also elsewhere on the board
unnamed: F2.2, MCU.4
PWMA: MCUA.3, U2.23 (PWMA); also elsewhere on the board
PWMB: MCUB.3, U2.15 (PWMB); also elsewhere on the board
PWMC: MCUC.3, U5.23 (PWMA); also elsewhere on the board
PWMD: MCUD.3, U5.15 (PWMB); also elsewhere on the board
SCL: MCU.1; also elsewhere on the board
SDA: MCU.2; also elsewhere on the board
VM: C1.1, C3.1, C11.1, C13.1, F1.2, U2.13 (VM2), U2.14 (VM3), U2.24 (VM1), U5.13 (VM2), U5.14 (VM3), U5.24 (VM1)
VMIN: F1.1, PWR.1

Notes on the sheet:
VMAX=15V VCC=2.7-5.5V
STBY=HIGH to turn on motor

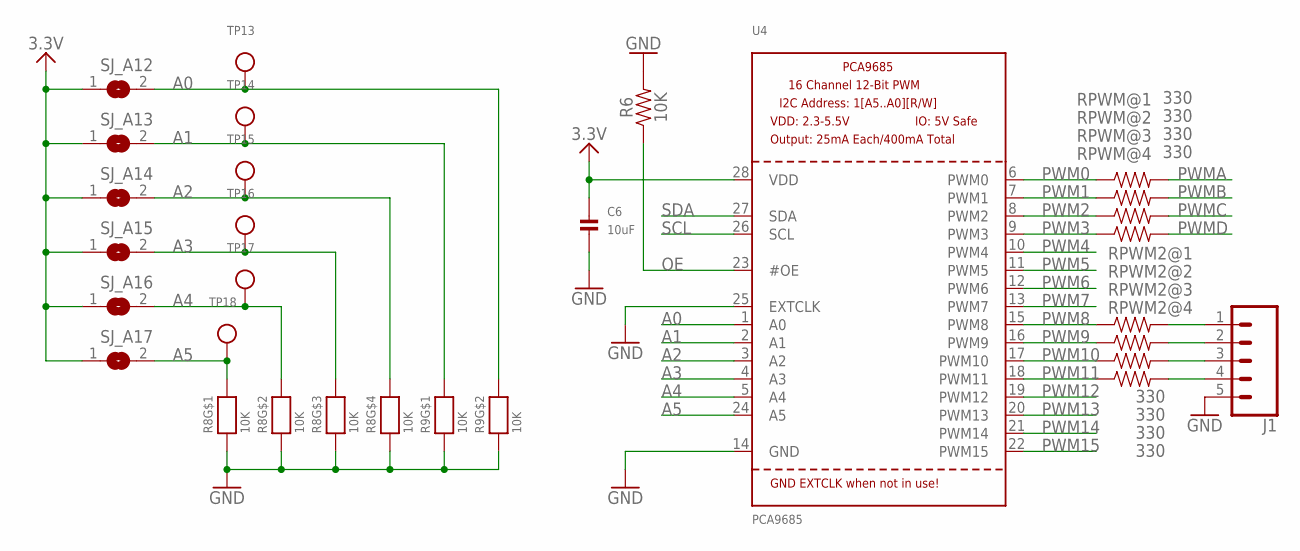
[picture p85: schematic MultiTB.sch, sheet 2]

Parts:
C6: 10uF; 0805
J1: CONN_05; 1X05
R6: 10K; 0603
R8, R9: 10K; RESPACK_4X0603
RPWM, RPWM2: 330; RESCAF80P320X160X60-8N
SJ_A12, SJ_A13, SJ_A14, SJ_A15, SJ_A16, SJ_A17: SOLDERJUMPERREFLOW_NOPASTE; SOLDERJUMPER_REFLOW_NOPASTE
TP13, TP14, TP15, TP16, TP17, TP18: TESTPOINTROUND2MM; TESTPOINT_ROUND_2MM
U4: PCA9685; TSSOP28

Connections:
3.3V: C6.1, SJ_A12.1, SJ_A13.1, SJ_A14.1, SJ_A15.1, SJ_A16.1, SJ_A17.1, U4.28 (VDD); also elsewhere on the board
A0: R9.7 (2), SJ_A12.2, TP13.P$1, U4.1 (A0)
A1: R9.8 (2), SJ_A13.2, TP14.P$1, U4.2 (A1)
A2: R8.5 (2), SJ_A14.2, TP15.P$1, U4.3 (A2)
A3: R8.6 (2), SJ_A15.2, TP16.P$1, U4.4 (A3)
A4: R8.7 (2), SJ_A16.2, TP17.P$1, U4.5 (A4)
A5: R8.8 (2), SJ_A17.2, TP18.P$1, U4.24 (A5)
GND: C6.2, J1.5, R6.2, R8.1, R8.2 (1), R8.3 (1), R8.4 (1), R9.1, R9.2 (1), U4.14 (GND), U4.25 (EXTCLK); also elsewhere on the board
unnamed: J1.1, RPWM2.1 (2)
unnamed: J1.2, RPWM2.2
unnamed: J1.3, RPWM2.3 (2)
unnamed: J1.4, RPWM2.4 (2)
OE: R6.1, U4.23 (#OE)
PWM0: RPWM.8 (1), U4.6 (PWM0)
PWM1: RPWM.7 (1), U4.7 (PWM1)
PWM2: RPWM.6 (1), U4.8 (PWM2)
PWM3: RPWM.5 (1), U4.9 (PWM3)
PWM4: U4.10 (PWM4)
PWM5: U4.11 (PWM5)
PWM6: U4.12 (PWM6)
PWM7: U4.13 (PWM7)
PWM8: RPWM2.8 (1), U4.15 (PWM8)
PWM9: RPWM2.7 (1), U4.16 (PWM9)
PWM10: RPWM2.6 (1), U4.17 (PWM10)
PWM11: RPWM2.5 (1), U4.18 (PWM11)
PWM12: U4.19 (PWM12)
PWM13: U4.20 (PWM13)
PWM14: U4.21 (PWM14)
PWM15: U4.22 (PWM15)
PWMA: RPWM.1 (2); also elsewhere on the board
PWMB: RPWM.2; also elsewhere on the board
PWMC: RPWM.3 (2); also elsewhere on the board
PWMD: RPWM.4 (2); also elsewhere on the board
SCL: U4.26 (SCL); also elsewhere on the board
SDA: U4.27 (SDA); also elsewhere on the board

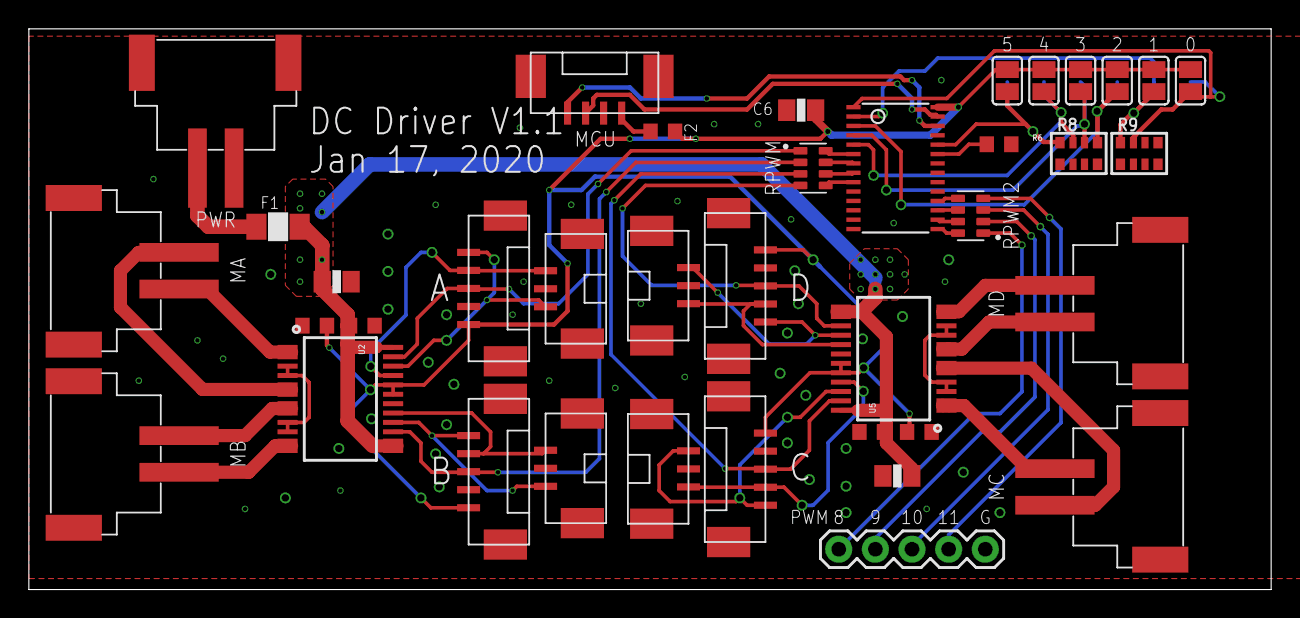
[picture p86: board MultiTB.brd from above]

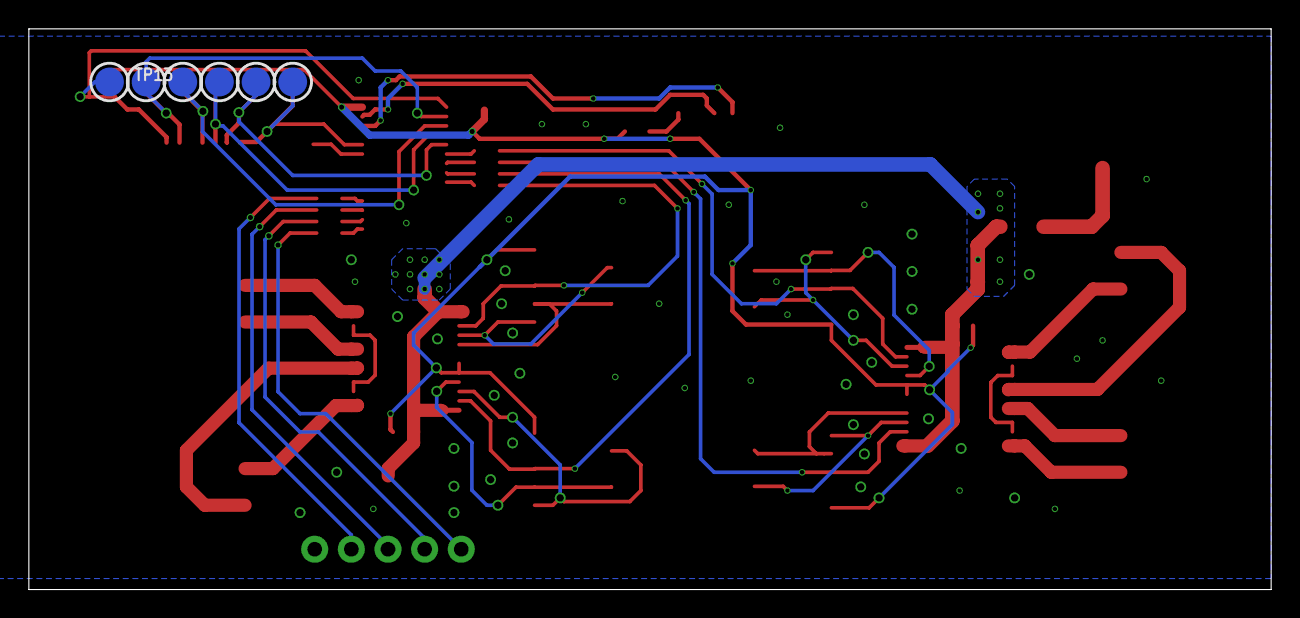
[picture p87: board MultiTB.brd from below]

Board: 2 copper layers, 86.1 x 38.9 mm, 44 parts (6 on the bottom side), 46 nets.
