SentinelPolaris/ECE115project/Software/ESP/ESP.ino

#include <Arduino.h>
#include <WiFi.h>
#include <AsyncTCP.h>
#include <ESPAsyncWebServer.h>
#include <WebSerial.h>
#include <ESPmDNS.h>
#include <WiFiUdp.h>
#include <ArduinoOTA.h>

AsyncWebServer server(80);

const char* ssid = "ESP_Pinball"; // Your WiFi SSID
//const char* password = ""; // Your WiFi Password


void recvMsg(uint8_t *data, size_t len) {
  WebSerial.println("Received Data...");
  String d = "";
  for (int i = 0; i < len; i++) {
    d += char(data[i]);
  }
  WebSerial.println(d);
  Serial.print(d);
}

void setup() {
  Serial.begin(9600);
  // You can remove the password parameter if you want the AP to be open.
  WiFi.softAP(ssid);
  IPAddress myIP = WiFi.softAPIP();
  Serial.print("AP IP address: ");
  Serial.println(myIP);
  // WebSerial is accessible at "<IP Address>/webserial" in browser
  WebSerial.begin(&server);
  WebSerial.msgCallback(recvMsg);
  server.begin();

  ArduinoOTA
  .onStart([]() {
    String type;
    if (ArduinoOTA.getCommand() == U_FLASH)
      type = "sketch";
    else // U_SPIFFS
      type = "filesystem";

    // NOTE: if updating SPIFFS this would be the place to unmount SPIFFS using SPIFFS.end()
    Serial.println("Start updating " + type);
  })
  .onEnd([]() {
    Serial.println("\nEnd");
  })
  .onProgress([](unsigned int progress, unsigned int total) {
    Serial.printf("Progress: %u%%\r", (progress / (total / 100)));
  })
  .onError([](ota_error_t error) {
    Serial.printf("Error[%u]: ", error);
    if (error == OTA_AUTH_ERROR) Serial.println("Auth Failed");
    else if (error == OTA_BEGIN_ERROR) Serial.println("Begin Failed");
    else if (error == OTA_CONNECT_ERROR) Serial.println("Connect Failed");
    else if (error == OTA_RECEIVE_ERROR) Serial.println("Receive Failed");
    else if (error == OTA_END_ERROR) Serial.println("End Failed");
  });
  ArduinoOTA.begin();
}

void loop() {
  ArduinoOTA.handle();
  if (Serial.available()) {
    WebSerial.print(Serial.readString());
  }
}
