SentinelPolaris/ECE115project/Software/ioexp_test/detect/detect.ino

const byte ledPin = 13;
const byte interruptPin = 3;
volatile byte state = LOW;

void setup() {
  pinMode(ledPin, OUTPUT);
  pinMode(interruptPin, INPUT_PULLUP);
  attachInterrupt(digitalPinToInterrupt(interruptPin), blink, FALLING);
}

void loop() {
  digitalWrite(ledPin, state);
}

void blink() {
  state = !state;
}
