SentinelPolaris/ECE115project/(commit log)

2020-01-15 add cad files
    [1xtip.DXF, 2xbaseplate.DXF, 2xpullhandle.DXF, 8xholePlate.DXF, base plate.SLDPRT, hole plate.SLDPRT, launcherassem.SLDASM, pullhandle.SLDPRT]
2020-01-15 PCBs V1 WIP
    [IOExpander.brd, IOExpander.sch, IRGate.brd, IRGate.sch, MultiTB.brd, MultiTB.sch]
2020-01-17 PCB Batch #1
    [IOExpander.brd, IOExpander.sch, IRGate.brd, MultiTB.brd, MultiTB.sch, TeensyBreakout.brd, TeensyBreakout.sch]
2020-01-22 added filpper design
    [Flipper.SLDASM, base.SLDPRT, bearing.SLDPRT, flipper_arm.SLDPRT, flipper_back.SLDPRT, rod.SLDPRT]
2020-01-23 walls; final assembly init
    [Final.SLDASM, FrameBottomPlate.SLDPRT, FrameSideWall.SLDPRT, FrameTopWallBottom.SLDPRT, FrameTopWallTop.SLDPRT, N20Wheel.SLDPRT]
2020-01-27 cad files cleanup; ramp
    [Final.SLDASM, Flipper.SLDASM, Plunger.SLDASM, PlungerRod.SLDPRT, RampTop.SLDPRT, flipper_rod.SLDPRT, flipper_test_base.SLDPRT, rod.SLDPRT]
2020-01-28 bump 1/27
    [Final.SLDASM, FlipperTester.SLDASM, FrameSideWall.SLDPRT, FrameTopWallBottom.SLDPRT, FrameTopWallTop.SLDPRT, RampTop.SLDPRT]
2020-01-28 servo ATTiny85 code
2020-01-30 fix servo randomly stop (software servo)
    [SoftwareServo.h, sweep.ino]
2020-01-30 add servo cad
    [Final.SLDASM, FrameTopWallBottom.SLDPRT, FrameTopWallTop.SLDPRT, microservoArm.SLDPRT, microservoArm.STL, microservoArmV2.STL, microservoAssembly.SLDASM, microservoAssembly.STEP]
2020-01-30 tunnel walls, IR gate, flipper asm
    [Final.SLDASM, FlipperLeft.SLDASM, FlipperRight.SLDASM, FrameBottomPlate.SLDPRT, FrameSideWall.SLDPRT, FrameTopWallBottom.SLDPRT, FrameTopWallTop.SLDPRT, FrameTunnelWall.SLDPRT]
2020-01-31 bump cad 1/31
    [Final.SLDASM, FrameTopWallTop.SLDPRT, Plunger.SLDASM, TunnelRamp.SLDPRT]
2020-01-31 Add EM guide
    [EMGuide.SLDPRT, Final.SLDASM, TunnelRamp.SLDPRT]
2020-01-31 cad ramp servo update
    [Final.SLDASM, RampTop.SLDPRT, RampTop_new.SLDPRT, Servo.SLDASM, ServoRamp.SLDASM, microservoArm.SLDPRT, microservoAssembly.SLDASM, microservoAssembly.STEP]
2020-02-01 ramp v1
    [RampTop.SLDPRT, RampTop_new.SLDPRT]
2020-02-01 Add solenoid
    [Final.SLDASM, Servo.SLDASM, ServoRamp.SLDASM, Solenoid.SLDASM, TAU-1040T Plunger.SLDPRT, TAU-1040T.SLDPRT]
2020-02-03 teensy init drivers etc
2020-02-03 bump cad 2/3
    [Final.SLDASM, FrameBottomPlate.SLDPRT, FrameSideWall.SLDPRT, FrameTopWallBottom.SLDPRT, FrameTopWallTop.SLDPRT, RampTop.SLDPRT, SliderWall.SLDPRT]
2020-02-04 pwm working; pwm test thread
2020-02-05 bump software 2/5; a lot of struggle in getting interrupt on ioexp to work :/
2020-02-06 io interrupt from mcp working; refactor
2020-02-07 bump cad 2/7
    [Final.SLDASM, FlipperRight.SLDASM, FrameTopWallBottom.SLDPRT, FrameTopWallTop.SLDPRT, RampTop.SLDPRT, Servo.SLDASM, ServoRamp.SLDASM]
2020-02-10 soldnoid/ramp guides
    [Final.SLDASM, FrameBottomPlate.SLDPRT, FrameSideWall.SLDPRT, FrameTopWallBottom.SLDPRT, FrameTopWallTop.SLDPRT, RampGuide.SLDPRT, RampTop.SLDPRT, ServoRamp.SLDASM]
2020-02-14 added launcher coil
    [magnetic launcher.SLDPRT]
2020-02-14 ramp update; em launcher
    [Final.SLDASM, MagneticLauncher.SLDPRT, RampTop.SLDPRT, ServoRamp.SLDASM, magnetic launcher.SLDPRT]
2020-02-14 cad bump 2/14
    [Final.SLDASM, IRGate.SLDPRT]
2020-02-14 bump cad 2/14
    [EMGuide.SLDPRT, Final.SLDASM, FlipperLeft.SLDASM, FlipperRight.SLDASM, FrameBottomPlate.SLDPRT, FrameSideWall.SLDPRT, FrameSideWallLeft.SLDPRT, FrameSideWallRight.SLDPRT]
2020-02-16 bump cad 2/15
    [Brazo M.STEP, Brazo.SLDPRT, Final.SLDASM, FrameBottomPlate.SLDPRT, FrameSideWallLeft.SLDPRT, FrameSideWallRight.SLDPRT, FrameTopWallBottom.SLDPRT, FrameTopWallTop.SLDPRT]
2020-02-18 add rgb panel
    [EMlauncherGuide.SLDPRT, Final.SLDASM, FrameBottomPlate.SLDPRT, FrameBottomWall.SLDPRT, FrameSideWallLeft.SLDPRT, FrameSideWallRight.SLDPRT, FrameTopWallBottom.SLDPRT, FrameTopWallTop.SLDPRT]
2020-02-18 more holes
    [FrameBottomWall.SLDPRT]
2020-02-21 add flipper holder
    [FlipperHolder.SLDPRT]
2020-02-24 teensyBreakout V2, debouncer
    [Debouncer.brd, Debouncer.sch, TeensyBreakout.brd, TeensyBreakout.sch]
2020-02-24 bump pcb 2/24
    [IOExpander.brd, IOExpander.sch, TeensyBreakout.brd, TeensyBreakout.sch]
2020-02-25 io expander fix V2.2 -- add 0.1uF to GND on IRQ pin
    [IOExpander.brd, IOExpander.sch]
2020-02-25 update working io expander interrupt code
2020-02-28 all task framework done
2020-02-28 cpu usage fix: updated freertos according to https://github.com/discord-intech/FreeRTOS-Teensy4/issues/3
    [tasks.cpp]
2020-02-28 os refactor; fixing audio wip (put audioplayer onto a separate teensy)
    [Audio.cpp, Audio.h, Audio.ino, interface.cpp, interface.h, ioexp.h, main.cpp, peri.h]
2020-03-01 audio working; solenoid working
2020-03-04 add playfield back support
    [AngleSupport.SLDPRT]
2020-03-06 Ramp V3
    [Final.SLDASM, RampTop.SLDPRT, ServoRamp.SLDASM]
2020-03-10 small addition
    [Final.SLDASM, FrameBottomPlate.DXF, FrameBottomWall.DXF, FrameSideWallLeft.DXF, FrameSideWallRight.DXF, FrameSideWallRight.SLDPRT, FrameSurrounddindBottom.DXF, FrameSurrounddindBottom.SLDPRT]
2020-03-10 fix solenoid bouncing 3/10
    [ESP.ino, arch.h, config.cpp, config.h, i2cscan.ino, interface.cpp, ioexp.h, main.cpp]
2020-03-11 working interrupt software 3/10
2020-03-12 fix motor
